patricecouillard-code/TrailerDiagnosticSystem/PCBReport.txt

Info: Processing symbol 'C201:SR305C334KAR:CAPRR508W50L762T381H762'.
Info: Processing symbol 'C202:FG26X7R1E106KRT06:CAPRB500W50L550T350H600'.
Info: Processing symbol 'C203:SR205C104KAR:CAPRR254W50L508T317H508'.
Info: Processing symbol 'C204:SR205C104KAR:CAPRR254W50L508T317H508'.
Info: Processing symbol 'C205:FG24X7R1H225KRT06:CAPRB500W50L450T300H550'.
Info: Processing symbol 'C206:CAPRR508W50L762T381H762:CAPRR508W50L762T381H762'.
Info: Processing symbol 'C207:FG26X7R1E106KRT06:CAPRB500W50L550T350H600'.
Info: Processing symbol 'C208:SR205C104KAR:CAPRR254W50L508T317H508'.
Info: Processing symbol 'C209:FG24X7R1H225KRT06:CAPRB500W50L450T300H550'.
Info: Processing symbol 'C210:SR205C104KAR:CAPRR254W50L508T317H508'.
Info: Processing symbol 'C301:Capacitor_THT:C_Rect_L19.0mm_W7.0mm_P15.00mm_MKS4'.
Info: Processing symbol 'C302:SR205C104KAR:CAPRR254W50L508T317H508'.
Info: Processing symbol 'C303:SR205C104KAR:CAPRR254W50L508T317H508'.
Info: Processing symbol 'C401:FG24X7R1H225KRT06:CAPRB500W50L450T300H550'.
Info: Processing symbol 'C2701:Capacitor_THT:C_Rect_L19.0mm_W7.0mm_P15.00mm_MKS4'.
Info: Processing symbol 'C3001:SR205C104KAR:CAPRR254W50L508T317H508'.
Info: Processing symbol 'D202:Diode_THT:D_DO-201AE_P15.24mm_Horizontal'.
Info: Processing symbol 'D204:PCM_Diode_THT_AKL:D_DO-35_SOD27_P7.62mm_Horizontal'.
Info: Processing symbol 'D501:PCM_Diode_THT_AKL:D_DO-35_SOD27_P7.62mm_Horizontal'.
Info: Processing symbol 'D502:PCM_Diode_THT_AKL:D_DO-35_SOD27_P7.62mm_Horizontal'.
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
Add Q3104 'Do not place' fabrication attribute.
Change Q2906 footprint from 'Package_TO_SOT_THT:TO-92_Inline' to 'PCM_Package_TO_SOT_THT_AKL:TO-92_Inline_Wide_SGD'.
Change Q3105 footprint from 'Package_TO_SOT_THT:TO-92_Inline' to 'PCM_Package_TO_SOT_THT_AKL:TO-92_Inline_Wide_SGD'.

Info: Total warnings: 0, errors: 0.
