patricecouillard-code/TrailerDiagnosticSystem/report - Copie.txt

Error: Update symbol D25 from 'OSX10201-GYR1.kicad_sym:OSX10201-GYR1' to 'OSX10201-GYR1.kicad_sym:OSX10201-GYR1': *** symbol not found ***
Update symbol U13 from 'Comparator:LM339' to 'Comparator:LM339': OK
Update symbol TH1 from 'Switch:SW_SPST_Temperature_NC' to 'Switch:SW_SPST_Temperature_NC': OK
Update symbol OC12 from 'PCM_Optocoupler_AKL:PC817' to 'PCM_Optocoupler_AKL:PC817': OK
Update symbol R206 from 'PCM_SL_Resistors:100k' to 'PCM_SL_Resistors:100k': OK
Update symbol D147 from 'PCM_LED_AKL:LED_1.8mm_Amber' to 'PCM_LED_AKL:LED_1.8mm_Amber': OK
Update symbol OC11 from 'PCM_Optocoupler_AKL:PC817' to 'PCM_Optocoupler_AKL:PC817': OK
Update symbol R195 from 'PCM_SL_Resistors:100k' to 'PCM_SL_Resistors:100k': OK
Update symbol R194 from 'PCM_SL_Resistors:4.7k' to 'PCM_SL_Resistors:4.7k': OK
Update symbol R207 from 'PCM_SL_Resistors:100k' to 'PCM_SL_Resistors:100k': OK
Update symbol Q54 from 'Transistor_FET:2N7000' to 'Transistor_FET:2N7000': OK
Update symbol R188 from 'PCM_SL_Devices:Resistor_5W' to 'PCM_SL_Devices:Resistor_5W': OK
Update symbol R205 from 'PCM_SL_Resistors:4.7k' to 'PCM_SL_Resistors:4.7k': OK
Update symbol U14 from 'Comparator:LM339' to 'Comparator:LM339': OK
Update symbol U14 from 'Comparator:LM339' to 'Comparator:LM339': OK
Update symbol R45 from 'PCM_SL_Resistors:4.7k' to 'PCM_SL_Resistors:4.7k': OK
Update symbol J3 from 'Connector_Generic:Conn_01x10' to 'Connector_Generic:Conn_01x10': OK
Update symbol J4 from 'Connector_Generic:Conn_01x10' to 'Connector_Generic:Conn_01x10': OK
Update symbol R203 from 'Simulation_SPICE:Potentiometer' to 'Simulation_SPICE:Potentiometer': OK
Update symbol D47 from 'PCM_Diode_AKL:1N4148' to 'PCM_Diode_AKL:1N4148': OK
Update symbol D41 from 'PCM_Diode_AKL:1N4148' to 'PCM_Diode_AKL:1N4148': OK
Update symbol D30 from 'PCM_Diode_AKL:1N4148' to 'PCM_Diode_AKL:1N4148': OK
Update symbol R41 from 'PCM_SL_Resistors:4.7k' to 'PCM_SL_Resistors:4.7k': OK
Update symbol U14 from 'Comparator:LM339' to 'Comparator:LM339': OK
Update symbol SW8 from 'Switch:SW_SPST' to 'Switch:SW_SPST': OK
Update symbol Q52 from 'PCM_Transistor_MOSFET_AKL:IRLZ44N' to 'PCM_Transistor_MOSFET_AKL:IRLZ44N': OK
Update symbol R66 from 'PCM_SL_Resistors:4.7k' to 'PCM_SL_Resistors:4.7k': OK
Update symbol D44 from 'PCM_Diode_AKL:1N4148' to 'PCM_Diode_AKL:1N4148': OK
Update symbol D28 from 'PCM_Diode_AKL:1N4148' to 'PCM_Diode_AKL:1N4148': OK
Update symbol #PWR03 from 'power:GND' to 'power:GND': OK
Update symbol R200 from 'PCM_SL_Resistors:10k' to 'PCM_SL_Resistors:10k': OK
Update symbol U14 from 'Comparator:LM339' to 'Comparator:LM339': OK
Update symbol D146 from 'PCM_Diode_TVS_AKL:SMBJ33A' to 'PCM_Diode_TVS_AKL:SMBJ33A': OK
Update symbol U14 from 'Comparator:LM339' to 'Comparator:LM339': OK
Update symbol F7 from 'Device:Polyfuse' to 'Device:Polyfuse': OK
Update symbol #PWR05 from 'power:GND' to 'power:GND': OK
Update symbol R204 from 'PCM_SL_Resistors:4.7k' to 'PCM_SL_Resistors:4.7k': OK
Update symbol R202 from 'Simulation_SPICE:Potentiometer' to 'Simulation_SPICE:Potentiometer': OK
Update symbol R201 from 'PCM_SL_Resistors:4.7k' to 'PCM_SL_Resistors:4.7k': OK
Update symbol R40 from 'PCM_SL_Resistors:4.7k' to 'PCM_SL_Resistors:4.7k': OK
Update symbol R51 from 'PCM_SL_Resistors:330ohm' to 'PCM_SL_Resistors:330ohm': OK
Update symbol D34 from 'PCM_Diode_AKL:1N4148' to 'PCM_Diode_AKL:1N4148': OK
Update symbol D38 from 'PCM_Diode_AKL:1N4148' to 'PCM_Diode_AKL:1N4148': OK
Update symbol Q13 from 'Transistor_FET:2N7000' to 'Transistor_FET:2N7000': OK
Update symbol D40 from 'PCM_Diode_AKL:1N4148' to 'PCM_Diode_AKL:1N4148': OK
Update symbol D42 from 'PCM_Diode_AKL:1N4148' to 'PCM_Diode_AKL:1N4148': OK
Update symbol R46 from 'PCM_SL_Resistors:4.7k' to 'PCM_SL_Resistors:4.7k': OK
Update symbol R50 from 'PCM_SL_Resistors:4.7k' to 'PCM_SL_Resistors:4.7k': OK
Update symbol R190 from 'PCM_SL_Resistors:4.7k' to 'PCM_SL_Resistors:4.7k': OK
Update symbol D49 from 'Device:LED_ARGB' to 'Device:LED_ARGB': OK
Update symbol R193 from 'PCM_SL_Resistors:4.7k' to 'PCM_SL_Resistors:4.7k': OK
Update symbol D27 from 'PCM_Diode_AKL:1N4148' to 'PCM_Diode_AKL:1N4148': OK
Update symbol D32 from 'PCM_Diode_AKL:1N4148' to 'PCM_Diode_AKL:1N4148': OK
Update symbol D46 from 'PCM_Diode_AKL:1N4148' to 'PCM_Diode_AKL:1N4148': OK
Update symbol R39 from 'PCM_SL_Resistors:4.7k' to 'PCM_SL_Resistors:4.7k': OK
Update symbol Q16 from 'Transistor_FET:2N7000' to 'Transistor_FET:2N7000': OK
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
Update symbol D110 from 'PCM_Diode_AKL:1N4148' to 'PCM_Diode_AKL:1N4148': OK
Update symbol D112 from 'PCM_Diode_AKL:1N4148' to 'PCM_Diode_AKL:1N4148': OK
Update symbol U9 from 'Comparator:LM339' to 'Comparator:LM339': OK
Update symbol U9 from 'Comparator:LM339' to 'Comparator:LM339': OK
Update symbol U9 from 'Comparator:LM339' to 'Comparator:LM339': OK
Update symbol D118 from 'PCM_Diode_AKL:1N4148' to 'PCM_Diode_AKL:1N4148': OK
Update symbol R132 from 'Simulation_SPICE:Potentiometer' to 'Simulation_SPICE:Potentiometer': OK
Update symbol U9 from 'Comparator:LM339' to 'Comparator:LM339': OK
Update symbol R123 from 'PCM_SL_Devices:Resistor_5W' to 'PCM_SL_Devices:Resistor_5W': OK
Update symbol R130 from 'PCM_SL_Resistors:10k' to 'PCM_SL_Resistors:10k': OK
Update symbol D104 from 'PCM_Diode_AKL:1N4148' to 'PCM_Diode_AKL:1N4148': OK
Update symbol R145 from 'PCM_SL_Resistors:4.7k' to 'PCM_SL_Resistors:4.7k': OK
Update symbol R140 from 'PCM_SL_Resistors:4.7k' to 'PCM_SL_Resistors:4.7k': OK
Update symbol R148 from 'PCM_SL_Resistors:4.7k' to 'PCM_SL_Resistors:4.7k': OK
Update symbol R128 from 'PCM_SL_Resistors:4.7k' to 'PCM_SL_Resistors:4.7k': OK
Update symbol Q35 from 'PCM_Transistor_MOSFET_AKL:IRLZ44N' to 'PCM_Transistor_MOSFET_AKL:IRLZ44N': OK
Update symbol R131 from 'Simulation_SPICE:Potentiometer' to 'Simulation_SPICE:Potentiometer': OK
Update symbol R122 from 'PCM_SL_Devices:Resistor_5W' to 'PCM_SL_Devices:Resistor_5W': OK
Update symbol D116 from 'PCM_Diode_AKL:1N4148' to 'PCM_Diode_AKL:1N4148': OK
Update symbol R152 from 'PCM_SL_Resistors:330ohm' to 'PCM_SL_Resistors:330ohm': OK
Update symbol Q39 from 'Transistor_FET:2N7000' to 'Transistor_FET:2N7000': OK
Update symbol Q41 from 'Transistor_FET:2N7000' to 'Transistor_FET:2N7000': OK
Update symbol R153 from 'PCM_SL_Resistors:330ohm' to 'PCM_SL_Resistors:330ohm': OK
Update symbol Q38 from 'Transistor_FET:2N7000' to 'Transistor_FET:2N7000': OK
Update symbol D105 from 'PCM_Diode_AKL:1N4148' to 'PCM_Diode_AKL:1N4148': OK
Update symbol D121 from 'Device:LED_ARGB' to 'Device:LED_ARGB': OK
Update symbol R146 from 'PCM_SL_Resistors:4.7k' to 'PCM_SL_Resistors:4.7k': OK
Update symbol D113 from 'PCM_Diode_AKL:1N4148' to 'PCM_Diode_AKL:1N4148': OK
Update symbol R147 from 'PCM_SL_Resistors:4.7k' to 'PCM_SL_Resistors:4.7k': OK
Update symbol D108 from 'PCM_Diode_AKL:1N4148' to 'PCM_Diode_AKL:1N4148': OK
Update symbol D101 from 'PCM_Diode_AKL:1N4148' to 'PCM_Diode_AKL:1N4148': OK
Update symbol R150 from 'PCM_SL_Resistors:4.7k' to 'PCM_SL_Resistors:4.7k': OK
Update symbol R144 from 'PCM_SL_Resistors:4.7k' to 'PCM_SL_Resistors:4.7k': OK
Update symbol R151 from 'PCM_SL_Resistors:4.7k' to 'PCM_SL_Resistors:4.7k': OK
Update symbol R221 from 'PCM_SL_Devices:Resistor_10W' to 'PCM_SL_Devices:Resistor_10W': OK
Update symbol R222 from 'PCM_SL_Resistors:4.7k' to 'PCM_SL_Resistors:4.7k': OK
Update symbol #PWR011 from 'power:GND' to 'power:GND': OK
Update symbol Q1 from 'PCM_Transistor_MOSFET_AKL:IRLZ44N' to 'PCM_Transistor_MOSFET_AKL:IRLZ44N': OK
Update symbol U17 from 'Driver_LED:LM3914N' to 'Driver_LED:LM3914N': OK
Update symbol U16 from 'Comparator:LM339' to 'Comparator:LM339': OK
Update symbol #PWR04 from 'power:GND' to 'power:GND': OK
Update symbol U6 from 'PCM_Voltage_Regulator_AKL:LM7805CT' to 'PCM_Voltage_Regulator_AKL:LM7805CT': OK
Update symbol #FLG01 from 'power:PWR_FLAG' to 'power:PWR_FLAG': OK
Update symbol R217 from 'PCM_SL_Resistors:4.7k' to 'PCM_SL_Resistors:4.7k': OK
Update symbol R216 from '3296W-1-103LF:3296W1103LF' to '3296W-1-103LF:3296W1103LF': OK
Update symbol R231 from 'PCM_SL_Resistors:4.7k' to 'PCM_SL_Resistors:4.7k': OK
Update symbol C4 from 'TrailerDiagSymbols:SR205E104MARAP1' to 'TrailerDiagSymbols:SR205E104MARAP1': OK
Update symbol R213 from 'PCM_SL_Resistors:100ohm' to 'PCM_SL_Resistors:100ohm': OK
Update symbol #PWR016 from 'power:GND' to 'power:GND': OK
Update symbol U16 from 'Comparator:LM339' to 'Comparator:LM339': OK
Update symbol Q65 from 'PCM_Transistor_MOSFET_AKL:2N7000' to 'PCM_Transistor_MOSFET_AKL:2N7000': OK
Update symbol #PWR018 from 'power:GND' to 'power:GND': OK
Update symbol Q56 from 'PCM_Transistor_MOSFET_AKL:2N7000' to 'PCM_Transistor_MOSFET_AKL:2N7000': OK
Update symbol #PWR019 from 'power:GND' to 'power:GND': OK
Update symbol #PWR014 from 'power:GND' to 'power:GND': OK
Update symbol R215 from 'PCM_SL_Resistors:10k' to 'PCM_SL_Resistors:10k': OK
Update symbol #PWR022 from 'power:GND' to 'power:GND': OK
Update symbol BMS3s1 from 'TrailerDiagSymbols:BMS_3S' to 'TrailerDiagSymbols:BMS_3S': OK
Update symbol R230 from 'PCM_SL_Resistors:4.7k' to 'PCM_SL_Resistors:4.7k': OK
Update symbol #FLG03 from 'power:PWR_FLAG' to 'power:PWR_FLAG': OK
Update symbol #PWR010 from 'power:GND' to 'power:GND': OK
Update symbol BT2 from 'Device:Battery_Cell' to 'Device:Battery_Cell': OK
Update symbol #PWR01 from 'power:GND' to 'power:GND': OK
Update symbol R214 from 'PCM_SL_Resistors:100k' to 'PCM_SL_Resistors:100k': OK
Update symbol #PWR023 from 'power:GND' to 'power:GND': OK
Update symbol Q57 from 'PCM_Transistor_MOSFET_AKL:2N7000' to 'PCM_Transistor_MOSFET_AKL:2N7000': OK
Update symbol #PWR017 from 'power:GND' to 'power:GND': OK
Update symbol Q64 from 'PCM_Transistor_MOSFET_AKL:IRLZ44N' to 'PCM_Transistor_MOSFET_AKL:IRLZ44N': OK
Update symbol P1 from 'Connector:Conn_Plug_2P' to 'Connector:Conn_Plug_2P': OK
Update symbol R154 from 'PCM_SL_Resistors:330ohm' to 'PCM_SL_Resistors:330ohm': OK
Update symbol R98 from 'Simulation_SPICE:Potentiometer' to 'Simulation_SPICE:Potentiometer': OK
Update symbol U7 from 'Comparator:LM339' to 'Comparator:LM339': OK
Update symbol OC5 from 'PCM_Optocoupler_AKL:PC817' to 'PCM_Optocoupler_AKL:PC817': OK
Update symbol Q27 from 'PCM_Transistor_MOSFET_AKL:IRLZ44N' to 'PCM_Transistor_MOSFET_AKL:IRLZ44N': OK
Update symbol U7 from 'Comparator:LM339' to 'Comparator:LM339': OK
Update symbol R169 from 'Simulation_SPICE:Potentiometer' to 'Simulation_SPICE:Potentiometer': OK
Update symbol R106 from 'PCM_SL_Resistors:4.7k' to 'PCM_SL_Resistors:4.7k': OK
Update symbol R114 from 'PCM_SL_Resistors:4.7k' to 'PCM_SL_Resistors:4.7k': OK
Update symbol D81 from 'PCM_Diode_AKL:1N4148' to 'PCM_Diode_AKL:1N4148': OK
Update symbol D97 from 'Device:LED_ARGB' to 'Device:LED_ARGB': OK
Update symbol U8 from 'Comparator:LM339' to 'Comparator:LM339': OK
Update symbol U12 from 'Comparator:LM339' to 'Comparator:LM339': OK
Update symbol U12 from 'Comparator:LM339' to 'Comparator:LM339': OK
Update symbol R103 from 'Simulation_SPICE:Potentiometer' to 'Simulation_SPICE:Potentiometer': OK
Update symbol Q28 from 'PCM_Transistor_MOSFET_AKL:IRLZ44N' to 'PCM_Transistor_MOSFET_AKL:IRLZ44N': OK
Update symbol R96 from 'PCM_SL_Resistors:100k' to 'PCM_SL_Resistors:100k': OK
Update symbol R90 from 'PCM_SL_Devices:Resistor_5W' to 'PCM_SL_Devices:Resistor_5W': OK
Update symbol R94 from 'PCM_SL_Resistors:4.7k' to 'PCM_SL_Resistors:4.7k': OK
Update symbol R93 from 'PCM_SL_Resistors:4.7k' to 'PCM_SL_Resistors:4.7k': OK
Update symbol U7 from 'Comparator:LM339' to 'Comparator:LM339': OK
Update symbol R170 from 'Simulation_SPICE:Potentiometer' to 'Simulation_SPICE:Potentiometer': OK
Update symbol SW5 from 'Switch:SW_SPST' to 'Switch:SW_SPST': OK
Update symbol R91 from 'PCM_SL_Resistors:4.7k' to 'PCM_SL_Resistors:4.7k': OK
Update symbol D94 from 'PCM_Diode_AKL:1N4148' to 'PCM_Diode_AKL:1N4148': OK
Update symbol D90 from 'PCM_Diode_AKL:1N4148' to 'PCM_Diode_AKL:1N4148': OK
Update symbol Q31 from 'Transistor_FET:2N7000' to 'Transistor_FET:2N7000': OK
Update symbol R121 from 'PCM_SL_Resistors:330ohm' to 'PCM_SL_Resistors:330ohm': OK
Update symbol D87 from 'PCM_Diode_AKL:1N4148' to 'PCM_Diode_AKL:1N4148': OK
Update symbol F6 from 'Device:Polyfuse' to 'Device:Polyfuse': OK
Update symbol U8 from 'Comparator:LM339' to 'Comparator:LM339': OK
Update symbol R100 from 'Simulation_SPICE:Potentiometer' to 'Simulation_SPICE:Potentiometer': OK
Update symbol R167 from 'PCM_SL_Resistors:10k' to 'PCM_SL_Resistors:10k': OK
Update symbol F4 from 'Device:Polyfuse' to 'Device:Polyfuse': OK
Update symbol U8 from 'Comparator:LM339' to 'Comparator:LM339': OK
Update symbol R102 from 'PCM_SL_Resistors:4.7k' to 'PCM_SL_Resistors:4.7k': OK
Update symbol SW7 from 'Switch:SW_SPST' to 'Switch:SW_SPST': OK
Update symbol U8 from 'Comparator:LM339' to 'Comparator:LM339': OK
Update symbol R99 from 'Simulation_SPICE:Potentiometer' to 'Simulation_SPICE:Potentiometer': OK
Update symbol U8 from 'Comparator:LM339' to 'Comparator:LM339': OK
Update symbol D74 from 'PCM_Diode_TVS_AKL:SMBJ33A' to 'PCM_Diode_TVS_AKL:SMBJ33A': OK
Update symbol U7 from 'Comparator:LM339' to 'Comparator:LM339': OK
Update symbol U7 from 'Comparator:LM339' to 'Comparator:LM339': OK
Update symbol U12 from 'Comparator:LM339' to 'Comparator:LM339': OK
Update symbol R104 from 'Simulation_SPICE:Potentiometer' to 'Simulation_SPICE:Potentiometer': OK
Update symbol R89 from 'PCM_SL_Devices:Resistor_5W' to 'PCM_SL_Devices:Resistor_5W': OK
Update symbol R105 from 'PCM_SL_Resistors:4.7k' to 'PCM_SL_Resistors:4.7k': OK
Update symbol R101 from 'PCM_SL_Resistors:10k' to 'PCM_SL_Resistors:10k': OK
Update symbol R97 from 'PCM_SL_Resistors:10k' to 'PCM_SL_Resistors:10k': OK
Update symbol R95 from 'PCM_SL_Resistors:4.7k' to 'PCM_SL_Resistors:4.7k': OK
Update symbol R92 from 'PCM_SL_Resistors:4.7k' to 'PCM_SL_Resistors:4.7k': OK
Update symbol OC6 from 'PCM_Optocoupler_AKL:PC817' to 'PCM_Optocoupler_AKL:PC817': OK
Update symbol R112 from 'PCM_SL_Resistors:4.7k' to 'PCM_SL_Resistors:4.7k': OK
Update symbol D77 from 'PCM_Diode_AKL:1N4148' to 'PCM_Diode_AKL:1N4148': OK
Update symbol R118 from 'PCM_SL_Resistors:4.7k' to 'PCM_SL_Resistors:4.7k': OK
Update symbol R115 from 'PCM_SL_Resistors:4.7k' to 'PCM_SL_Resistors:4.7k': OK
Update symbol D91 from 'PCM_Diode_AKL:1N4148' to 'PCM_Diode_AKL:1N4148': OK
Update symbol R119 from 'PCM_SL_Resistors:330ohm' to 'PCM_SL_Resistors:330ohm': OK
Update symbol R113 from 'PCM_SL_Resistors:4.7k' to 'PCM_SL_Resistors:4.7k': OK
Update symbol Q30 from 'Transistor_FET:2N7000' to 'Transistor_FET:2N7000': OK
Update symbol D75 from 'PCM_Diode_AKL:1N4148' to 'PCM_Diode_AKL:1N4148': OK
Update symbol R120 from 'PCM_SL_Resistors:330ohm' to 'PCM_SL_Resistors:330ohm': OK
Update symbol Q32 from 'Transistor_FET:2N7000' to 'Transistor_FET:2N7000': OK
Update symbol D93 from 'PCM_Diode_AKL:1N4148' to 'PCM_Diode_AKL:1N4148': OK
Update symbol D80 from 'PCM_Diode_AKL:1N4148' to 'PCM_Diode_AKL:1N4148': OK
Update symbol D92 from 'PCM_Diode_AKL:1N4148' to 'PCM_Diode_AKL:1N4148': OK
Update symbol SW6 from 'Switch:SW_SPST' to 'Switch:SW_SPST': OK
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
Update symbol R76 from 'PCM_SL_Resistors:4.7k' to 'PCM_SL_Resistors:4.7k': OK
Update symbol U4 from 'Comparator:LM339' to 'Comparator:LM339': OK
Update symbol R64 from 'PCM_SL_Devices:Resistor_5W' to 'PCM_SL_Devices:Resistor_5W': OK
Update symbol R55 from 'PCM_SL_Resistors:4.7k' to 'PCM_SL_Resistors:4.7k': OK
Update symbol R60 from 'PCM_SL_Resistors:10k' to 'PCM_SL_Resistors:10k': OK
Update symbol R56 from 'PCM_SL_Resistors:4.7k' to 'PCM_SL_Resistors:4.7k': OK
Update symbol R79 from 'PCM_SL_Resistors:4.7k' to 'PCM_SL_Resistors:4.7k': OK
Update symbol R175 from 'PCM_SL_Resistors:4.7k' to 'PCM_SL_Resistors:4.7k': OK
Update symbol U15 from 'Comparator:LM339' to 'Comparator:LM339': OK
Update symbol R182 from 'PCM_SL_Resistors:4.7k' to 'PCM_SL_Resistors:4.7k': OK
Update symbol R181 from 'PCM_SL_Resistors:4.7k' to 'PCM_SL_Resistors:4.7k': OK
Update symbol D128 from 'PCM_Diode_AKL:1N4148' to 'PCM_Diode_AKL:1N4148': OK
Update symbol D136 from 'PCM_Diode_AKL:1N4148' to 'PCM_Diode_AKL:1N4148': OK
Update symbol R196 from 'PCM_SL_Resistors:10k' to 'PCM_SL_Resistors:10k': OK
Update symbol R211 from 'PCM_SL_Resistors:330ohm' to 'PCM_SL_Resistors:330ohm': OK
Update symbol Q51 from 'PCM_Transistor_MOSFET_AKL:IRLZ44N' to 'PCM_Transistor_MOSFET_AKL:IRLZ44N': OK
Update symbol R186 from 'PCM_SL_Resistors:330ohm' to 'PCM_SL_Resistors:330ohm': OK
Update symbol Q45 from 'Transistor_FET:2N7000' to 'Transistor_FET:2N7000': OK
Update symbol D145 from 'Device:LED_ARGB' to 'Device:LED_ARGB': OK
Update symbol Q53 from 'Transistor_FET:2N7000' to 'Transistor_FET:2N7000': OK
Update symbol D135 from 'PCM_Diode_AKL:1N4148' to 'PCM_Diode_AKL:1N4148': OK
Update symbol R178 from 'PCM_SL_Resistors:4.7k' to 'PCM_SL_Resistors:4.7k': OK
Update symbol U13 from 'Comparator:LM339' to 'Comparator:LM339': OK
Update symbol U15 from 'Comparator:LM339' to 'Comparator:LM339': OK
Update symbol R210 from '3296W-1-103LF:3296W1103LF' to '3296W-1-103LF:3296W1103LF': OK
Update symbol U15 from 'Comparator:LM339' to 'Comparator:LM339': OK
Update symbol D149 from 'PCM_Diode_AKL:1N4148' to 'PCM_Diode_AKL:1N4148': OK
Update symbol D139 from 'PCM_Diode_AKL:1N4148' to 'PCM_Diode_AKL:1N4148': OK
Update symbol D131 from 'PCM_Diode_AKL:1N4148' to 'PCM_Diode_AKL:1N4148': OK
Update symbol D151 from 'PCM_LED_AKL:LED_2x5mm_Horizontal_Red' to 'PCM_LED_AKL:LED_2x5mm_Horizontal_Red': OK
Update symbol R185 from 'PCM_SL_Resistors:330ohm' to 'PCM_SL_Resistors:330ohm': OK
Update symbol U13 from 'Comparator:LM339' to 'Comparator:LM339': OK
Update symbol U15 from 'Comparator:LM339' to 'Comparator:LM339': OK
Update symbol Q49 from 'Transistor_FET:2N7000' to 'Transistor_FET:2N7000': OK
Update symbol R197 from 'Simulation_SPICE:Potentiometer' to 'Simulation_SPICE:Potentiometer': OK
Update symbol R180 from 'PCM_SL_Resistors:4.7k' to 'PCM_SL_Resistors:4.7k': OK
Update symbol R189 from 'PCM_SL_Devices:Resistor_5W' to 'PCM_SL_Devices:Resistor_5W': OK
Update symbol U15 from 'Comparator:LM339' to 'Comparator:LM339': OK
Update symbol Q47 from 'Transistor_FET:2N7000' to 'Transistor_FET:2N7000': OK
Update symbol R191 from 'PCM_SL_Resistors:4.7k' to 'PCM_SL_Resistors:4.7k': OK
Update symbol R199 from 'Simulation_SPICE:Potentiometer' to 'Simulation_SPICE:Potentiometer': OK
Update symbol D150 from 'PCM_Diode_AKL:1N4148' to 'PCM_Diode_AKL:1N4148': OK
Update symbol R208 from 'PCM_SL_Resistors:330ohm' to 'PCM_SL_Resistors:330ohm': OK
Update symbol D124 from 'PCM_Diode_AKL:1N4148' to 'PCM_Diode_AKL:1N4148': OK
Update symbol R183 from 'PCM_SL_Resistors:4.7k' to 'PCM_SL_Resistors:4.7k': OK
Update symbol R187 from 'PCM_SL_Resistors:330ohm' to 'PCM_SL_Resistors:330ohm': OK
Update symbol R173 from 'PCM_SL_Resistors:4.7k' to 'PCM_SL_Resistors:4.7k': OK
Update symbol D134 from 'PCM_Diode_AKL:1N4148' to 'PCM_Diode_AKL:1N4148': OK
Update symbol R174 from 'PCM_SL_Resistors:4.7k' to 'PCM_SL_Resistors:4.7k': OK
Update symbol D143 from 'PCM_Diode_AKL:1N4148' to 'PCM_Diode_AKL:1N4148': OK
Update symbol Q48 from 'Transistor_FET:2N7000' to 'Transistor_FET:2N7000': OK
Update symbol U13 from 'Comparator:LM339' to 'Comparator:LM339': OK
Update symbol R192 from 'PCM_SL_Resistors:4.7k' to 'PCM_SL_Resistors:4.7k': OK
Update symbol R209 from 'PCM_SL_Resistors:330ohm' to 'PCM_SL_Resistors:330ohm': OK
Update symbol D127 from 'PCM_Diode_AKL:1N4148' to 'PCM_Diode_AKL:1N4148': OK
Update symbol D137 from 'PCM_Diode_AKL:1N4148' to 'PCM_Diode_AKL:1N4148': OK
Update symbol Q50 from 'Transistor_FET:2N7000' to 'Transistor_FET:2N7000': OK
Update symbol Q46 from 'Transistor_FET:2N7000' to 'Transistor_FET:2N7000': OK
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
Update symbol R6 from 'PCM_SL_Resistors:4.7k' to 'PCM_SL_Resistors:4.7k': OK
Update symbol R24 from 'Simulation_SPICE:Potentiometer' to 'Simulation_SPICE:Potentiometer': OK
Update symbol R27 from 'PCM_SL_Resistors:4.7k' to 'PCM_SL_Resistors:4.7k': OK
Update symbol OC1 from 'PCM_Optocoupler_AKL:PC817' to 'PCM_Optocoupler_AKL:PC817': OK
Update symbol Q11 from 'PCM_Transistor_MOSFET_AKL:IRLZ44N' to 'PCM_Transistor_MOSFET_AKL:IRLZ44N': OK
Update symbol R38 from 'PCM_SL_Resistors:10k' to 'PCM_SL_Resistors:10k': OK
Update symbol U2 from 'Comparator:LM339' to 'Comparator:LM339': OK
Update symbol R20 from 'PCM_SL_Resistors:4.7k' to 'PCM_SL_Resistors:4.7k': OK
Update symbol D22 from 'PCM_Diode_AKL:1N4148' to 'PCM_Diode_AKL:1N4148': OK
Update symbol R18 from 'PCM_SL_Resistors:330ohm' to 'PCM_SL_Resistors:330ohm': OK
Update symbol R37 from 'PCM_SL_Resistors:100k' to 'PCM_SL_Resistors:100k': OK
Update symbol R21 from 'PCM_SL_Devices:Resistor_5W' to 'PCM_SL_Devices:Resistor_5W': OK
Update symbol U2 from 'Comparator:LM339' to 'Comparator:LM339': OK
Update symbol R22 from 'PCM_SL_Devices:Resistor_5W' to 'PCM_SL_Devices:Resistor_5W': OK
Update symbol #PWR012 from 'power:GND' to 'power:GND': OK
Update symbol C2 from 'TrailerDiagSymbols:SR305C334KAR' to 'TrailerDiagSymbols:SR305C334KAR': OK
Update symbol R218 from 'PCM_SL_Resistors:4.7k' to 'PCM_SL_Resistors:4.7k': OK
Update symbol #PWR02 from 'power:GND' to 'power:GND': OK
Update symbol BT3 from 'Device:Battery_Cell' to 'Device:Battery_Cell': OK
Update symbol R212 from 'PCM_SL_Resistors:1k' to 'PCM_SL_Resistors:1k': OK
Update symbol Q55 from 'PCM_Transistor_BJT_AKL:2N3906' to 'PCM_Transistor_BJT_AKL:2N3906': OK
Update symbol SW1 from 'Switch:SW_DPDT_x2' to 'Switch:SW_DPDT_x2': OK
Update symbol D153 from 'PCM_Diode_AKL:1N4148' to 'PCM_Diode_AKL:1N4148': OK
Update symbol U1 from 'LM74610QDGKRQ1:LM74610QDGKRQ1' to 'LM74610QDGKRQ1:LM74610QDGKRQ1': OK
Update symbol C1 from 'PCM_SL_Capacitors:2.2uF_50V' to 'PCM_SL_Capacitors:2.2uF_50V': OK
Update symbol #PWR013 from 'power:GND' to 'power:GND': OK
Update symbol #PWR021 from 'power:GND' to 'power:GND': OK
Update symbol R219 from 'PCM_SL_Resistors:10k' to 'PCM_SL_Resistors:10k': OK
Update symbol F1 from 'Device:Fuse' to 'Device:Fuse': OK
Update symbol #PWR07 from 'power:GND' to 'power:GND': OK
Update symbol U16 from 'Comparator:LM339' to 'Comparator:LM339': OK
Update symbol D1 from 'PCM_Diode_AKL:1N4148' to 'PCM_Diode_AKL:1N4148': OK
Update symbol U16 from 'Comparator:LM339' to 'Comparator:LM339': OK
Update symbol U16 from 'Comparator:LM339' to 'Comparator:LM339': OK
Update symbol SW1 from 'Switch:SW_DPDT_x2' to 'Switch:SW_DPDT_x2': OK
Update symbol R220 from 'PCM_SL_Resistors:4.7k' to 'PCM_SL_Resistors:4.7k': OK
Update symbol Q2 from 'PCM_Transistor_BJT_AKL:2N3904' to 'PCM_Transistor_BJT_AKL:2N3904': OK
Update symbol #PWR09 from 'power:GND' to 'power:GND': OK
Update symbol #PWR015 from 'power:GND' to 'power:GND': OK
Update symbol R2 from 'PCM_SL_Resistors:10k' to 'PCM_SL_Resistors:10k': OK
Update symbol Q3 from 'PCM_Transistor_BJT_AKL:2N3904' to 'PCM_Transistor_BJT_AKL:2N3904': OK
Update symbol J2 from 'PCM_SL_Screw_Terminal:Screw_Terminal_2_P3.50mm' to 'PCM_SL_Screw_Terminal:Screw_Terminal_2_P3.50mm': OK
Update symbol #PWR020 from 'power:GND' to 'power:GND': OK
Update symbol C3 from 'TrailerDiagSymbols:FG26X7R1E106KRT06' to 'TrailerDiagSymbols:FG26X7R1E106KRT06': OK
Update symbol SW2 from 'Switch:SW_DPDT_x2' to 'Switch:SW_DPDT_x2': OK
Update symbol R3 from 'PCM_SL_Resistors:10k' to 'PCM_SL_Resistors:10k': OK
Update symbol C5 from 'TrailerDiagSymbols:SR205E104MARAP1' to 'TrailerDiagSymbols:SR205E104MARAP1': OK
Update symbol SW2 from 'Switch:SW_DPDT_x2' to 'Switch:SW_DPDT_x2': OK
Update symbol D152 from 'PCM_LED_AKL:LED_2x5mm_Horizontal_Red' to 'PCM_LED_AKL:LED_2x5mm_Horizontal_Red': OK
Update symbol BT1 from 'Device:Battery_Cell' to 'Device:Battery_Cell': OK
Update symbol #FLG02 from 'power:PWR_FLAG' to 'power:PWR_FLAG': OK
Update symbol Q62 from 'Transistor_FET:2N7000' to 'Transistor_FET:2N7000': OK
Update symbol Q63 from 'Transistor_FET:2N7000' to 'Transistor_FET:2N7000': OK
Update symbol D154 from 'PCM_LED_AKL:LED_2x5mm_Horizontal_Red' to 'PCM_LED_AKL:LED_2x5mm_Horizontal_Red': OK
Update symbol Q58 from 'Transistor_FET:2N7000' to 'Transistor_FET:2N7000': OK
Update symbol R226 from 'PCM_SL_Resistors:1k' to 'PCM_SL_Resistors:1k': OK
Update symbol D166 from 'PCM_Diode_AKL:1N4148' to 'PCM_Diode_AKL:1N4148': OK
Update symbol Q59 from 'Transistor_FET:2N7000' to 'Transistor_FET:2N7000': OK
Update symbol D168 from 'PCM_Diode_AKL:1N4148' to 'PCM_Diode_AKL:1N4148': OK
Update symbol BZ1 from 'Device:Buzzer' to 'Device:Buzzer': OK
Update symbol Q60 from 'Transistor_FET:2N7000' to 'Transistor_FET:2N7000': OK
Update symbol R227 from 'PCM_SL_Resistors:1k' to 'PCM_SL_Resistors:1k': OK
Update symbol R224 from 'PCM_SL_Resistors:1k' to 'PCM_SL_Resistors:1k': OK
Update symbol R229 from 'PCM_SL_Resistors:1k' to 'PCM_SL_Resistors:1k': OK
Update symbol D163 from 'PCM_Diode_AKL:1N4148' to 'PCM_Diode_AKL:1N4148': OK
Update symbol D164 from 'PCM_Diode_AKL:1N4148' to 'PCM_Diode_AKL:1N4148': OK
Update symbol D155 from 'PCM_LED_AKL:LED_2x5mm_Horizontal_Red' to 'PCM_LED_AKL:LED_2x5mm_Horizontal_Red': OK
Update symbol D167 from 'PCM_Diode_AKL:1N4148' to 'PCM_Diode_AKL:1N4148': OK
Update symbol R223 from 'PCM_SL_Resistors:1k' to 'PCM_SL_Resistors:1k': OK
Update symbol D160 from 'PCM_Diode_AKL:1N4148' to 'PCM_Diode_AKL:1N4148': OK
Update symbol R225 from 'PCM_SL_Resistors:1k' to 'PCM_SL_Resistors:1k': OK
Update symbol D158 from 'PCM_LED_AKL:LED_2x5mm_Horizontal_Red' to 'PCM_LED_AKL:LED_2x5mm_Horizontal_Red': OK
Update symbol D156 from 'PCM_LED_AKL:LED_2x5mm_Horizontal_Red' to 'PCM_LED_AKL:LED_2x5mm_Horizontal_Red': OK
Update symbol D161 from 'PCM_Diode_AKL:1N4148' to 'PCM_Diode_AKL:1N4148': OK
Update symbol D162 from 'PCM_Diode_AKL:1N4148' to 'PCM_Diode_AKL:1N4148': OK
Update symbol D157 from 'PCM_LED_AKL:LED_2x5mm_Horizontal_Red' to 'PCM_LED_AKL:LED_2x5mm_Horizontal_Red': OK
Update symbol R228 from 'PCM_SL_Resistors:1k' to 'PCM_SL_Resistors:1k': OK
Update symbol Q61 from 'Transistor_FET:2N7000' to 'Transistor_FET:2N7000': OK
Update symbol D159 from 'PCM_Diode_AKL:1N4148' to 'PCM_Diode_AKL:1N4148': OK
Update symbol D165 from 'PCM_Diode_AKL:1N4148' to 'PCM_Diode_AKL:1N4148': OK
Update symbol R233 from 'PCM_SL_Resistors:10k' to 'PCM_SL_Resistors:10k': OK
Update symbol R234 from 'PCM_SL_Devices:Resistor_5W' to 'PCM_SL_Devices:Resistor_5W': OK
Update symbol #PWR024 from 'power:GND' to 'power:GND': OK
Update symbol #PWR025 from 'power:GND' to 'power:GND': OK
Update symbol #PWR026 from 'power:GND' to 'power:GND': OK
Update symbol C6 from 'TrailerDiagSymbols:SR205E104MARAP1' to 'TrailerDiagSymbols:SR205E104MARAP1': OK
Update symbol #PWR027 from 'power:GND' to 'power:GND': OK
Update symbol R36 from 'PCM_SL_Resistors:1.5k' to 'PCM_SL_Resistors:1.5k': OK
Update symbol R53 from 'PCM_SL_Resistors:3.9k' to 'PCM_SL_Resistors:3.9k': OK
Update symbol R232 from 'PCM_SL_Resistors:18k' to 'PCM_SL_Resistors:18k': OK
Update symbol VR1 from '3296-1-102lf:3296W-1-102LF' to '3296-1-102lf:3296W-1-102LF': OK
