patricecouillard-code/TrailerDiagnosticSystem/FG24X7R1H225KRT06.step

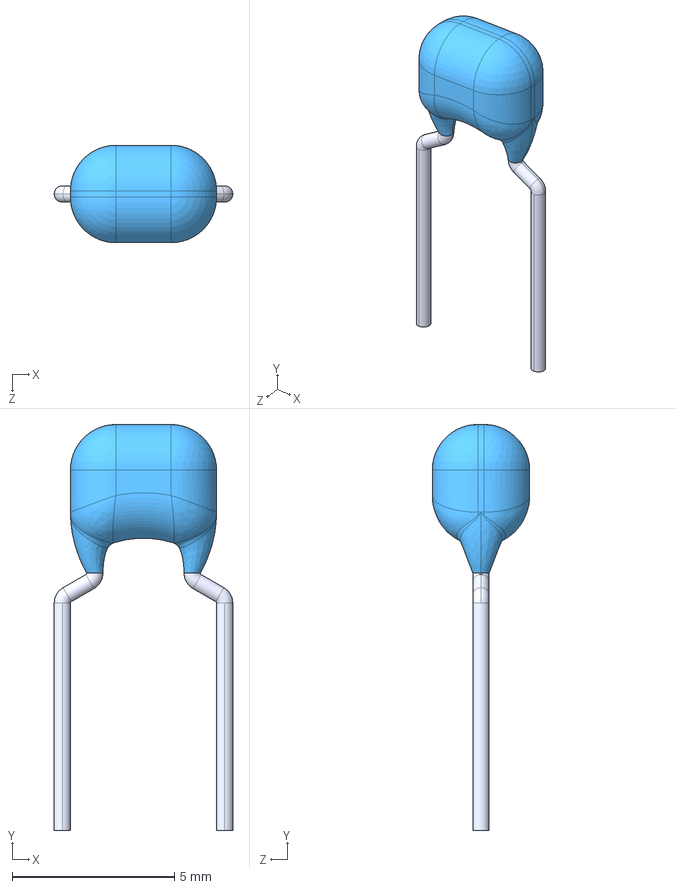
[picture p1: CAD file, 2026-10-16]
FG24X7R1H225KRT06.step
5.50 x 12.5 x 3.00 mm
