patricecouillard-code/TrailerDiagnosticSystem/TMR_2-1211WIN.step

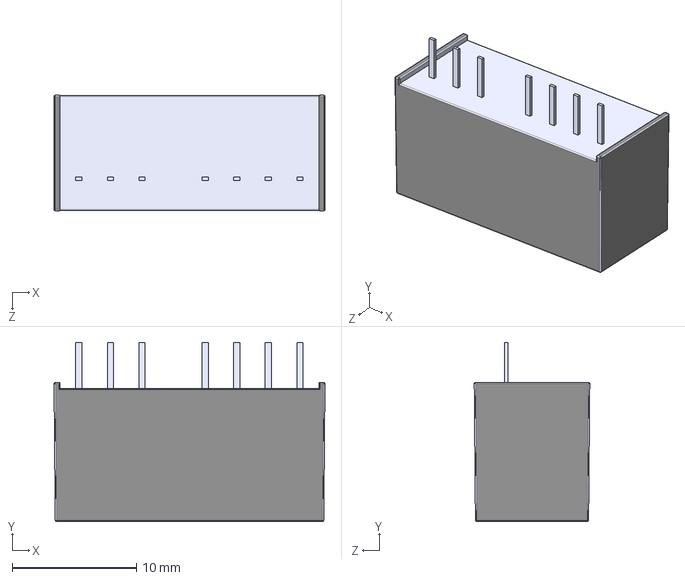
[picture p2: CAD file, 2026-09-30]
TMR_2-1211WIN.step
21.8 x 14.4 x 9.30 mm
