patricecouillard-code/TrailerDiagnosticSystem/3296W-1-102LF.step

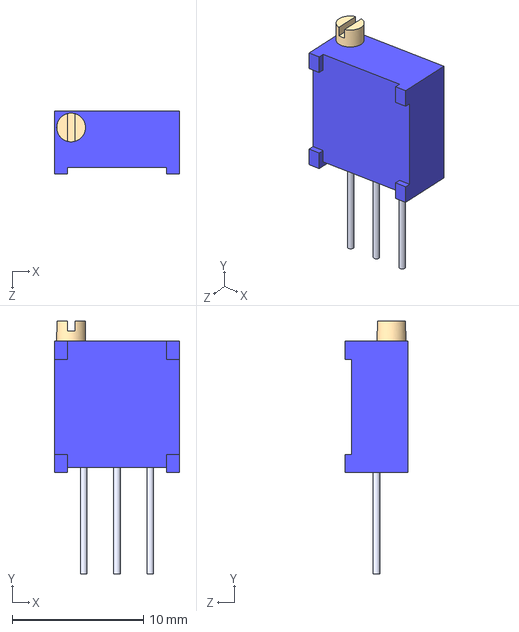
[picture p3: CAD file, 2026-08-30]
3296W-1-102LF.step
9.53 x 19.3 x 4.83 mm
