patricecouillard-code/TrailerDiagnosticSystem/FG26X7R1E106KRT06.step

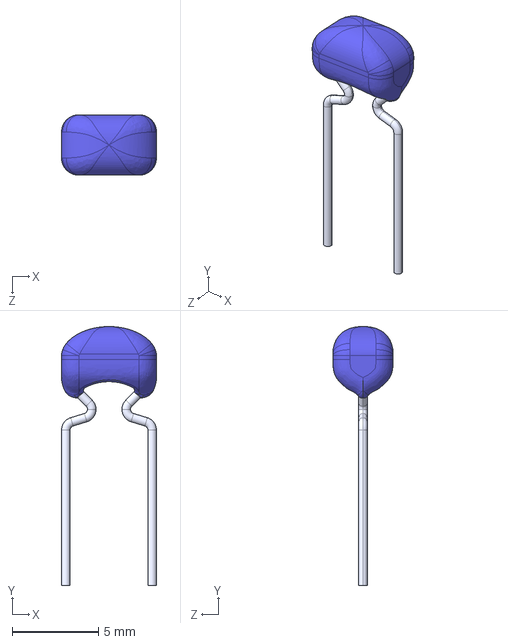
[picture p4: CAD file, 2026-08-22]
FG26X7R1E106KRT06.step
5.50 x 15.0 x 3.50 mm
