patricecouillard-code/TrailerDiagnosticSystem/SR655C106KAR.step

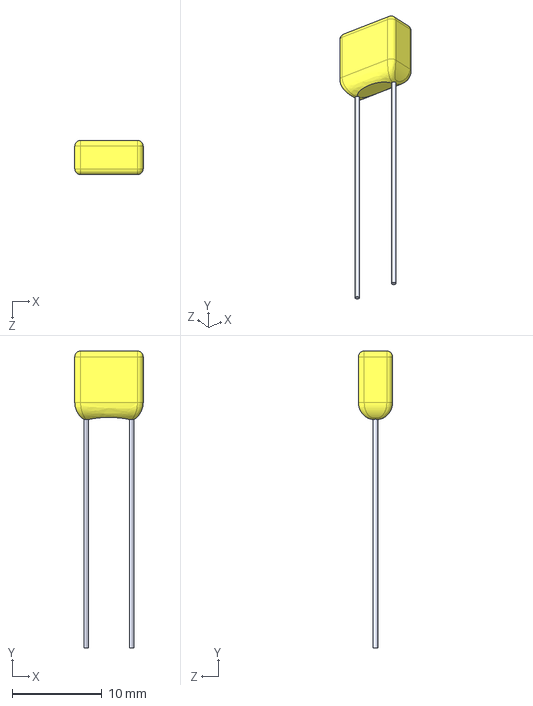
[picture p5: CAD file, 2026-08-22]
SR655C106KAR.step
7.62 x 33.0 x 3.81 mm
