patricecouillard-code/TrailerDiagnosticSystem/SR205E104MARAP1.step

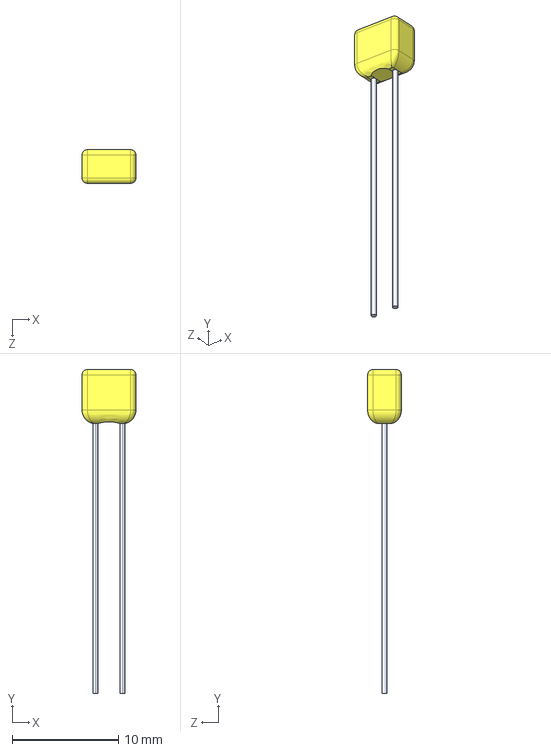
[picture p6: CAD file, 2026-08-22]
SR205E104MARAP1.step
5.08 x 30.5 x 3.17 mm
