patricecouillard-code/TrailerDiagnosticSystem/OSX10201-GYR1.step

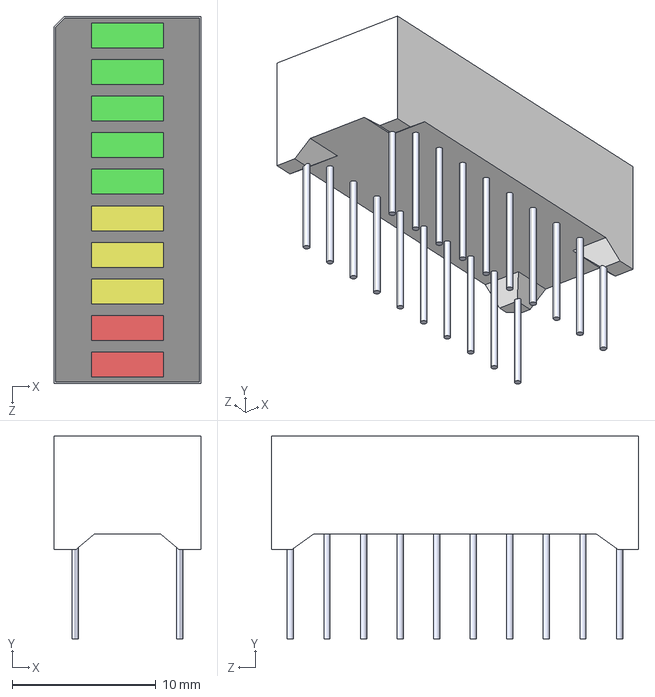
[picture p7: CAD file, 2026-09-13]
OSX10201-GYR1.step
10.2 x 14.1 x 25.5 mm
