patricecouillard-code/TrailerDiagnosticSystem/LM74610QDGKRQ1.step

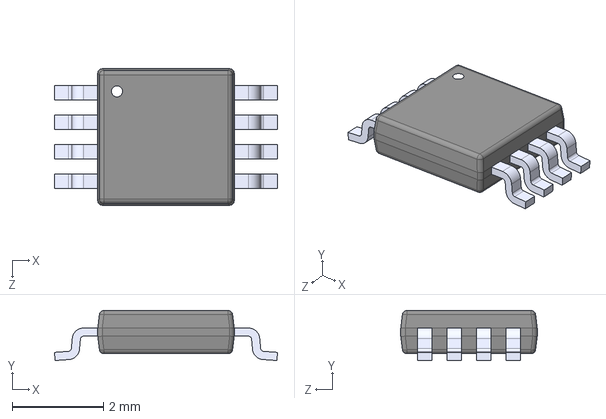
[picture p8: CAD file, 2026-08-30]
LM74610QDGKRQ1.step
4.90 x 1.10 x 3.00 mm
