patricecouillard-code/TrailerDiagnosticSystem/TrailerDiagnosticSystem.pdf

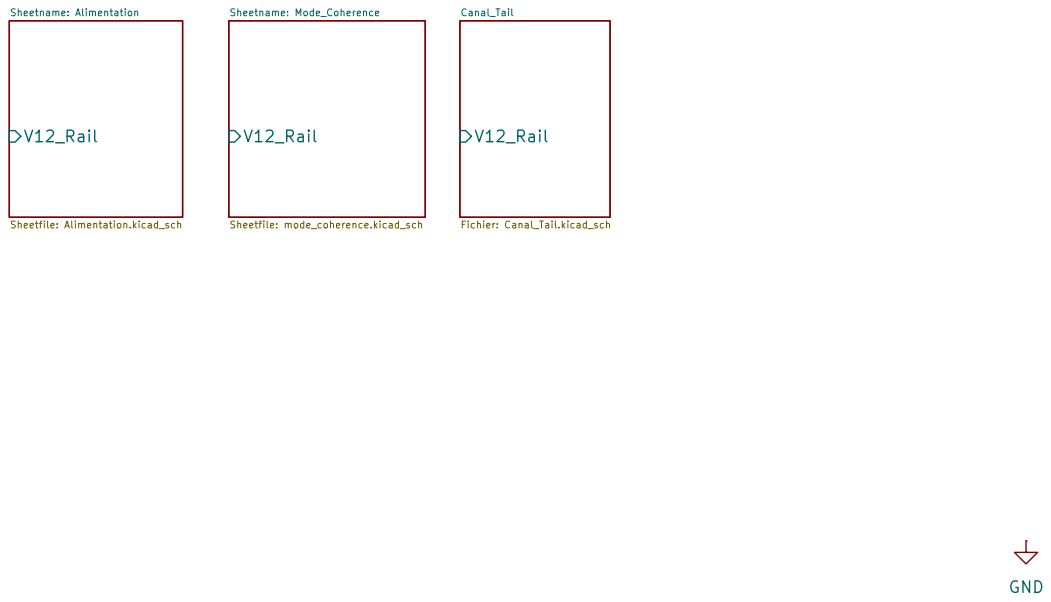
[picture p9: page 1]

Size: A4 | Rev:
KiCad E.D.A. 10.0.4 | Id: 1/7

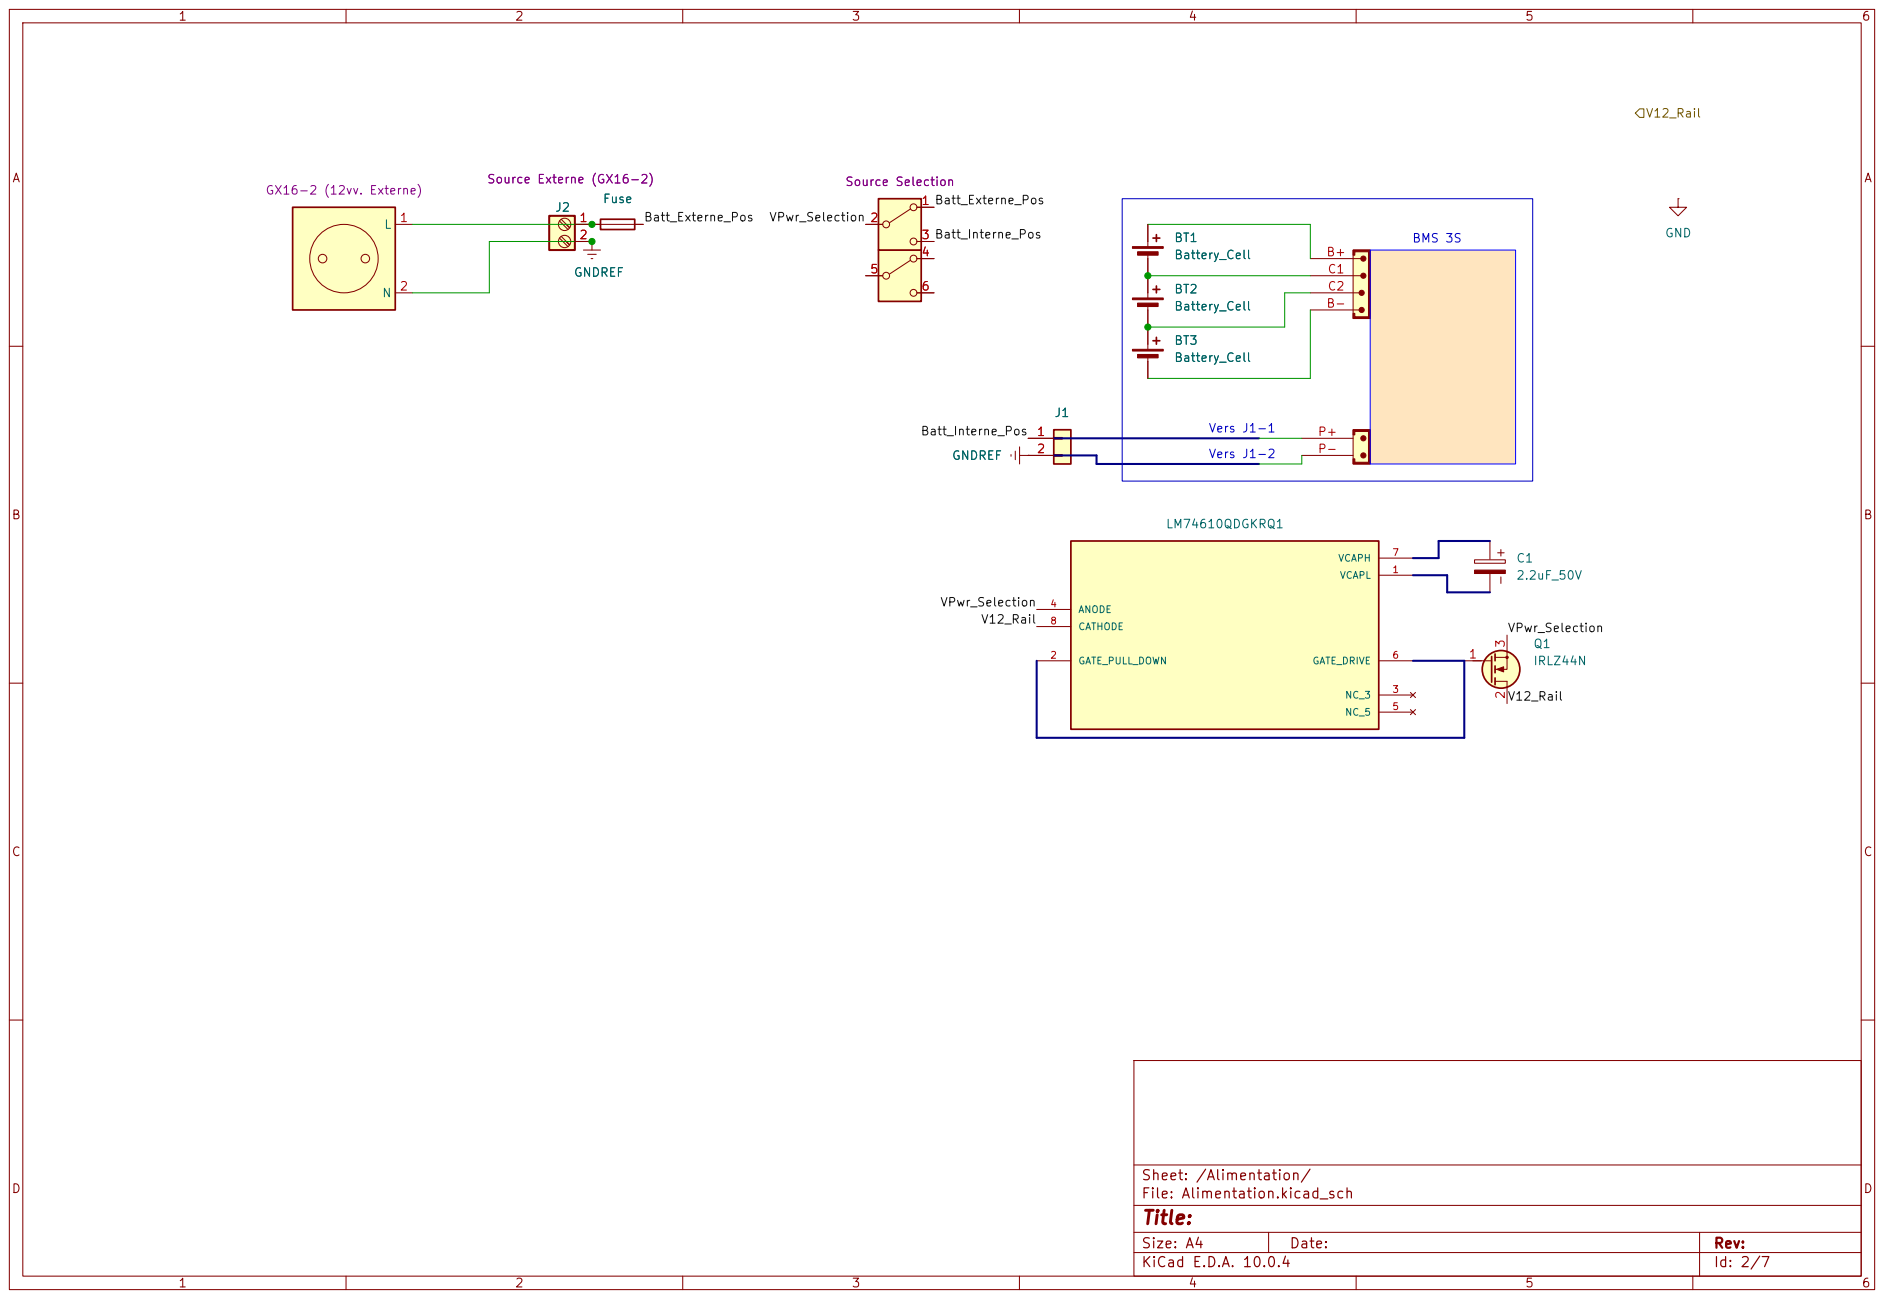
[picture p10: page 2]

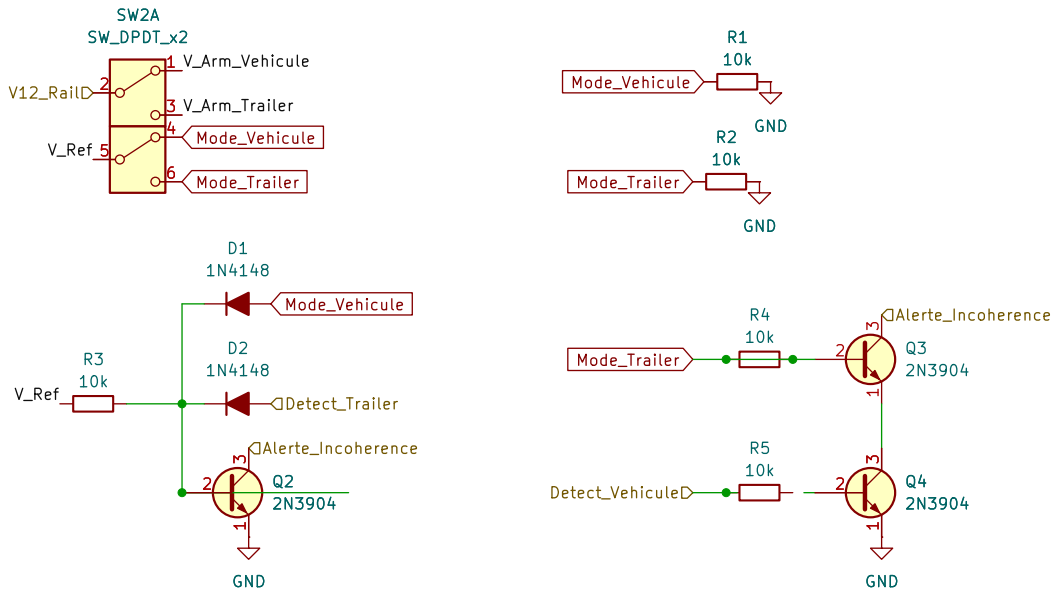
[picture p11: page 3]

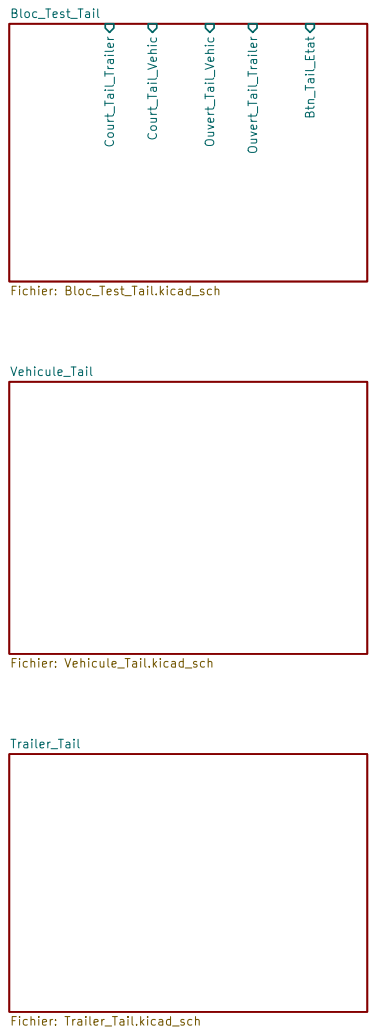
[picture p12: page 4]

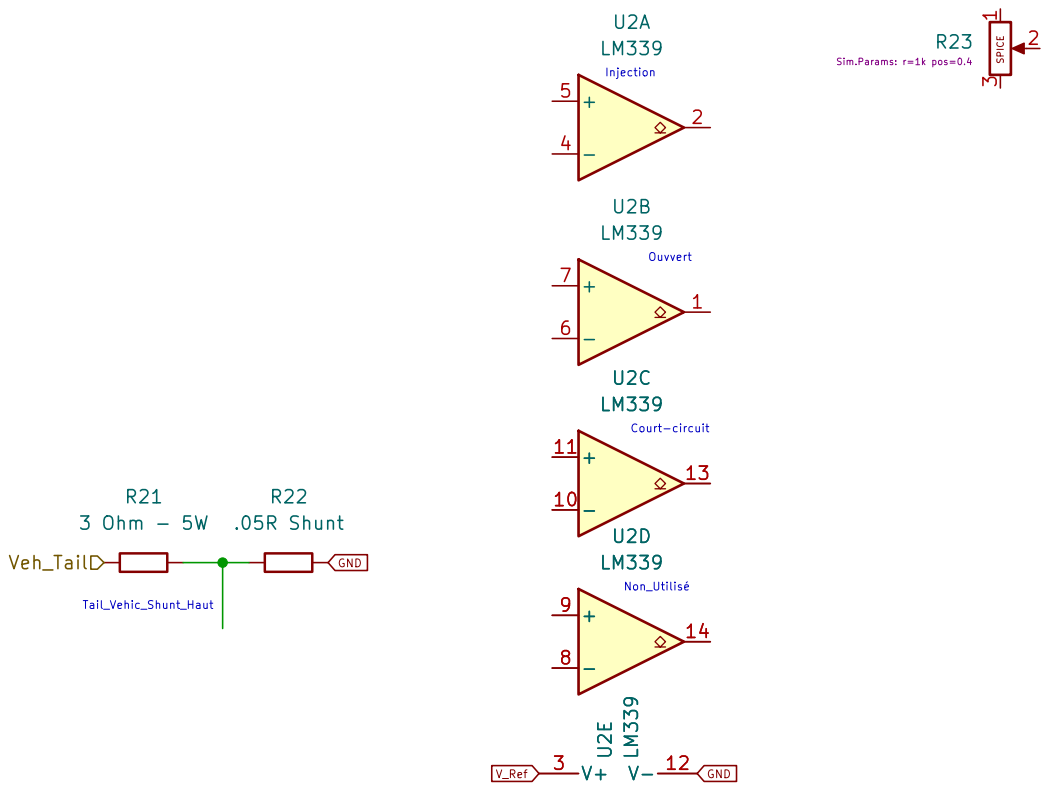
[picture p13: page 5]

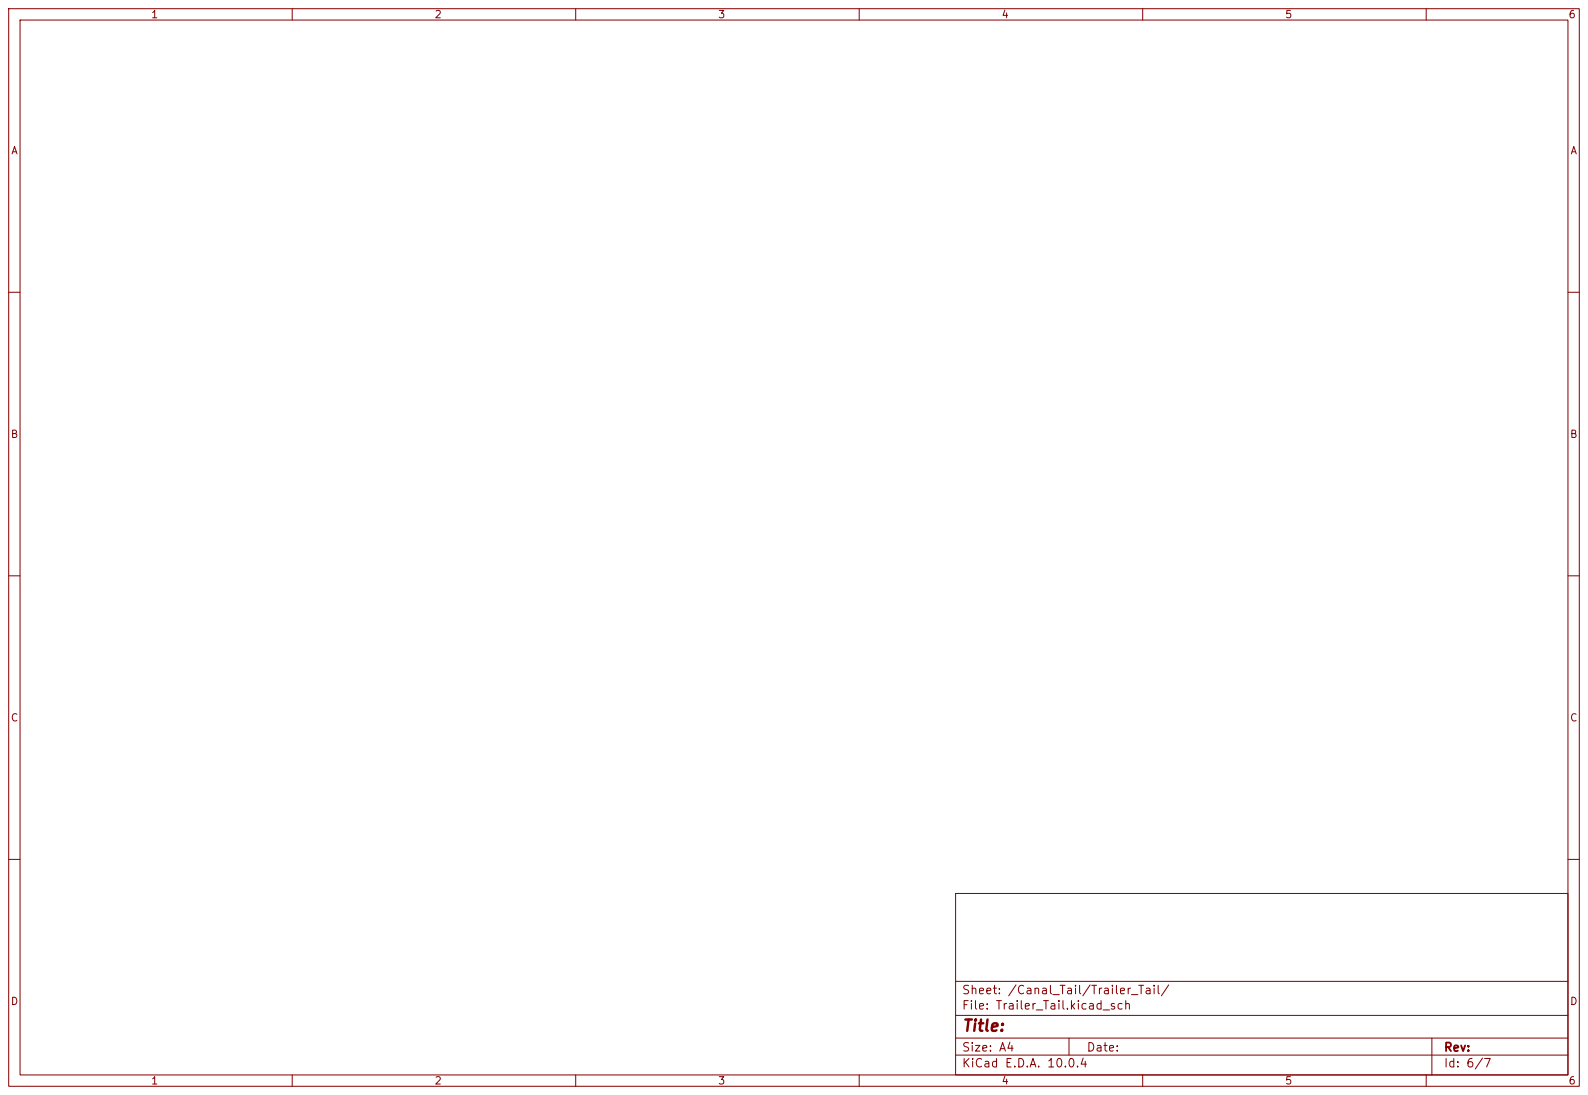
[picture p14: page 6]

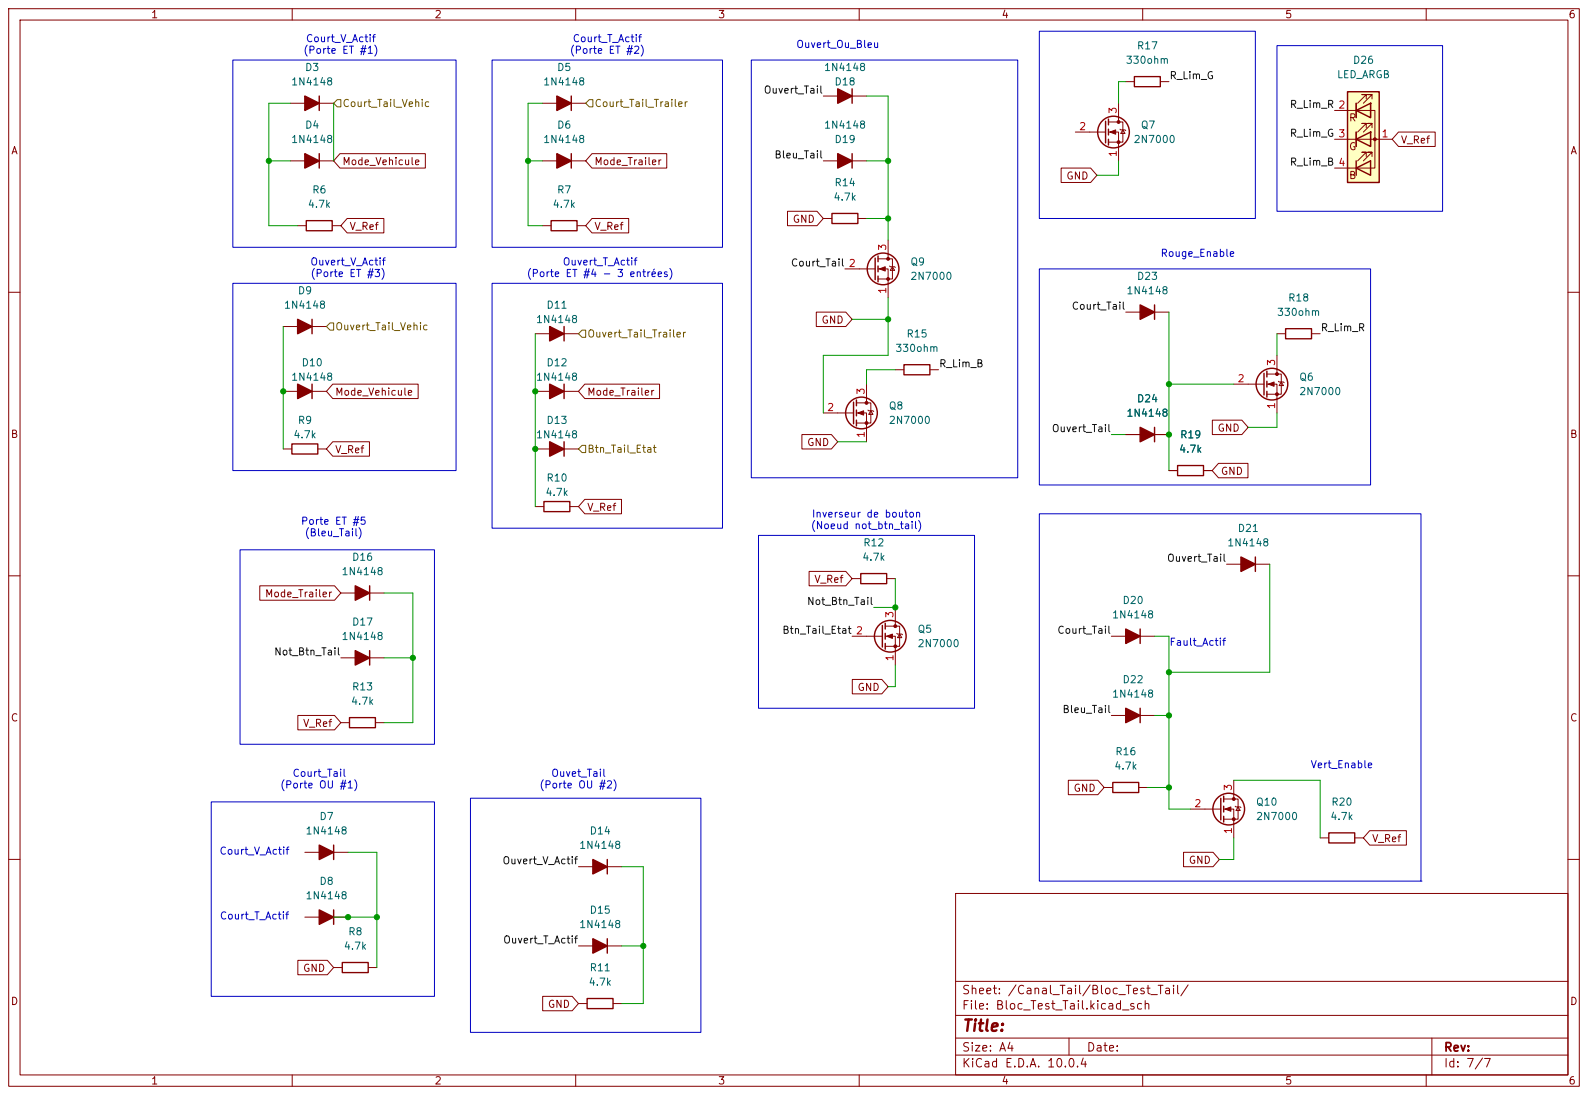
[picture p15: page 7]

Rouge_Enable Court_T_Actif (Porte ET #2) Porte ET #5
