patricecouillard-code/TrailerDiagnosticSystem/TrailerDiagnosticSystem.kicad_pcb

## KiCad design TrailerDiagnosticSystem.kicad_pcb (2026-11-14)

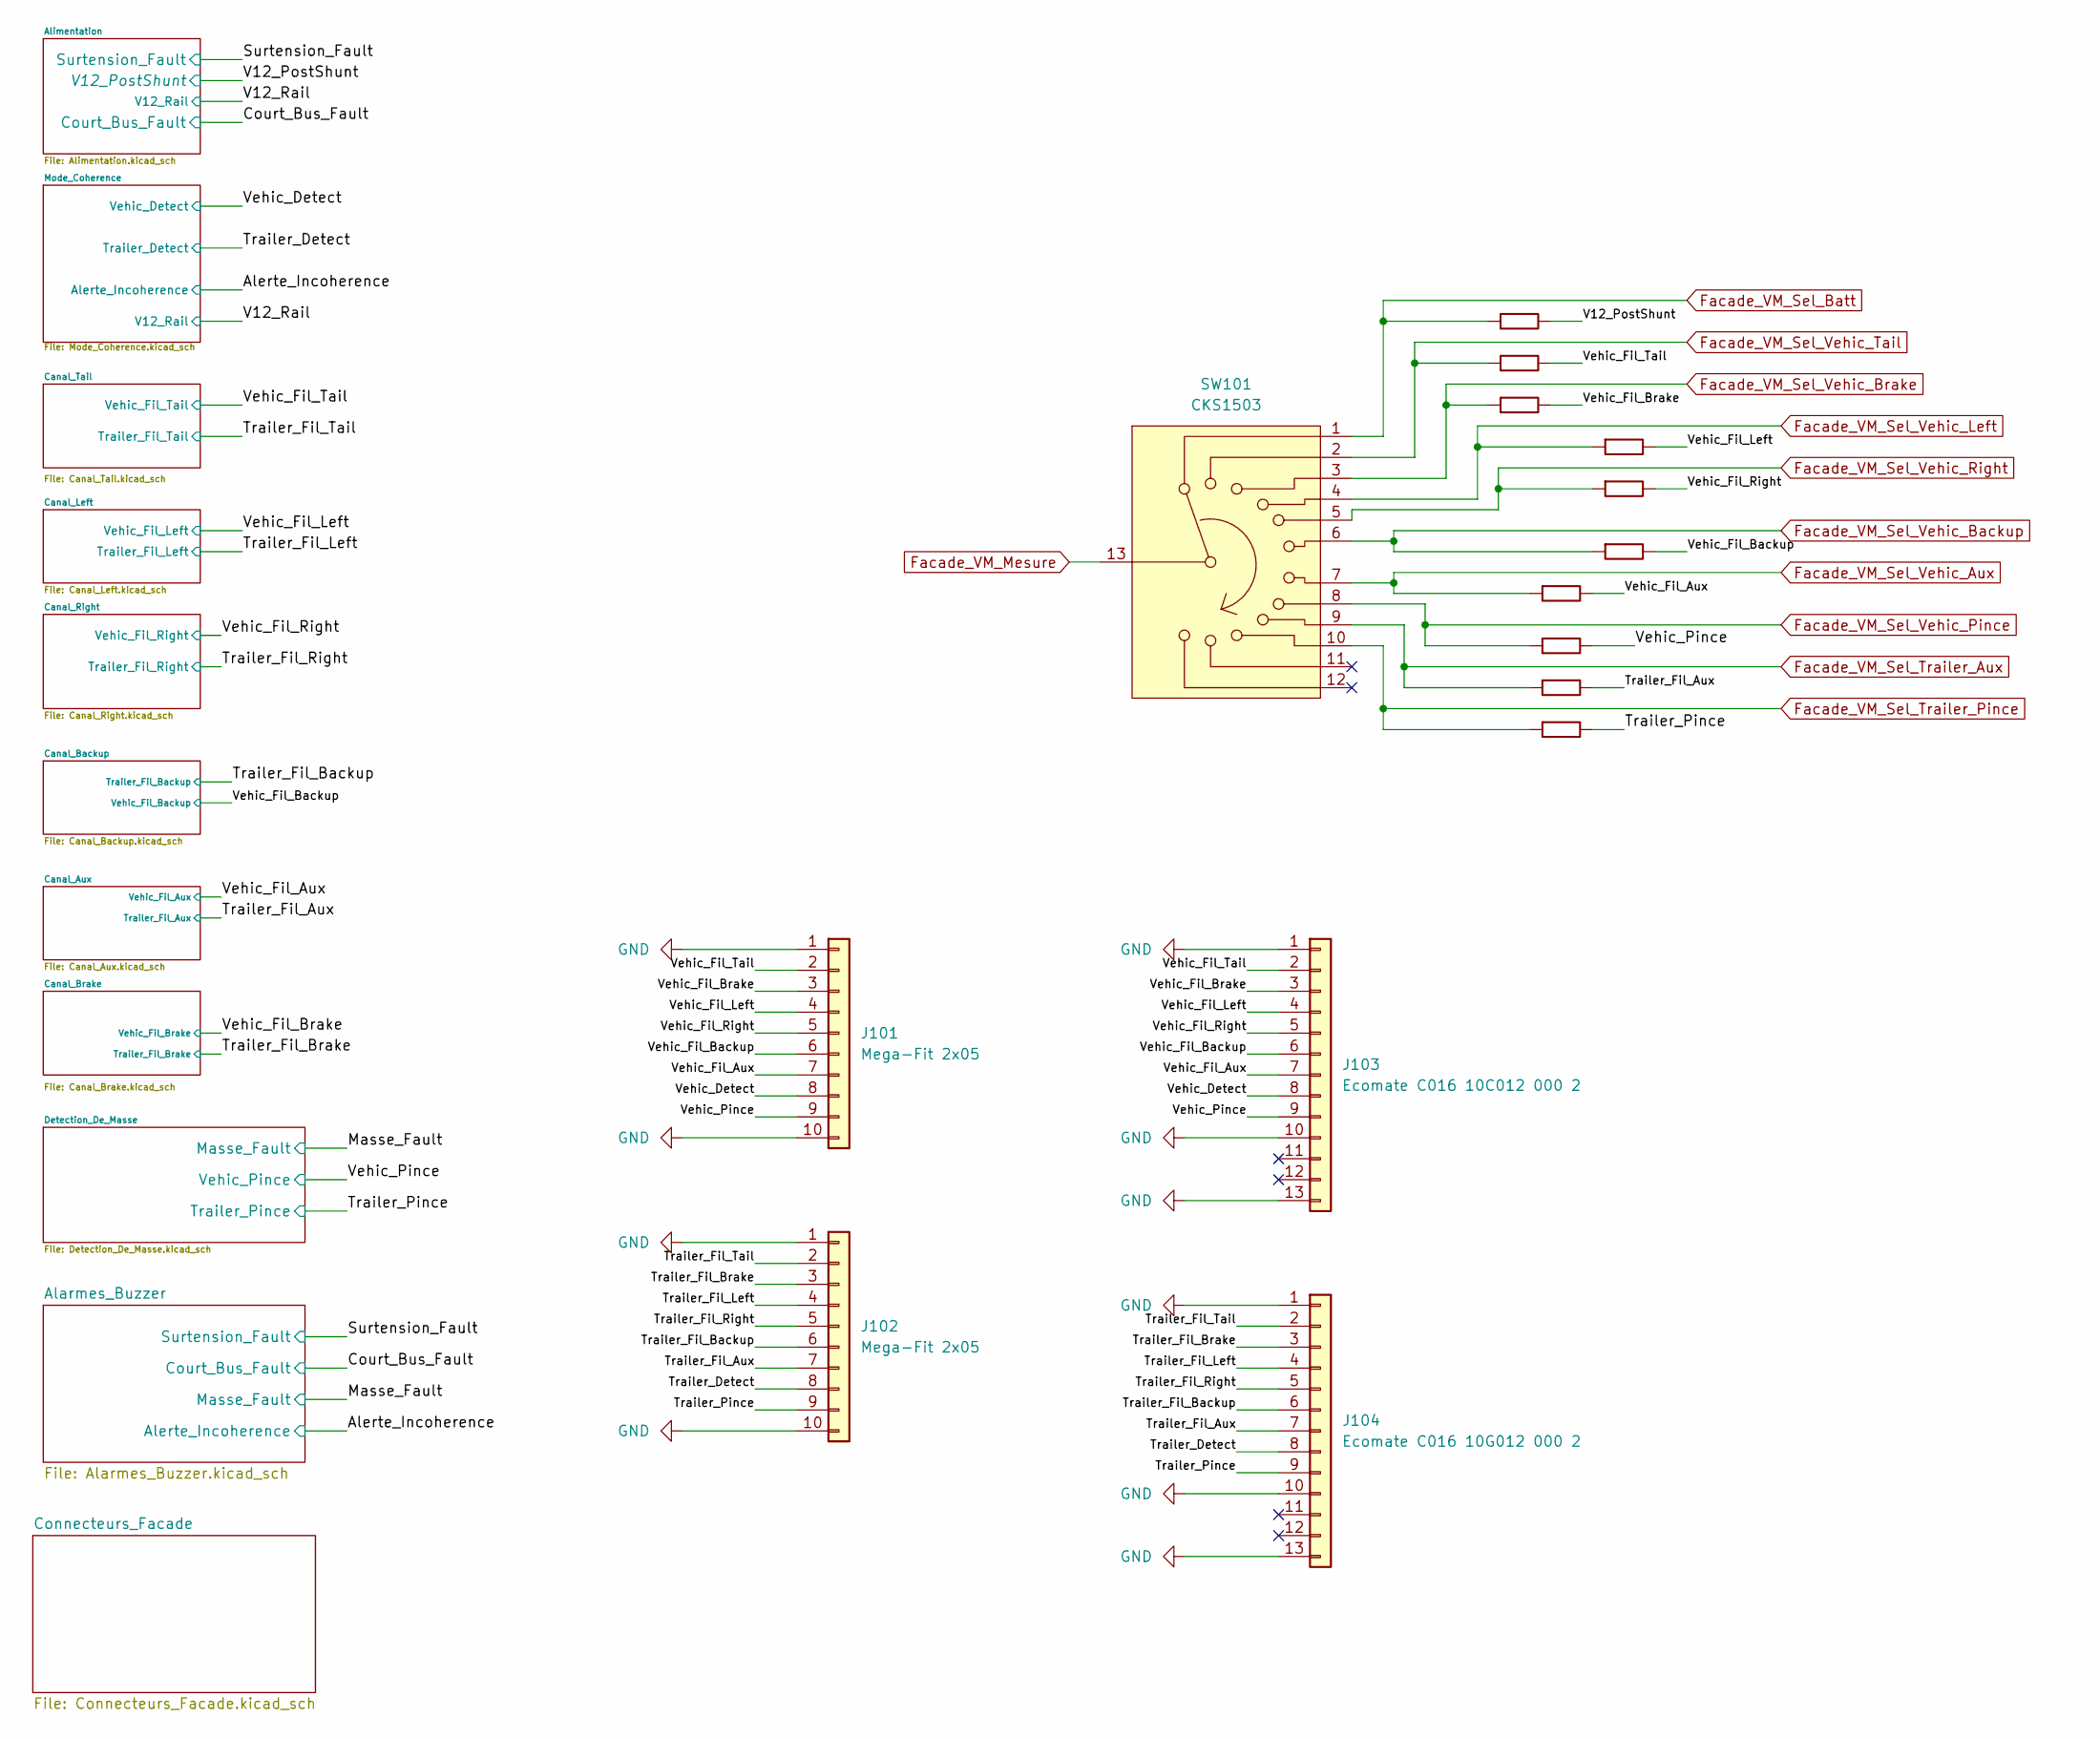
[picture p16: schematic TrailerDiagnosticSystem.kicad_sch]

Parts:
J101, J102: Mega-Fit 2x05; Molex_Mega-Fit_76829-0010_2x05_P5.70mm_Vertical
J103: Ecomate C016 10C012 000 2
J104: Ecomate C016 10G012 000 2
R101, R102, R103, R104, R105, R106, R107, R108, R109, R110: 1kΩ; R_Axial_DIN0309_L9.0mm_D3.2mm_P12.70mm_Horizontal
SW101: CKS1503

Connections:
/Trailer_Detect: J102.8, J104.8; also elsewhere on the board
/Trailer_Fil_Aux: J102.7, J104.7, R106.2; also elsewhere on the board
/Trailer_Fil_Backup: J102.6, J104.6; also elsewhere on the board
/Trailer_Fil_Brake: J102.3, J104.3; also elsewhere on the board
/Trailer_Fil_Left: J102.4, J104.4; also elsewhere on the board
/Trailer_Fil_Right: J102.5, J104.5; also elsewhere on the board
/Trailer_Fil_Tail: J102.2, J104.2; also elsewhere on the board
/Trailer_Pince: J102.9, J104.9, R107.2; also elsewhere on the board
/V12_PostShunt: R101.2; also elsewhere on the board
/Vehic_Detect: J101.8, J103.8; also elsewhere on the board
/Vehic_Fil_Aux: J101.7, J103.7, R104.2; also elsewhere on the board
/Vehic_Fil_Backup: J101.6, J103.6, R110.2; also elsewhere on the board
/Vehic_Fil_Brake: J101.3, J103.3, R103.2; also elsewhere on the board
/Vehic_Fil_Left: J101.4, J103.4, R108.2; also elsewhere on the board
/Vehic_Fil_Right: J101.5, J103.5, R109.2; also elsewhere on the board
/Vehic_Fil_Tail: J101.2, J103.2, R102.2; also elsewhere on the board
/Vehic_Pince: J101.9, J103.9, R105.2; also elsewhere on the board
Facade_VM_Sel_Batt: R101.1, SW101.1; also elsewhere on the board
Facade_VM_Sel_Trailer_Aux: R106.1, SW101.9; also elsewhere on the board
Facade_VM_Sel_Trailer_Pince: R107.1, SW101.10; also elsewhere on the board
Facade_VM_Sel_Vehic_Aux: R104.1, SW101.7; also elsewhere on the board
Facade_VM_Sel_Vehic_Backup: R110.1, SW101.6; also elsewhere on the board
Facade_VM_Sel_Vehic_Brake: R103.1, SW101.3; also elsewhere on the board
Facade_VM_Sel_Vehic_Left: R108.1, SW101.4; also elsewhere on the board
Facade_VM_Sel_Vehic_Pince: R105.1, SW101.8; also elsewhere on the board
Facade_VM_Sel_Vehic_Right: R109.1, SW101.5; also elsewhere on the board
Facade_VM_Sel_Vehic_Tail: R102.1, SW101.2; also elsewhere on the board
GND: J101.1, J101.10, J102.1, J102.10, J103.1, J103.10, J103.13, J104.1, J104.10, J104.13; also elsewhere on the board

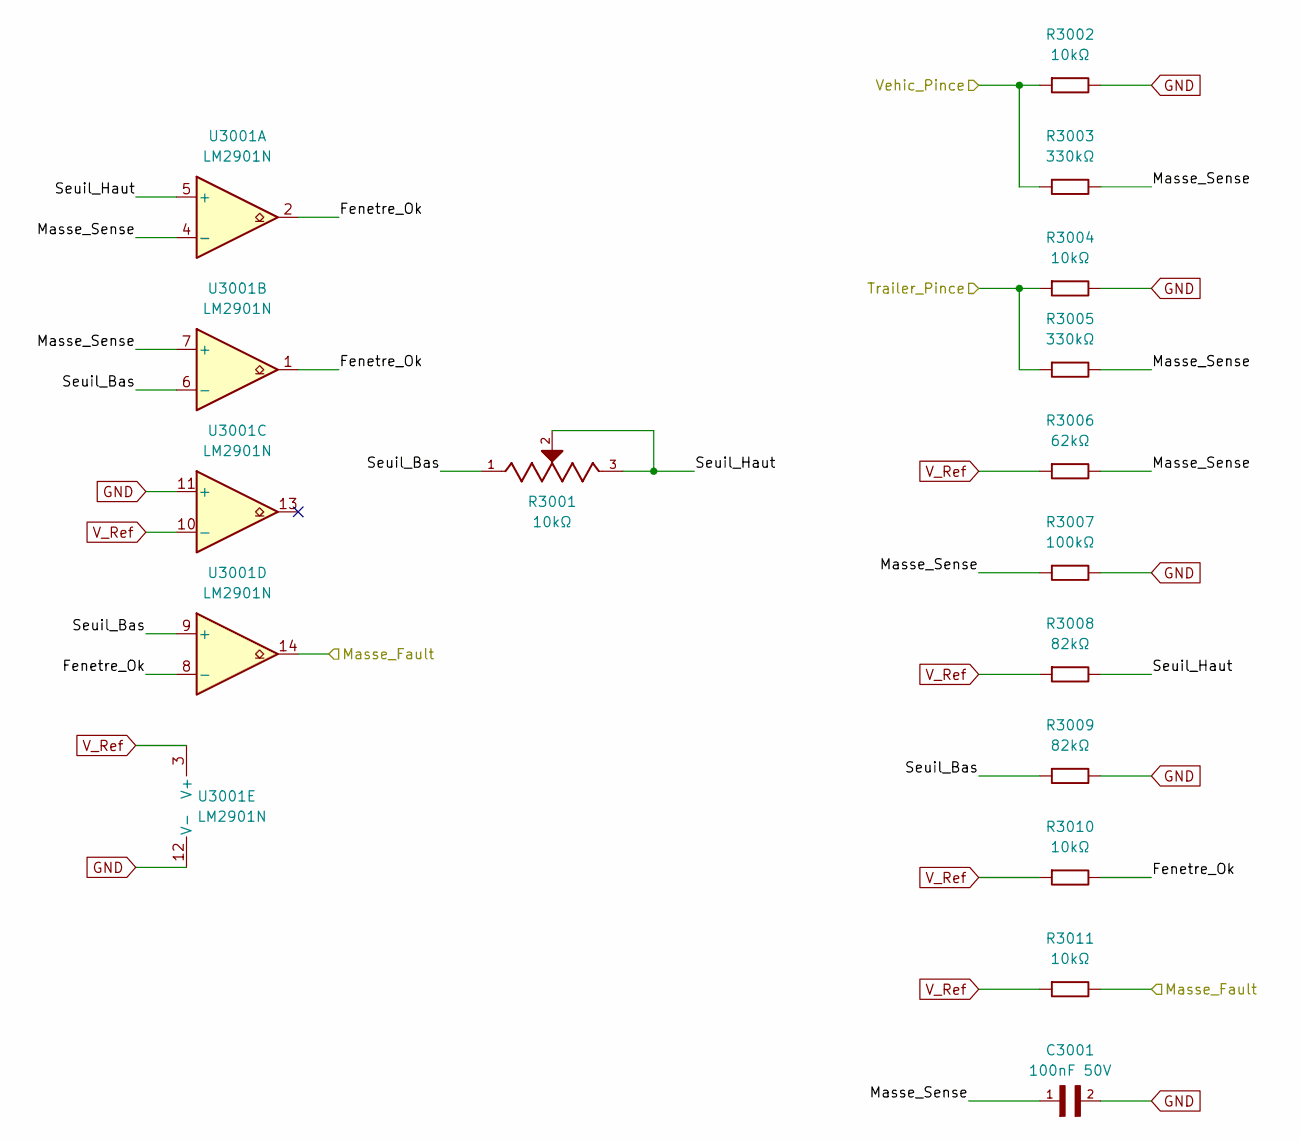
[picture p17: schematic Detection_De_Masse.kicad_sch]

Parts:
C3001: 100nF 50V; CAPRR254W50L508T317H508; MPN SR205C104KAR
R3001: 10kΩ; TRIM_3296W1103LF; MPN 3296W-1-103LF
R3002, R3004, R3010, R3011: 10kΩ; R_Axial_DIN0207_L6.3mm_D2.5mm_P10.16mm_Horizontal
R3003, R3005: 330kΩ; R_Axial_DIN0207_L6.3mm_D2.5mm_P10.16mm_Horizontal
R3006: 62kΩ; R_Axial_DIN0207_L6.3mm_D2.5mm_P10.16mm_Horizontal
R3007: 100kΩ; R_Axial_DIN0207_L6.3mm_D2.5mm_P10.16mm_Horizontal
R3008, R3009: 82kΩ; R_Axial_DIN0207_L6.3mm_D2.5mm_P10.16mm_Horizontal
U3001: LM2901N; DIP-14_W7.62mm_Socket

Connections:
/Detection_De_Masse/Fenetre_Ok: R3010.2, U3001.1, U3001.2, U3001.8 (-)
/Detection_De_Masse/Masse_Sense: C3001.1, R3003.2, R3005.2, R3006.2, R3007.1, U3001.4 (-), U3001.7 (+)
/Detection_De_Masse/Seuil_Bas: R3001.1, R3009.1, U3001.6 (-), U3001.9 (+)
/Detection_De_Masse/Seuil_Haut: R3001.2, R3001.3, R3008.2, U3001.5 (+)
/Masse_Fault: R3011.2, U3001.14; also elsewhere on the board
/Trailer_Pince: R3004.1, R3005.1; also elsewhere on the board
/Vehic_Pince: R3002.1, R3003.1; also elsewhere on the board
GND: C3001.2, R3002.2, R3004.2, R3007.2, R3009.2, U3001.11 (+), U3001.12 (V-); also elsewhere on the board
V_Ref: R3006.1, R3008.1, R3010.1, R3011.1, U3001.3 (V+), U3001.10 (-); also elsewhere on the board

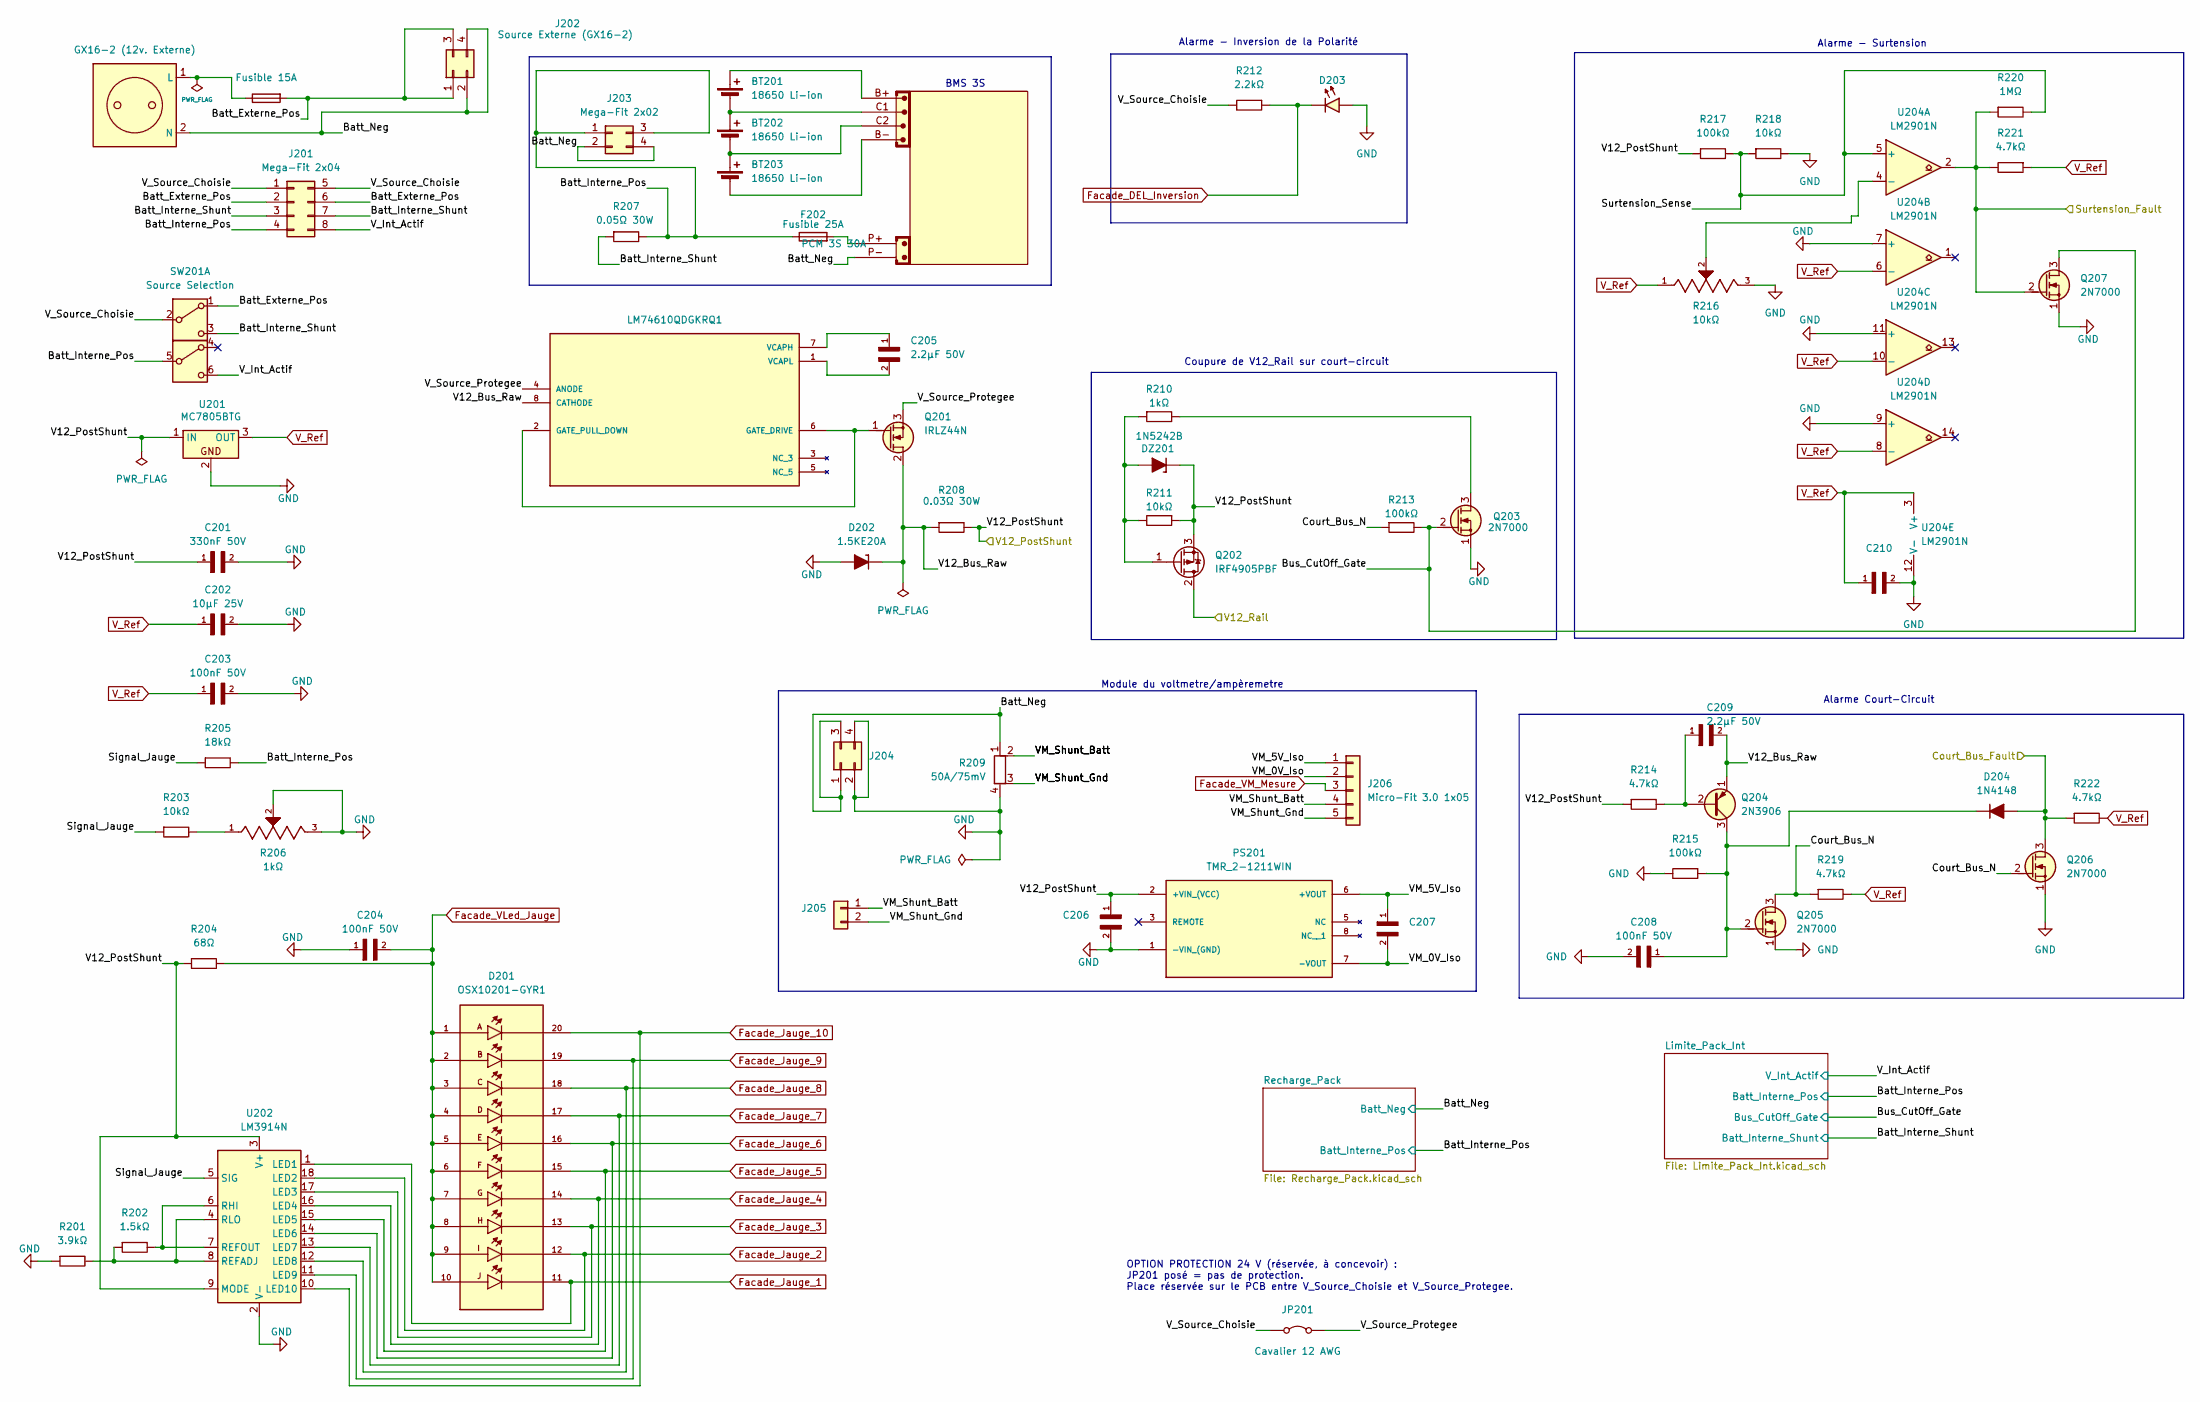
[picture p18: schematic Alimentation.kicad_sch]

Parts:
BMS201: PCM 3S 30A; MPN PCM-L04S30-566 (CU-J881, produit #7758)
BT201, BT202, BT203: 18650 Li-ion; MPN INR-18650-P28A
C201: 330nF 50V; CAPRR508W50L762T381H762; MPN SR305C334KAR
C202, C207: 10µF 25V; CAPRB500W50L550T350H600; MPN FG26X7R1E106KRT06
C203, C204, C208, C210: 100nF 50V; CAPRR254W50L508T317H508; MPN SR205C104KAR
C205, C209: 2.2µF 50V; CAPRB500W50L450T300H550; MPN FG24X7R1H225KRT06
C206: 10µF 50V; CAPRR508W50L762T381H762; MPN SR655C106KAR
D201: OSX10201-GYR1; DIP760W45P254L2550H815Q20B; PARTREV VER D.1.0
D202: 1.5KE20A; D_DO-201AE_P15.24mm_Horizontal
D203: RGB 5mm CA (rouge); LED_D5.0mm-4_RGB_Staggered_Pins; MPN WP154A4SEJ3VBDZGW/CA
D204: 1N4148; D_DO-35_SOD27_P7.62mm_Horizontal
DZ201: 1N5242B; D_DO-35_SOD27_P7.62mm_Horizontal_Zener
F201: Fusible 15A; MPN 0287015.PXCN
F202: Fusible 25A; MPN 0287025.PXCN
J201: Mega-Fit 2x04; Molex_Mega-Fit_76829-0008_2x04_P5.70mm_Vertical; MPN 0768290008
J202, J203, J204: Mega-Fit 2x02; Molex_Mega-Fit_76829-0004_2x02_P5.70mm_Vertical; MPN 0768290004
J205: Micro-Fit 3.0 1x02; Molex_Micro-Fit_3.0_43650-0215_1x02_P3.00mm_Vertical
J206: Micro-Fit 3.0 1x05; Molex_Micro-Fit_3.0_43650-0515_1x05_P3.00mm_Vertical
JP201: Cavalier 12 AWG; SolderWire-2.5sqmm_1x02_P8.8mm_D2.4mm_OD4.4mm
P201: Batt. ext. 2P
PS201: TMR_2-1211WIN; CONV_TMR_2-1211WIN; PARTREV January 27, 2021
Q201: IRLZ44N; TO-220-3_Vertical_GDS
Q202: IRF4905PBF; TO-220-3_Vertical; MPN IRF4905PBF
Q203, Q205, Q206, Q207: 2N7000; TO-92_Inline_Wide_SGD
Q204: 2N3906; TO-92_Inline_Wide_EBC
R201: 3.9kΩ; R_Axial_DIN0207_L6.3mm_D2.5mm_P10.16mm_Horizontal
R202: 1.5kΩ; R_Axial_DIN0207_L6.3mm_D2.5mm_P10.16mm_Horizontal
R203, R211, R218: 10kΩ; R_Axial_DIN0207_L6.3mm_D2.5mm_P10.16mm_Horizontal
R204: 68Ω; R_Axial_Power_L25.0mm_W9.0mm_P27.94mm
R205: 18kΩ; R_Axial_DIN0207_L6.3mm_D2.5mm_P10.16mm_Horizontal
R206: 1kΩ; TRIM_3296W-1-102LF; MPN 3296W-1-102LF
R207: 0.05Ω 30W; TO-220-2_Vertical; MPN MP930-0.050-1%
R208: 0.03Ω 30W; TO-220-2_Vertical; MPN MP930-0.030-5%
R209: 50A/75mV
R210: 1kΩ; R_Axial_DIN0207_L6.3mm_D2.5mm_P10.16mm_Horizontal
R212: 2.2kΩ; R_Axial_DIN0207_L6.3mm_D2.5mm_P10.16mm_Horizontal
R213, R215, R217: 100kΩ; R_Axial_DIN0207_L6.3mm_D2.5mm_P10.16mm_Horizontal
R214, R219, R221, R222: 4.7kΩ; R_Axial_DIN0207_L6.3mm_D2.5mm_P10.16mm_Horizontal
R216: 10kΩ; TRIM_3296W1103LF; MPN 3296W-1-103LF
R220: 1MΩ; R_Axial_DIN0207_L6.3mm_D2.5mm_P10.16mm_Horizontal
SW201: Cole Hersee 5592
U201: MC7805BTG; TO-220-3_Vertical
U202: LM3914N; DIP-18_W7.62mm_Socket
U203: LM74610QDGKRQ1; SOP65P490X110-8N; PARTREV B
U204: LM2901N; DIP-14_W7.62mm_Socket

Connections:
/Alimentation/Batt_Externe_Pos: F201.2, J201.2, J201.6, J202.1, J202.3, SW201.1 (A)
/Alimentation/Batt_Interne_Pos: F202.1, J201.4, J203.1, J203.3, R205.2, R207.2, SW201.5 (B); also elsewhere on the board
/Alimentation/Batt_Interne_Shunt: J201.3, J201.7, R207.1, SW201.3 (C); also elsewhere on the board
/Alimentation/Batt_Neg: BMS201.P-, J202.2, J202.4, J203.2, J203.4, J204.1, J204.3, P201.2 (N), R209.1; also elsewhere on the board
/Alimentation/Bus_CutOff_Gate: Q203.2 (G), Q207.3 (D), R213.2; also elsewhere on the board
/Alimentation/Court_Bus_N: Q205.3 (D), Q206.2 (G), R213.1, R219.1
/Alimentation/Signal_Jauge: R203.1, R205.1, U202.5 (SIG)
/Alimentation/Surtension_Sense: R217.2, R218.1, R220.2, U204.5 (+)
/Alimentation/V12_Bus_Raw: C209.2, D202.1 (K), Q201.2 (D), Q204.1 (E), R208.1, U203.8 (CATHODE)
/Alimentation/VM_0V_Iso: C207.2, J206.2, PS201.7 (-VOUT)
/Alimentation/VM_5V_Iso: C207.1, J206.1, PS201.6 (+VOUT)
/Alimentation/VM_Shunt_Batt: J205.1, J206.4, R209.2
/Alimentation/VM_Shunt_Gnd: J205.2, J206.5, R209.3
/Alimentation/V_Int_Actif: J201.8, SW201.6 (C); also elsewhere on the board
/Alimentation/V_Source_Choisie: J201.1, J201.5, JP201.1 (A), R212.2, SW201.2 (B)
/Alimentation/V_Source_Protegee: JP201.2 (B), Q201.3 (S), U203.4 (ANODE)
/Court_Bus_Fault: D204.2 (A), Q206.3 (D), R222.1; also elsewhere on the board
/Surtension_Fault: Q207.2 (G), R220.1, R221.2, U204.2; also elsewhere on the board
/V12_PostShunt: C201.1, C206.1, DZ201.1 (K), PS201.2 (+VIN_(VCC)), Q202.3 (S), R204.1, R208.2, R211.1, R214.1, R217.1, U201.1 (IN), U202.3 (V+), U202.9 (MODE); also elsewhere on the board
/V12_Rail: Q202.2 (D); also elsewhere on the board
Facade_DEL_Inversion: D203.1 (K), R212.1; also elsewhere on the board
Facade_Jauge_1: D201.11, U202.1 (LED1); also elsewhere on the board
Facade_Jauge_2: D201.12, U202.18 (LED2); also elsewhere on the board
Facade_Jauge_3: D201.13, U202.17 (LED3); also elsewhere on the board
Facade_Jauge_4: D201.14, U202.16 (LED4); also elsewhere on the board
Facade_Jauge_5: D201.15, U202.15 (LED5); also elsewhere on the board
Facade_Jauge_6: D201.16, U202.14 (LED6); also elsewhere on the board
Facade_Jauge_7: D201.17, U202.13 (LED7); also elsewhere on the board
Facade_Jauge_8: D201.18, U202.12 (LED8); also elsewhere on the board
Facade_Jauge_9: D201.19, U202.11 (LED9); also elsewhere on the board
Facade_Jauge_10: D201.20, U202.10 (LED10); also elsewhere on the board
Facade_VLed_Jauge: C204.2, D201.1, D201.2, D201.3, D201.4, D201.5, D201.6, D201.7, D201.8, D201.9, D201.10, R204.2; also elsewhere on the board
Facade_VM_Mesure: J206.3; also elsewhere on the board
GND: C201.2, C202.2, C203.2, C204.1, C206.2, C208.2, C210.2, D202.2 (A), D203.2 (A), J204.2, J204.4, PS201.1 (-VIN_(GND)), Q203.1 (S), Q205.1 (S), Q206.1 (S), Q207.1 (S), R201.1, R206.2, R206.3, R209.4, R215.2, R216.3, R218.2, U201.2, U202.2 (V-), U204.7 (+), U204.9 (+), U204.11 (+), U204.12 (V-); also elsewhere on the board
unnamed: BMS201.B+, BT201.1 (+)
unnamed: BMS201.B-, BT203.2 (-)
unnamed: BMS201.C1, BT201.2 (-), BT202.1 (+)
unnamed: BMS201.C2, BT202.2 (-), BT203.1 (+)
unnamed: BMS201.P+, F202.2
unnamed: C208.1, D204.1 (K), Q204.3 (C), Q205.2 (G), R215.1
unnamed: DZ201.2 (A), Q202.1 (G), R210.1, R211.2
unnamed: F201.1, P201.1 (L)
unnamed: Q201.1 (G), U203.2 (GATE_PULL_DOWN), U203.6 (GATE_DRIVE)
unnamed: Q203.3 (D), R210.2
unnamed: C209.1, Q204.2 (B), R214.2
unnamed: R203.2, R206.1
unnamed: R201.2, R202.1, U202.4 (RLO), U202.8 (REFADJ)
unnamed: R202.2, U202.6 (RHI), U202.7 (REFOUT)
unnamed: C205.1, U203.7 (VCAPH)
unnamed: C205.2, U203.1 (VCAPL)
unnamed: R216.2, U204.4 (-)
V_Ref: C202.1, C203.1, C210.1, R216.1, R219.2, R221.1, R222.2, U201.3 (OUT), U204.3 (V+), U204.6 (-), U204.8 (-), U204.10 (-); also elsewhere on the board

Notes on the sheet:
Module du voltmetre/ampèremetre
Alarme - Inversion de la Polarité
OPTION PROTECTION 24 V (réservée, à concevoir) : JP201 posé = pas de protection. Place réservée sur le PCB entre V_Source_Choisie et V_Source_Protegee.
Alarme - Surtension
Alarme Court-Circuit
BMS 3S
Coupure de V12_Rail sur court-circuit

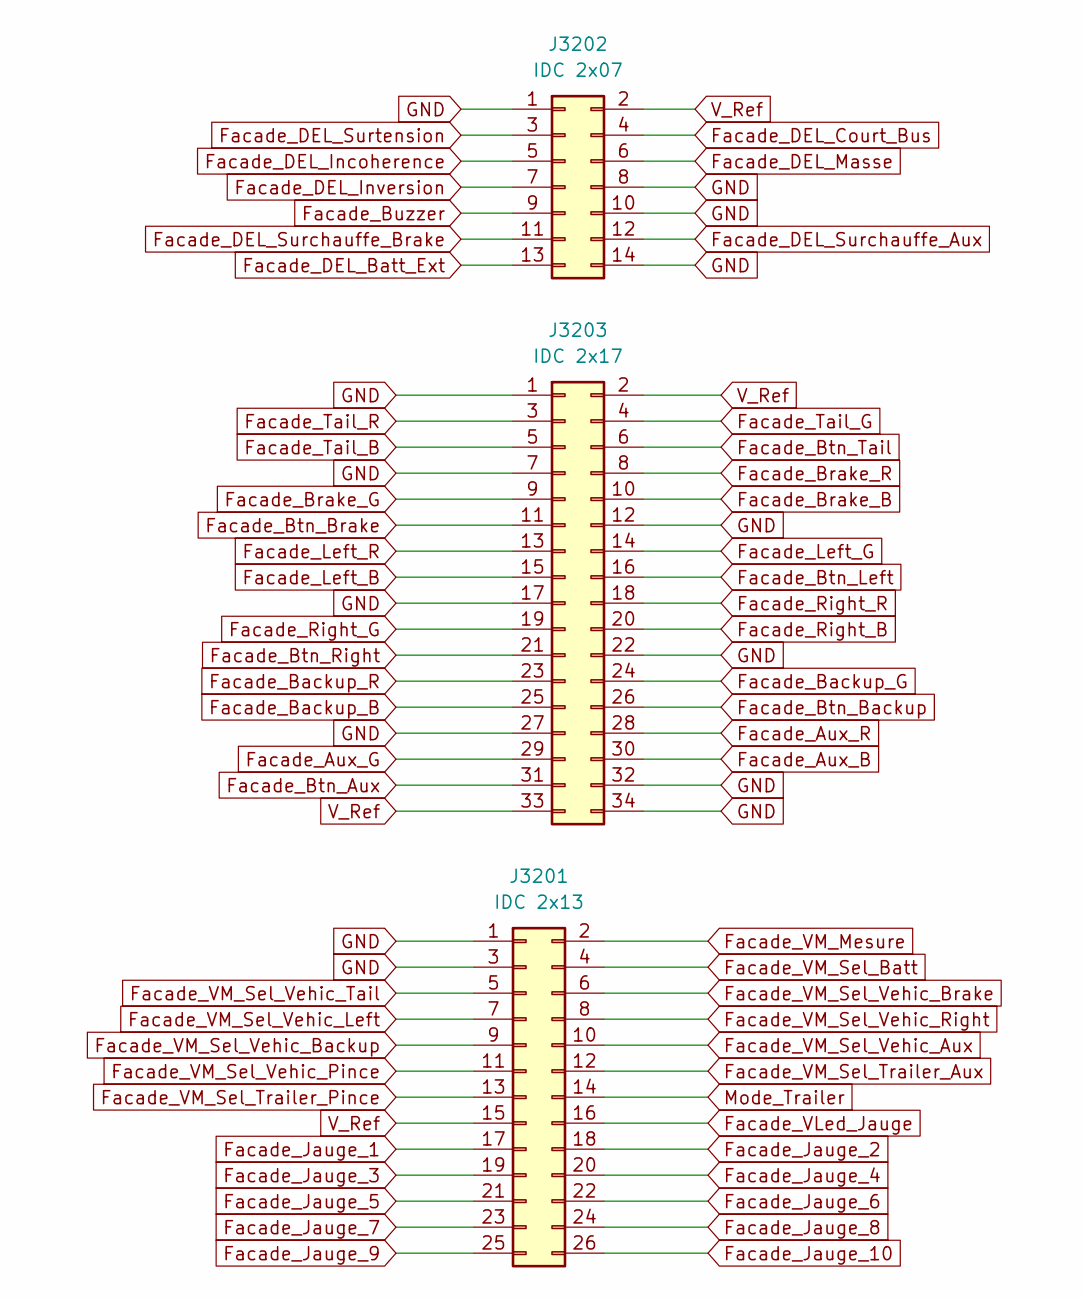
[picture p19: schematic Connecteurs_Facade.kicad_sch]

Parts:
J3201: IDC 2x13; IDC-Header_2x13_P2.54mm_Latch_Vertical; MPN N3429-6302RB
J3202: IDC 2x07; IDC-Header_2x07_P2.54mm_Latch_Vertical; MPN N3314-6302RB
J3203: IDC 2x17; IDC-Header_2x17_P2.54mm_Latch_Vertical; MPN N3431-6302RB

Connections:
Facade_Aux_B: J3203.30; also elsewhere on the board
Facade_Aux_G: J3203.29; also elsewhere on the board
Facade_Aux_R: J3203.28; also elsewhere on the board
Facade_Backup_B: J3203.25; also elsewhere on the board
Facade_Backup_G: J3203.24; also elsewhere on the board
Facade_Backup_R: J3203.23; also elsewhere on the board
Facade_Brake_B: J3203.10; also elsewhere on the board
Facade_Brake_G: J3203.9; also elsewhere on the board
Facade_Brake_R: J3203.8; also elsewhere on the board
Facade_Btn_Aux: J3203.31; also elsewhere on the board
Facade_Btn_Backup: J3203.26; also elsewhere on the board
Facade_Btn_Brake: J3203.11; also elsewhere on the board
Facade_Btn_Left: J3203.16; also elsewhere on the board
Facade_Btn_Right: J3203.21; also elsewhere on the board
Facade_Btn_Tail: J3203.6; also elsewhere on the board
Facade_Buzzer: J3202.9; also elsewhere on the board
Facade_DEL_Batt_Ext: J3202.13; also elsewhere on the board
Facade_DEL_Court_Bus: J3202.4; also elsewhere on the board
Facade_DEL_Incoherence: J3202.5; also elsewhere on the board
Facade_DEL_Inversion: J3202.7; also elsewhere on the board
Facade_DEL_Masse: J3202.6; also elsewhere on the board
Facade_DEL_Surchauffe_Aux: J3202.12; also elsewhere on the board
Facade_DEL_Surchauffe_Brake: J3202.11; also elsewhere on the board
Facade_DEL_Surtension: J3202.3; also elsewhere on the board
Facade_Jauge_1: J3201.17; also elsewhere on the board
Facade_Jauge_2: J3201.18; also elsewhere on the board
Facade_Jauge_3: J3201.19; also elsewhere on the board
Facade_Jauge_4: J3201.20; also elsewhere on the board
Facade_Jauge_5: J3201.21; also elsewhere on the board
Facade_Jauge_6: J3201.22; also elsewhere on the board
Facade_Jauge_7: J3201.23; also elsewhere on the board
Facade_Jauge_8: J3201.24; also elsewhere on the board
Facade_Jauge_9: J3201.25; also elsewhere on the board
Facade_Jauge_10: J3201.26; also elsewhere on the board
Facade_Left_B: J3203.15; also elsewhere on the board
Facade_Left_G: J3203.14; also elsewhere on the board
Facade_Left_R: J3203.13; also elsewhere on the board
Facade_Right_B: J3203.20; also elsewhere on the board
Facade_Right_G: J3203.19; also elsewhere on the board
Facade_Right_R: J3203.18; also elsewhere on the board
Facade_Tail_B: J3203.5; also elsewhere on the board
Facade_Tail_G: J3203.4; also elsewhere on the board
Facade_Tail_R: J3203.3; also elsewhere on the board
Facade_VLed_Jauge: J3201.16; also elsewhere on the board
Facade_VM_Mesure: J3201.2; also elsewhere on the board
Facade_VM_Sel_Batt: J3201.4; also elsewhere on the board
Facade_VM_Sel_Trailer_Aux: J3201.12; also elsewhere on the board
Facade_VM_Sel_Trailer_Pince: J3201.13; also elsewhere on the board
Facade_VM_Sel_Vehic_Aux: J3201.10; also elsewhere on the board
Facade_VM_Sel_Vehic_Backup: J3201.9; also elsewhere on the board
Facade_VM_Sel_Vehic_Brake: J3201.6; also elsewhere on the board
Facade_VM_Sel_Vehic_Left: J3201.7; also elsewhere on the board
Facade_VM_Sel_Vehic_Pince: J3201.11; also elsewhere on the board
Facade_VM_Sel_Vehic_Right: J3201.8; also elsewhere on the board
Facade_VM_Sel_Vehic_Tail: J3201.5; also elsewhere on the board
GND: J3201.1, J3201.3, J3202.1, J3202.8, J3202.10, J3202.14, J3203.1, J3203.7, J3203.12, J3203.17, J3203.22, J3203.27, J3203.32, J3203.34; also elsewhere on the board
Mode_Trailer: J3201.14; also elsewhere on the board
V_Ref: J3201.15, J3202.2, J3203.2, J3203.33; also elsewhere on the board

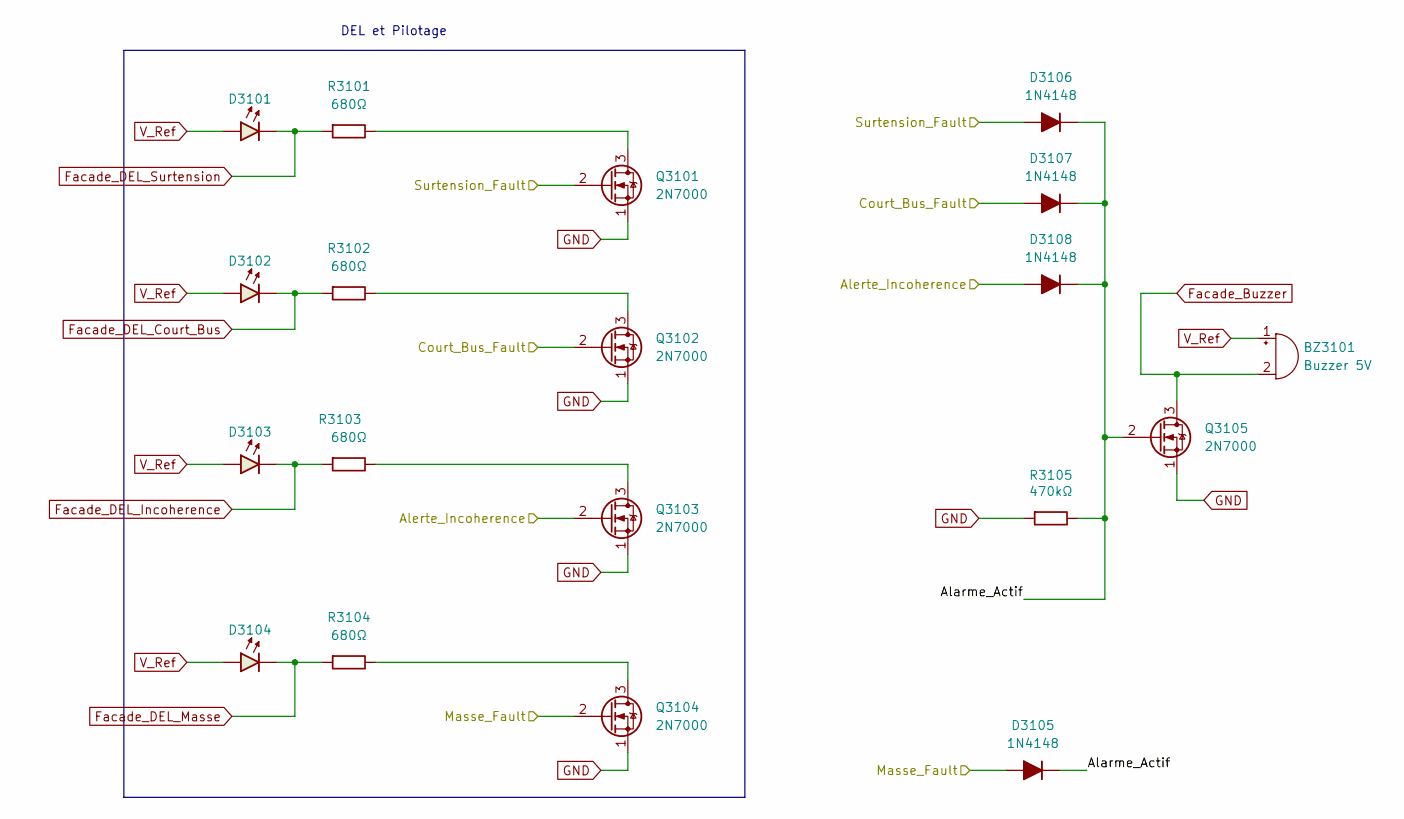
[picture p20: schematic Alarmes_Buzzer.kicad_sch]

Parts:
BZ3101: Buzzer 5V; MPN CMI-1295IC-0585T
D3101, D3102, D3103, D3104: RGB 5mm CA (rouge); LED_D5.0mm-4_RGB_Staggered_Pins; MPN WP154A4SEJ3VBDZGW/CA
D3105, D3106, D3107, D3108: 1N4148; D_DO-35_SOD27_P7.62mm_Horizontal
Q3101, Q3102, Q3103, Q3104, Q3105: 2N7000; TO-92_Inline_Wide_SGD
R3101, R3102, R3103, R3104: 680Ω; R_Axial_DIN0207_L6.3mm_D2.5mm_P10.16mm_Horizontal
R3105: 470kΩ; R_Axial_DIN0207_L6.3mm_D2.5mm_P10.16mm_Horizontal

Connections:
/Alarmes_Buzzer/Alarme_Actif: D3105.1 (K), D3106.1 (K), D3107.1 (K), D3108.1 (K), Q3105.2 (G), R3105.2
/Alerte_Incoherence: D3108.2 (A), Q3103.2 (G); also elsewhere on the board
/Court_Bus_Fault: D3107.2 (A), Q3102.2 (G); also elsewhere on the board
/Masse_Fault: D3105.2 (A), Q3104.2 (G); also elsewhere on the board
/Surtension_Fault: D3106.2 (A), Q3101.2 (G); also elsewhere on the board
Facade_Buzzer: BZ3101.2 (-), Q3105.3 (D); also elsewhere on the board
Facade_DEL_Court_Bus: D3102.1 (K), R3102.1; also elsewhere on the board
Facade_DEL_Incoherence: D3103.1 (K), R3103.1; also elsewhere on the board
Facade_DEL_Masse: D3104.1 (K), R3104.1; also elsewhere on the board
Facade_DEL_Surtension: D3101.1 (K), R3101.1; also elsewhere on the board
GND: Q3101.1 (S), Q3102.1 (S), Q3103.1 (S), Q3104.1 (S), Q3105.1 (S), R3105.1; also elsewhere on the board
unnamed: BZ3101.1 (+), D3101.2 (A), D3102.2 (A), D3103.2 (A), D3104.2 (A)
unnamed: Q3101.3 (D), R3101.2
unnamed: Q3102.3 (D), R3102.2
unnamed: Q3103.3 (D), R3103.2
unnamed: Q3104.3 (D), R3104.2

Notes on the sheet:
DEL et Pilotage

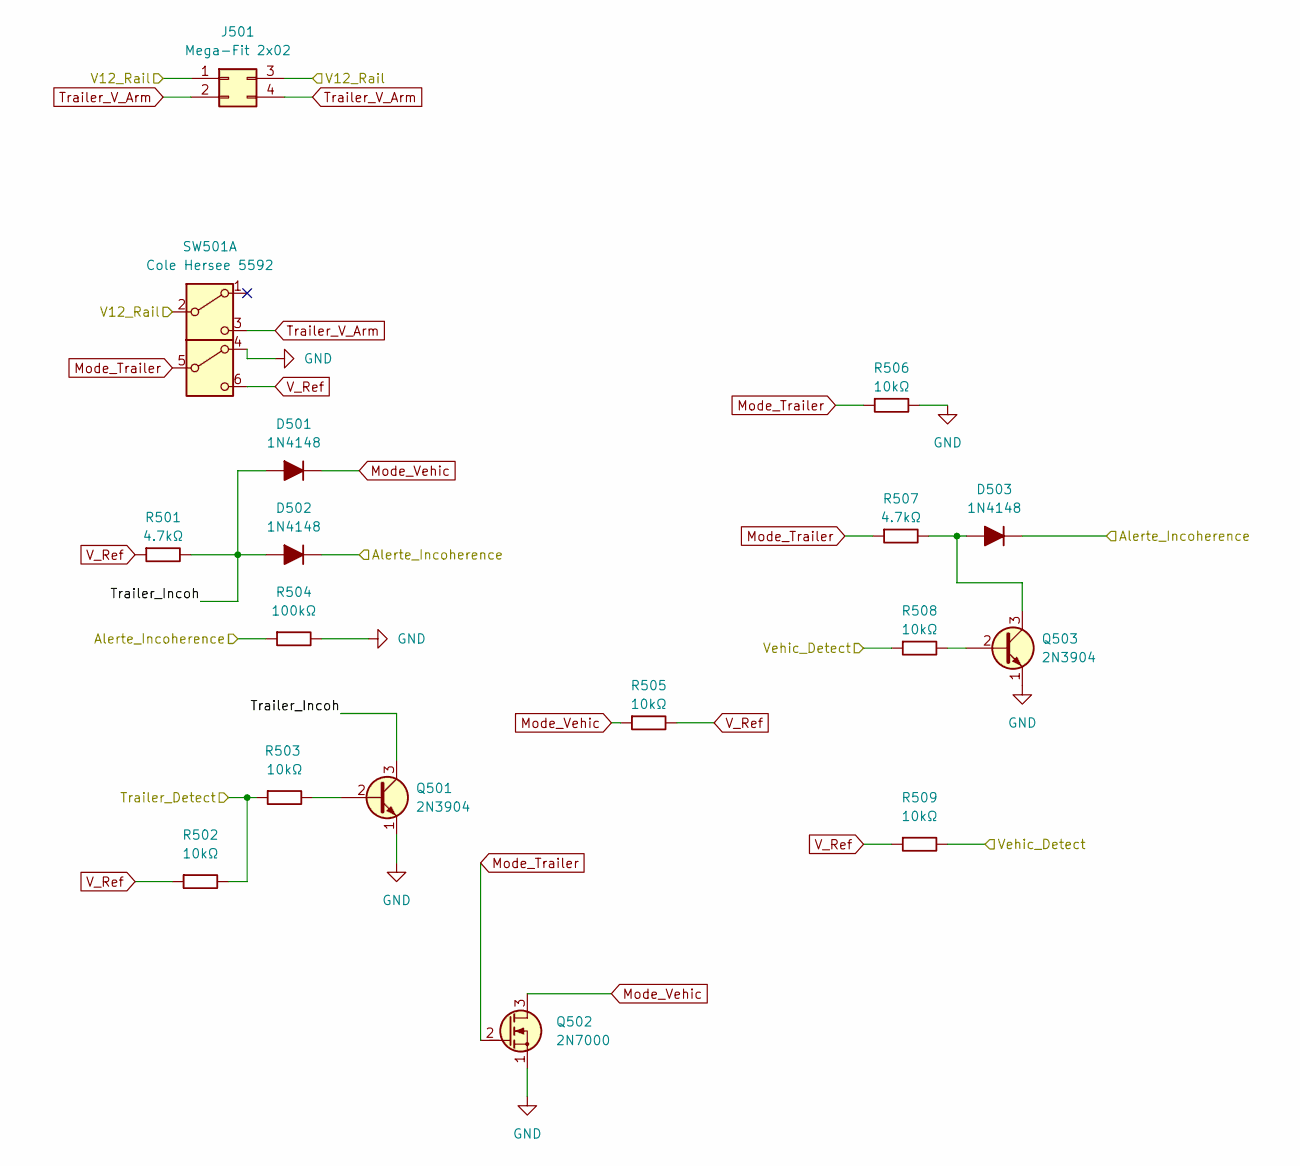
[picture p21: schematic Mode_Coherence.kicad_sch]

Parts:
D501, D502, D503: 1N4148; D_DO-35_SOD27_P7.62mm_Horizontal
J501: Mega-Fit 2x02; Molex_Mega-Fit_76829-0004_2x02_P5.70mm_Vertical; MPN 0768290004
Q501, Q503: 2N3904; TO-92_Inline_Wide_EBC
Q502: 2N7000; TO-92_Inline_Wide_SGD
R501, R507: 4.7kΩ; R_Axial_DIN0207_L6.3mm_D2.5mm_P10.16mm_Horizontal
R502, R503, R505, R506, R508, R509: 10kΩ; R_Axial_DIN0207_L6.3mm_D2.5mm_P10.16mm_Horizontal
R504: 100kΩ; R_Axial_DIN0207_L6.3mm_D2.5mm_P10.16mm_Horizontal
SW501: Cole Hersee 5592

Connections:
/Alerte_Incoherence: D502.1 (K), D503.1 (K), R504.1; also elsewhere on the board
/Mode_Coherence/Trailer_Incoh: D501.2 (A), D502.2 (A), Q501.3 (C), R501.2
/Trailer_Detect: R502.2, R503.1; also elsewhere on the board
/V12_Rail: J501.1, J501.3, SW501.2 (B); also elsewhere on the board
/Vehic_Detect: R508.1, R509.2; also elsewhere on the board
GND: Q501.1 (E), Q502.1 (S), Q503.1 (E), R504.2, R506.2, SW501.4 (A); also elsewhere on the board
Mode_Trailer: Q502.2 (G), R506.1, R507.1, SW501.5 (B); also elsewhere on the board
Mode_Vehic: D501.1 (K), Q502.3 (D), R505.1; also elsewhere on the board
unnamed: D503.2 (A), Q503.3 (C), R507.2
unnamed: Q501.2 (B), R503.2
unnamed: Q503.2 (B), R508.2
Trailer_V_Arm: J501.2, J501.4, SW501.3 (C); also elsewhere on the board
V_Ref: R501.1, R502.1, R505.2, R509.1, SW501.6 (C); also elsewhere on the board
