patricecouillard-code/TrailerDiagnosticSystem/TrailerDiagnosticSystem.kicad_pcb

## KiCad design TrailerDiagnosticSystem.kicad_pcb (continued)

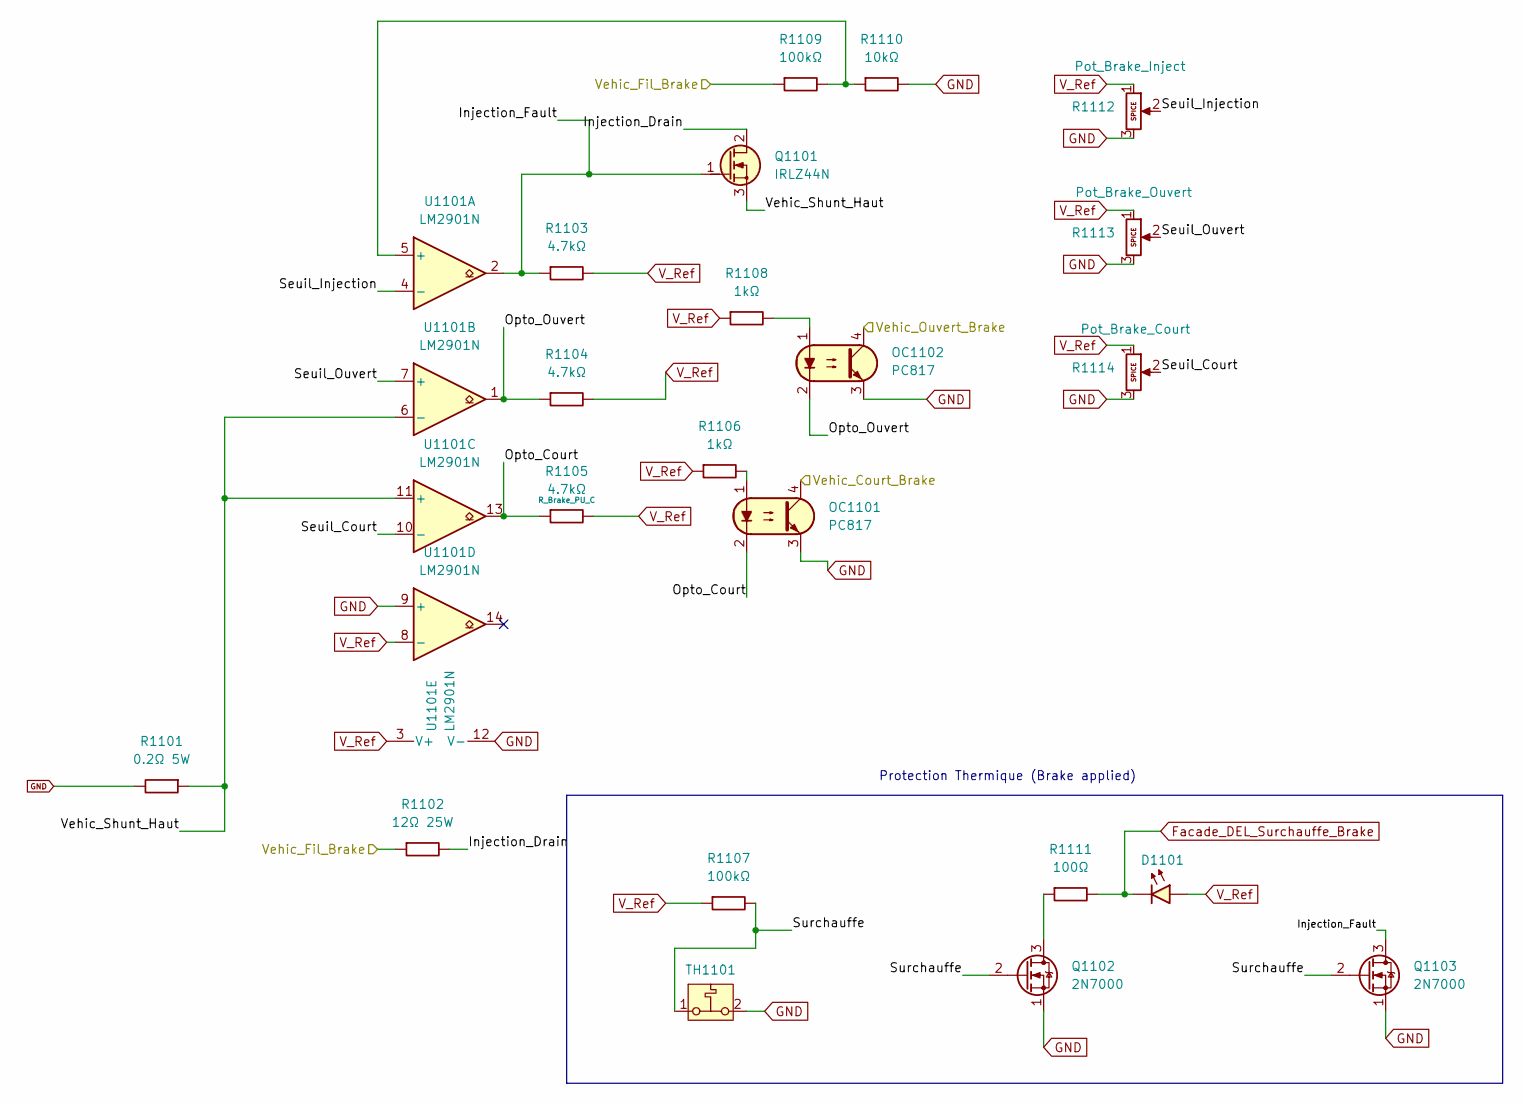
[picture p22: schematic Vehicule_Brake.kicad_sch]

Parts:
D1101: RGB 5mm CA (ambre); LED_D5.0mm-4_RGB_Staggered_Pins; MPN WP154A4SEJ3VBDZGW/CA
OC1101, OC1102: PC817; DIP-4_W7.62mm_LongPads
Q1101: IRLZ44N; TO-220-3_Vertical_GDS
Q1102, Q1103: 2N7000; TO-92_Inline_Wide_SGD
R1101: 0.2Ω 5W; R_Axial_Power_L25.0mm_W9.0mm_P27.94mm; MPN SQP500JB-0R2
R1102: 12Ω 25W; TerminalBlock_Phoenix_PT-1,5-2-3.5-H_1x02_P3.50mm_Horizontal; MPN HSA2512RJ
R1103, R1104, R1105: 4.7kΩ; R_Axial_DIN0207_L6.3mm_D2.5mm_P10.16mm_Horizontal
R1106, R1108: 1kΩ; R_Axial_DIN0207_L6.3mm_D2.5mm_P10.16mm_Horizontal
R1107, R1109: 100kΩ; R_Axial_DIN0207_L6.3mm_D2.5mm_P10.16mm_Horizontal
R1110: 10kΩ; R_Axial_DIN0207_L6.3mm_D2.5mm_P10.16mm_Horizontal
R1111: 100Ω; R_Axial_DIN0207_L6.3mm_D2.5mm_P10.16mm_Horizontal
R1112, R1113, R1114: 10kΩ; TRIM_3296W1103LF; MPN 3296W-1-103LF
TH1101: Thermostat 95°C NC; TerminalBlock_Phoenix_PT-1,5-2-3.5-H_1x02_P3.50mm_Horizontal; MPN CS709525Y
U1101: LM2901N; DIP-14_W7.62mm_Socket

Connections:
/Canal_Brake/Bloc_Test_Brake/Vehic_Court_Brake: OC1101.4; also elsewhere on the board
/Canal_Brake/Bloc_Test_Brake/Vehic_Ouvert_Brake: OC1102.4; also elsewhere on the board
/Canal_Brake/Vehicule_Brake/Injection_Drain: Q1101.2 (D), R1102.2
/Canal_Brake/Vehicule_Brake/Injection_Fault: Q1101.1 (G), Q1103.3 (D), R1103.1, U1101.2
/Canal_Brake/Vehicule_Brake/Opto_Court: OC1101.2, R1105.1, U1101.13
/Canal_Brake/Vehicule_Brake/Opto_Ouvert: OC1102.2, R1104.1, U1101.1
/Canal_Brake/Vehicule_Brake/Seuil_Court: R1114.2, U1101.10 (-)
/Canal_Brake/Vehicule_Brake/Seuil_Injection: R1112.2, U1101.4 (-)
/Canal_Brake/Vehicule_Brake/Seuil_Ouvert: R1113.2, U1101.7 (+)
/Canal_Brake/Vehicule_Brake/Surchauffe: Q1102.2 (G), Q1103.2 (G), R1107.2, TH1101.1
/Canal_Brake/Vehicule_Brake/Vehic_Shunt_Haut: Q1101.3 (S), R1101.1, U1101.6 (-), U1101.11 (+)
/Vehic_Fil_Brake: R1102.1, R1109.1; also elsewhere on the board
Facade_DEL_Surchauffe_Brake: D1101.1 (K), R1111.2; also elsewhere on the board
GND: OC1101.3, OC1102.3, Q1102.1 (S), Q1103.1 (S), R1101.2, R1110.2, R1112.3, R1113.3, R1114.3, TH1101.2, U1101.9 (+), U1101.12 (V-); also elsewhere on the board
unnamed: OC1101.1, R1106.2
unnamed: OC1102.1, R1108.2
unnamed: Q1102.3 (D), R1111.1
unnamed: R1109.2, R1110.1, U1101.5 (+)
V_Ref: D1101.2 (A), R1103.2, R1104.2, R1105.2, R1106.1, R1107.1, R1108.1, R1112.1, R1113.1, R1114.1, U1101.3 (V+), U1101.8 (-); also elsewhere on the board

Notes on the sheet:
Protection Thermique (Brake applied)

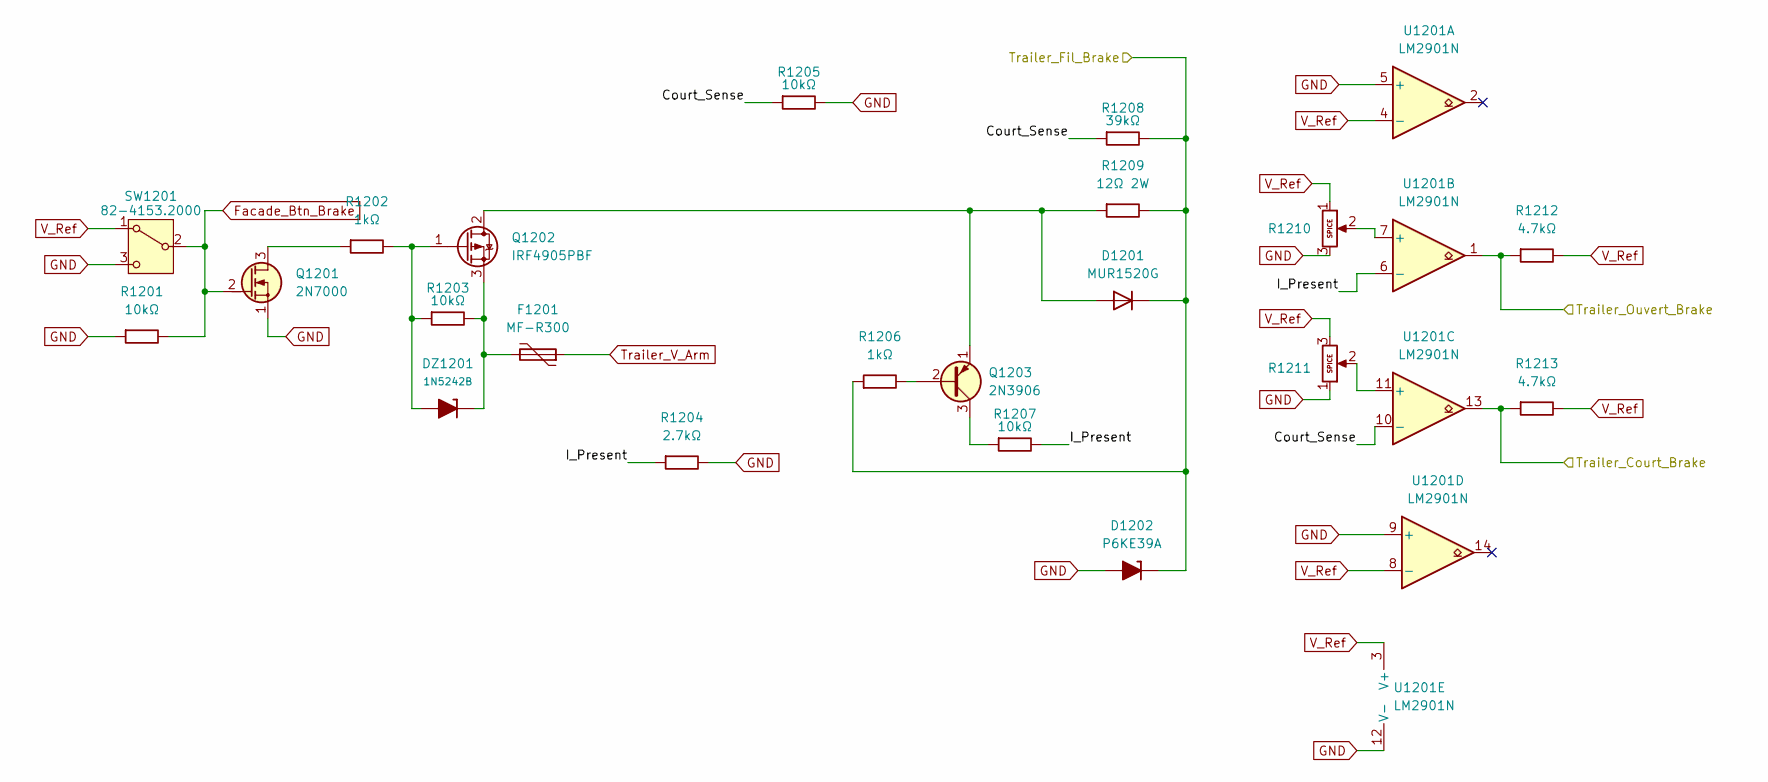
[picture p23: schematic Trailer_Brake.kicad_sch]

Parts:
D1201: MUR1520G; TO-220-2_Vertical
D1202: P6KE39A; D_DO-15_P10.16mm_Horizontal_Zener
DZ1201: 1N5242B; D_DO-35_SOD27_P7.62mm_Horizontal_Zener
F1201: MF-R300; PTC_Bourns_MF-R_P5.10mm_W12.0mm
Q1201: 2N7000; TO-92_Inline_Wide_SGD
Q1202: IRF4905PBF; TO-220-3_Vertical
Q1203: 2N3906; TO-92_Inline_Wide_EBC
R1201, R1203, R1205, R1207: 10kΩ; R_Axial_DIN0207_L6.3mm_D2.5mm_P10.16mm_Horizontal
R1202, R1206: 1kΩ; R_Axial_DIN0207_L6.3mm_D2.5mm_P10.16mm_Horizontal
R1204: 2.7kΩ; R_Axial_DIN0207_L6.3mm_D2.5mm_P10.16mm_Horizontal
R1208: 39kΩ; R_Axial_DIN0207_L6.3mm_D2.5mm_P10.16mm_Horizontal
R1209: 12Ω 2W; R_Axial_DIN0414_L11.9mm_D4.5mm_P15.24mm_Horizontal; MPN PR02000201209JR500
R1210, R1211: 10kΩ; TRIM_3296W1103LF; MPN 3296W-1-103LF
R1212, R1213: 4.7kΩ; R_Axial_DIN0207_L6.3mm_D2.5mm_P10.16mm_Horizontal
SW1201: 82-4153.2000
U1201: LM2901N; DIP-14_W7.62mm_Socket

Connections:
/Canal_Brake/Bloc_Test_Brake/Trailer_Court_Brake: R1213.1, U1201.13; also elsewhere on the board
/Canal_Brake/Bloc_Test_Brake/Trailer_Ouvert_Brake: R1212.1, U1201.1; also elsewhere on the board
/Canal_Brake/Trailer_Brake/Court_Sense: R1205.1, R1208.1, U1201.10 (-)
/Canal_Brake/Trailer_Brake/I_Present: R1204.1, R1207.2, U1201.6 (-)
/Trailer_Fil_Brake: D1201.1 (K), D1202.1 (K), R1206.1, R1208.2, R1209.2; also elsewhere on the board
Facade_Btn_Brake: Q1201.2 (G), R1201.2, SW1201.2 (B); also elsewhere on the board
GND: D1202.2 (A), Q1201.1 (S), R1201.1, R1204.2, R1205.2, R1210.3, R1211.1, SW1201.3 (C), U1201.5 (+), U1201.9 (+), U1201.12 (V-); also elsewhere on the board
unnamed: D1201.2 (A), Q1202.2 (D), Q1203.1 (E), R1209.1
unnamed: DZ1201.2 (A), Q1202.1 (G), R1202.2, R1203.1
unnamed: DZ1201.1 (K), F1201.2, Q1202.3 (S), R1203.2
unnamed: Q1201.3 (D), R1202.1
unnamed: Q1203.2 (B), R1206.2
unnamed: Q1203.3 (C), R1207.1
unnamed: R1210.2, U1201.7 (+)
unnamed: R1211.2, U1201.11 (+)
Trailer_V_Arm: F1201.1; also elsewhere on the board
V_Ref: R1210.1, R1211.3, R1212.2, R1213.2, SW1201.1 (A), U1201.3 (V+), U1201.4 (-), U1201.8 (-); also elsewhere on the board

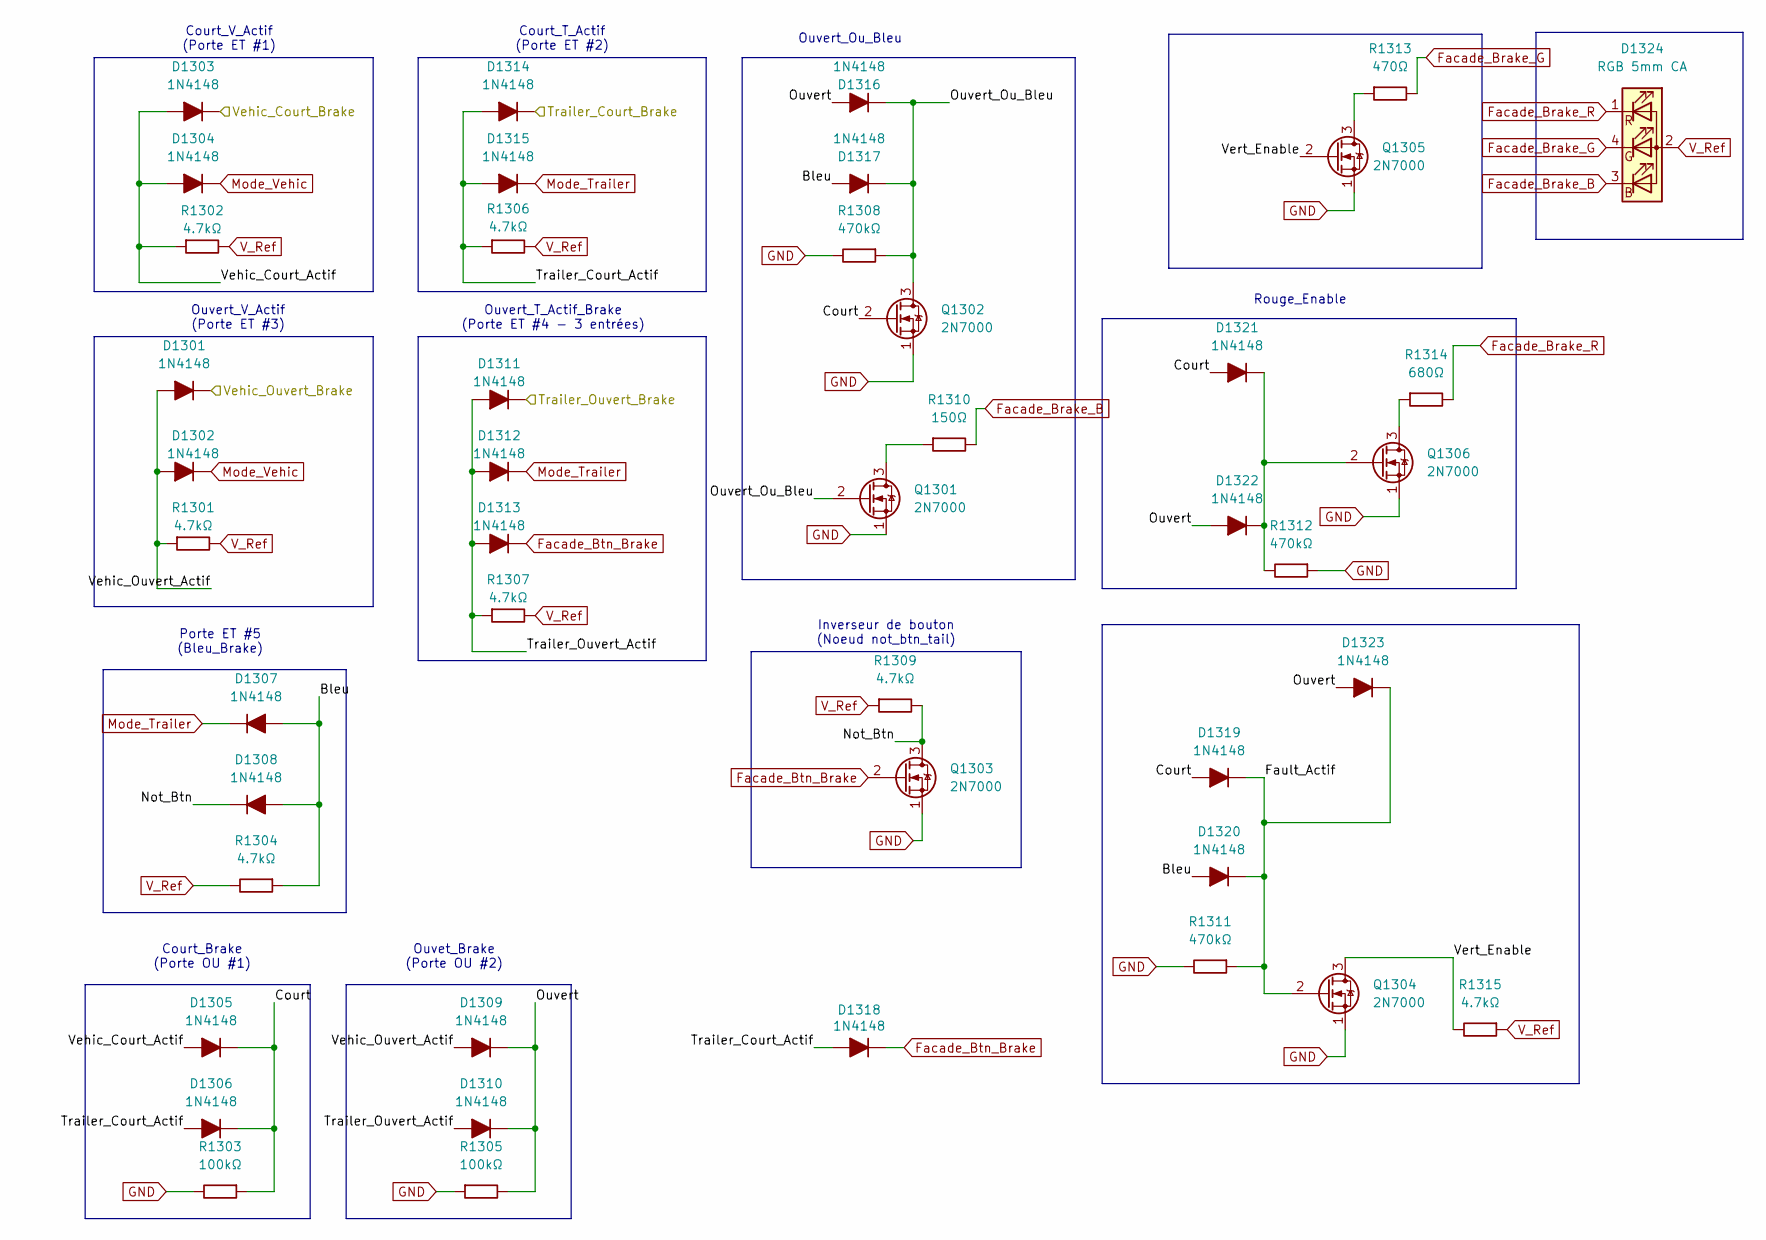
[picture p24: schematic Bloc_Test_Brake.kicad_sch]

Parts:
D1301, D1302, D1303, D1304, D1305, D1306, D1307, D1308, D1309, D1310, D1311, D1312, D1313, D1314, D1315, D1316, D1317, D1318, D1319, D1320, D1321, D1322, D1323: 1N4148; D_DO-35_SOD27_P7.62mm_Horizontal
D1324: RGB 5mm CA; LED_D5.0mm-4_RGB_Staggered_Pins; MPN WP154A4SEJ3VBDZGW/CA
Q1301, Q1302, Q1303, Q1304, Q1305, Q1306: 2N7000; TO-92_Inline_Wide_SGD
R1301, R1302, R1304, R1306, R1307, R1309, R1315: 4.7kΩ; R_Axial_DIN0207_L6.3mm_D2.5mm_P10.16mm_Horizontal
R1303, R1305: 100kΩ; R_Axial_DIN0207_L6.3mm_D2.5mm_P10.16mm_Horizontal
R1308, R1311, R1312: 470kΩ; R_Axial_DIN0207_L6.3mm_D2.5mm_P10.16mm_Horizontal
R1310: 150Ω; R_Axial_DIN0207_L6.3mm_D2.5mm_P10.16mm_Horizontal
R1313: 470Ω; R_Axial_DIN0207_L6.3mm_D2.5mm_P10.16mm_Horizontal
R1314: 680Ω; R_Axial_DIN0207_L6.3mm_D2.5mm_P10.16mm_Horizontal

Connections:
/Canal_Brake/Bloc_Test_Brake/Bleu: D1307.2 (A), D1308.2 (A), D1317.2 (A), D1320.2 (A), R1304.1
/Canal_Brake/Bloc_Test_Brake/Court: D1305.1 (K), D1306.1 (K), D1319.2 (A), D1321.2 (A), Q1302.2 (G), R1303.1
/Canal_Brake/Bloc_Test_Brake/Fault_Actif: D1319.1 (K), D1320.1 (K), D1323.1 (K), Q1304.2 (G), R1311.1
/Canal_Brake/Bloc_Test_Brake/Not_Btn: D1308.1 (K), Q1303.3 (D), R1309.2
/Canal_Brake/Bloc_Test_Brake/Ouvert: D1309.1 (K), D1310.1 (K), D1316.2 (A), D1322.2 (A), D1323.2 (A), R1305.2
/Canal_Brake/Bloc_Test_Brake/Ouvert_Ou_Bleu: D1316.1 (K), D1317.1 (K), Q1301.2 (G), Q1302.3 (D), R1308.1
/Canal_Brake/Bloc_Test_Brake/Trailer_Court_Actif: D1306.2 (A), D1314.2 (A), D1315.2 (A), D1318.2 (A), R1306.1
/Canal_Brake/Bloc_Test_Brake/Trailer_Court_Brake: D1314.1 (K); also elsewhere on the board
/Canal_Brake/Bloc_Test_Brake/Trailer_Ouvert_Actif: D1310.2 (A), D1311.2 (A), D1312.2 (A), D1313.2 (A), R1307.1
/Canal_Brake/Bloc_Test_Brake/Trailer_Ouvert_Brake: D1311.1 (K); also elsewhere on the board
/Canal_Brake/Bloc_Test_Brake/Vehic_Court_Actif: D1303.2 (A), D1304.2 (A), D1305.2 (A), R1302.1
/Canal_Brake/Bloc_Test_Brake/Vehic_Court_Brake: D1303.1 (K); also elsewhere on the board
/Canal_Brake/Bloc_Test_Brake/Vehic_Ouvert_Actif: D1301.2 (A), D1302.2 (A), D1309.2 (A), R1301.1
/Canal_Brake/Bloc_Test_Brake/Vehic_Ouvert_Brake: D1301.1 (K); also elsewhere on the board
/Canal_Brake/Bloc_Test_Brake/Vert_Enable: Q1304.3 (D), Q1305.2 (G), R1315.2
Facade_Brake_B: D1324.3 (BK), R1310.2; also elsewhere on the board
Facade_Brake_G: D1324.4 (GK), R1313.2; also elsewhere on the board
Facade_Brake_R: D1324.1 (RK), R1314.2; also elsewhere on the board
Facade_Btn_Brake: D1313.1 (K), D1318.1 (K), Q1303.2 (G); also elsewhere on the board
GND: Q1301.1 (S), Q1302.1 (S), Q1303.1 (S), Q1304.1 (S), Q1305.1 (S), Q1306.1 (S), R1303.2, R1305.1, R1308.2, R1311.2, R1312.1; also elsewhere on the board
Mode_Trailer: D1307.1 (K), D1312.1 (K), D1315.1 (K); also elsewhere on the board
Mode_Vehic: D1302.1 (K), D1304.1 (K); also elsewhere on the board
unnamed: D1321.1 (K), D1322.1 (K), Q1306.2 (G), R1312.2
unnamed: Q1301.3 (D), R1310.1
unnamed: Q1305.3 (D), R1313.1
unnamed: Q1306.3 (D), R1314.1
V_Ref: D1324.2 (A), R1301.2, R1302.2, R1304.2, R1306.2, R1307.2, R1309.1, R1315.1; also elsewhere on the board

Notes on the sheet:
Ouvert_V_Actif (Porte ET #3)
Court_V_Actif (Porte ET #1)
Court_T_Actif (Porte ET #2)
Rouge_Enable
Inverseur de bouton (Noeud not_btn_tail)
Court_Brake (Porte OU #1)
Ouvert_T_Actif_Brake (Porte ET #4 - 3 entrées)
Ouvert_Ou_Bleu
Ouvet_Brake (Porte OU #2)
Porte ET #5 (Bleu_Brake)

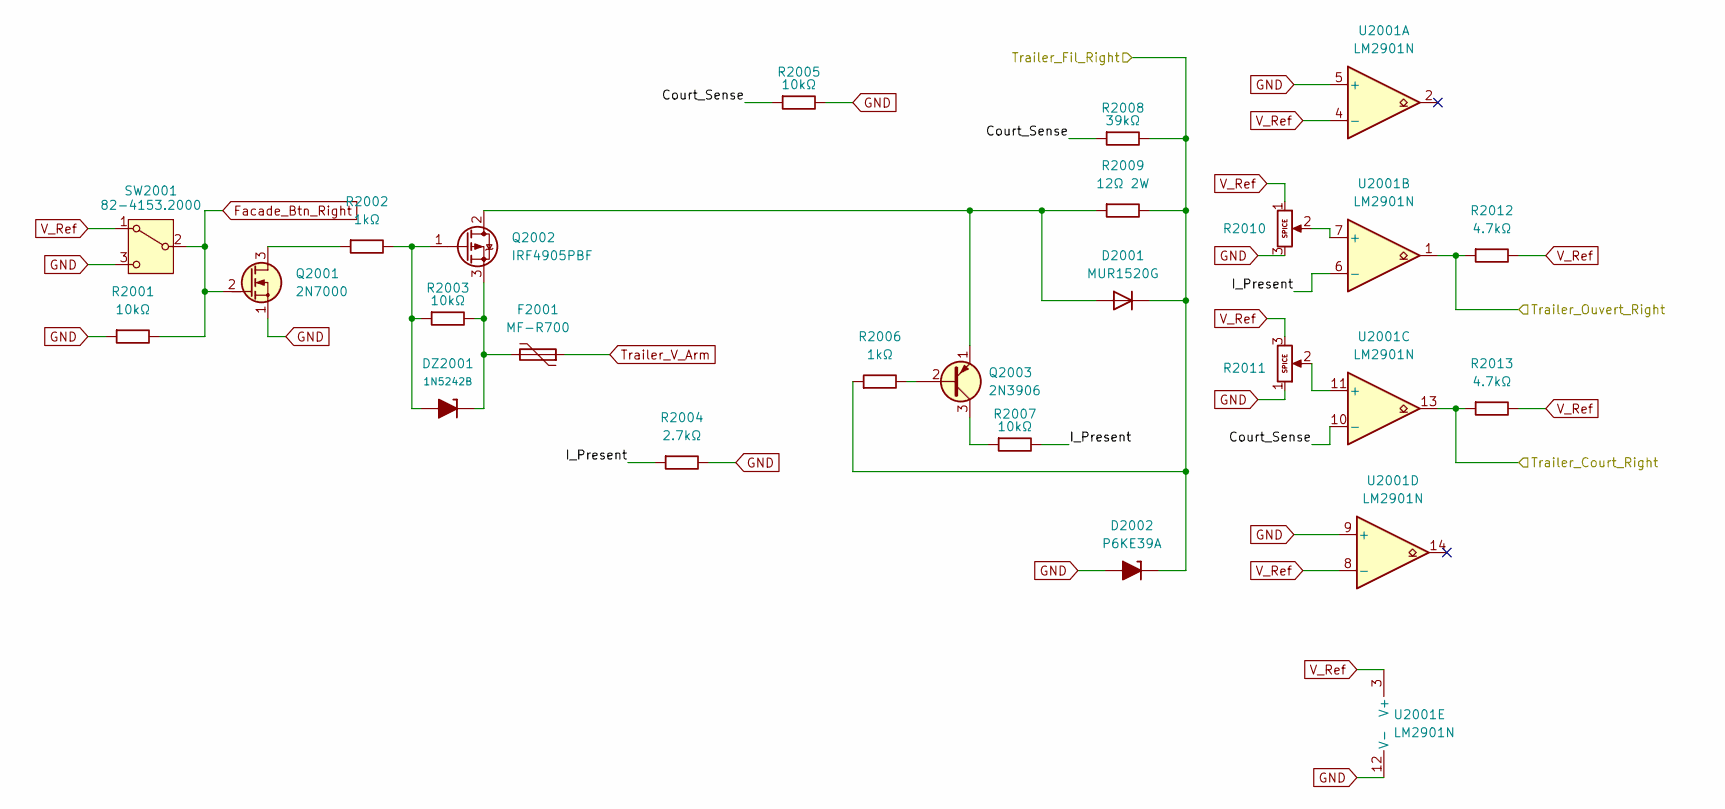
[picture p25: schematic Trailer_Right.kicad_sch]

Parts:
D2001: MUR1520G; TO-220-2_Vertical
D2002: P6KE39A; D_DO-15_P10.16mm_Horizontal_Zener
DZ2001: 1N5242B; D_DO-35_SOD27_P7.62mm_Horizontal_Zener
F2001: MF-R700; PTC_Bourns_MF-R_P10.20mm_W24.2mm
Q2001: 2N7000; TO-92_Inline_Wide_SGD
Q2002: IRF4905PBF; TO-220-3_Vertical
Q2003: 2N3906; TO-92_Inline_Wide_EBC
R2001, R2003, R2005, R2007: 10kΩ; R_Axial_DIN0207_L6.3mm_D2.5mm_P10.16mm_Horizontal
R2002, R2006: 1kΩ; R_Axial_DIN0207_L6.3mm_D2.5mm_P10.16mm_Horizontal
R2004: 2.7kΩ; R_Axial_DIN0207_L6.3mm_D2.5mm_P10.16mm_Horizontal
R2008: 39kΩ; R_Axial_DIN0207_L6.3mm_D2.5mm_P10.16mm_Horizontal
R2009: 12Ω 2W; R_Axial_DIN0414_L11.9mm_D4.5mm_P15.24mm_Horizontal; MPN PR02000201209JR500
R2010, R2011: 10kΩ; TRIM_3296W1103LF; MPN 3296W-1-103LF
R2012, R2013: 4.7kΩ; R_Axial_DIN0207_L6.3mm_D2.5mm_P10.16mm_Horizontal
SW2001: 82-4153.2000
U2001: LM2901N; DIP-14_W7.62mm_Socket

Connections:
/Canal_Right/Bloc_Test_Right/Trailer_Court_Right: R2013.1, U2001.13; also elsewhere on the board
/Canal_Right/Bloc_Test_Right/Trailer_Ouvert_Right: R2012.1, U2001.1; also elsewhere on the board
/Canal_Right/Trailer_Right/Court_Sense: R2005.1, R2008.1, U2001.10 (-)
/Canal_Right/Trailer_Right/I_Present: R2004.1, R2007.2, U2001.6 (-)
/Trailer_Fil_Right: D2001.1 (K), D2002.1 (K), R2006.1, R2008.2, R2009.2; also elsewhere on the board
Facade_Btn_Right: Q2001.2 (G), R2001.2, SW2001.2 (B); also elsewhere on the board
GND: D2002.2 (A), Q2001.1 (S), R2001.1, R2004.2, R2005.2, R2010.3, R2011.1, SW2001.3 (C), U2001.5 (+), U2001.9 (+), U2001.12 (V-); also elsewhere on the board
unnamed: D2001.2 (A), Q2002.2 (D), Q2003.1 (E), R2009.1
unnamed: DZ2001.2 (A), Q2002.1 (G), R2002.2, R2003.1
unnamed: DZ2001.1 (K), F2001.2, Q2002.3 (S), R2003.2
unnamed: Q2001.3 (D), R2002.1
unnamed: Q2003.2 (B), R2006.2
unnamed: Q2003.3 (C), R2007.1
unnamed: R2010.2, U2001.7 (+)
unnamed: R2011.2, U2001.11 (+)
Trailer_V_Arm: F2001.1; also elsewhere on the board
V_Ref: R2010.1, R2011.3, R2012.2, R2013.2, SW2001.1 (A), U2001.3 (V+), U2001.4 (-), U2001.8 (-); also elsewhere on the board

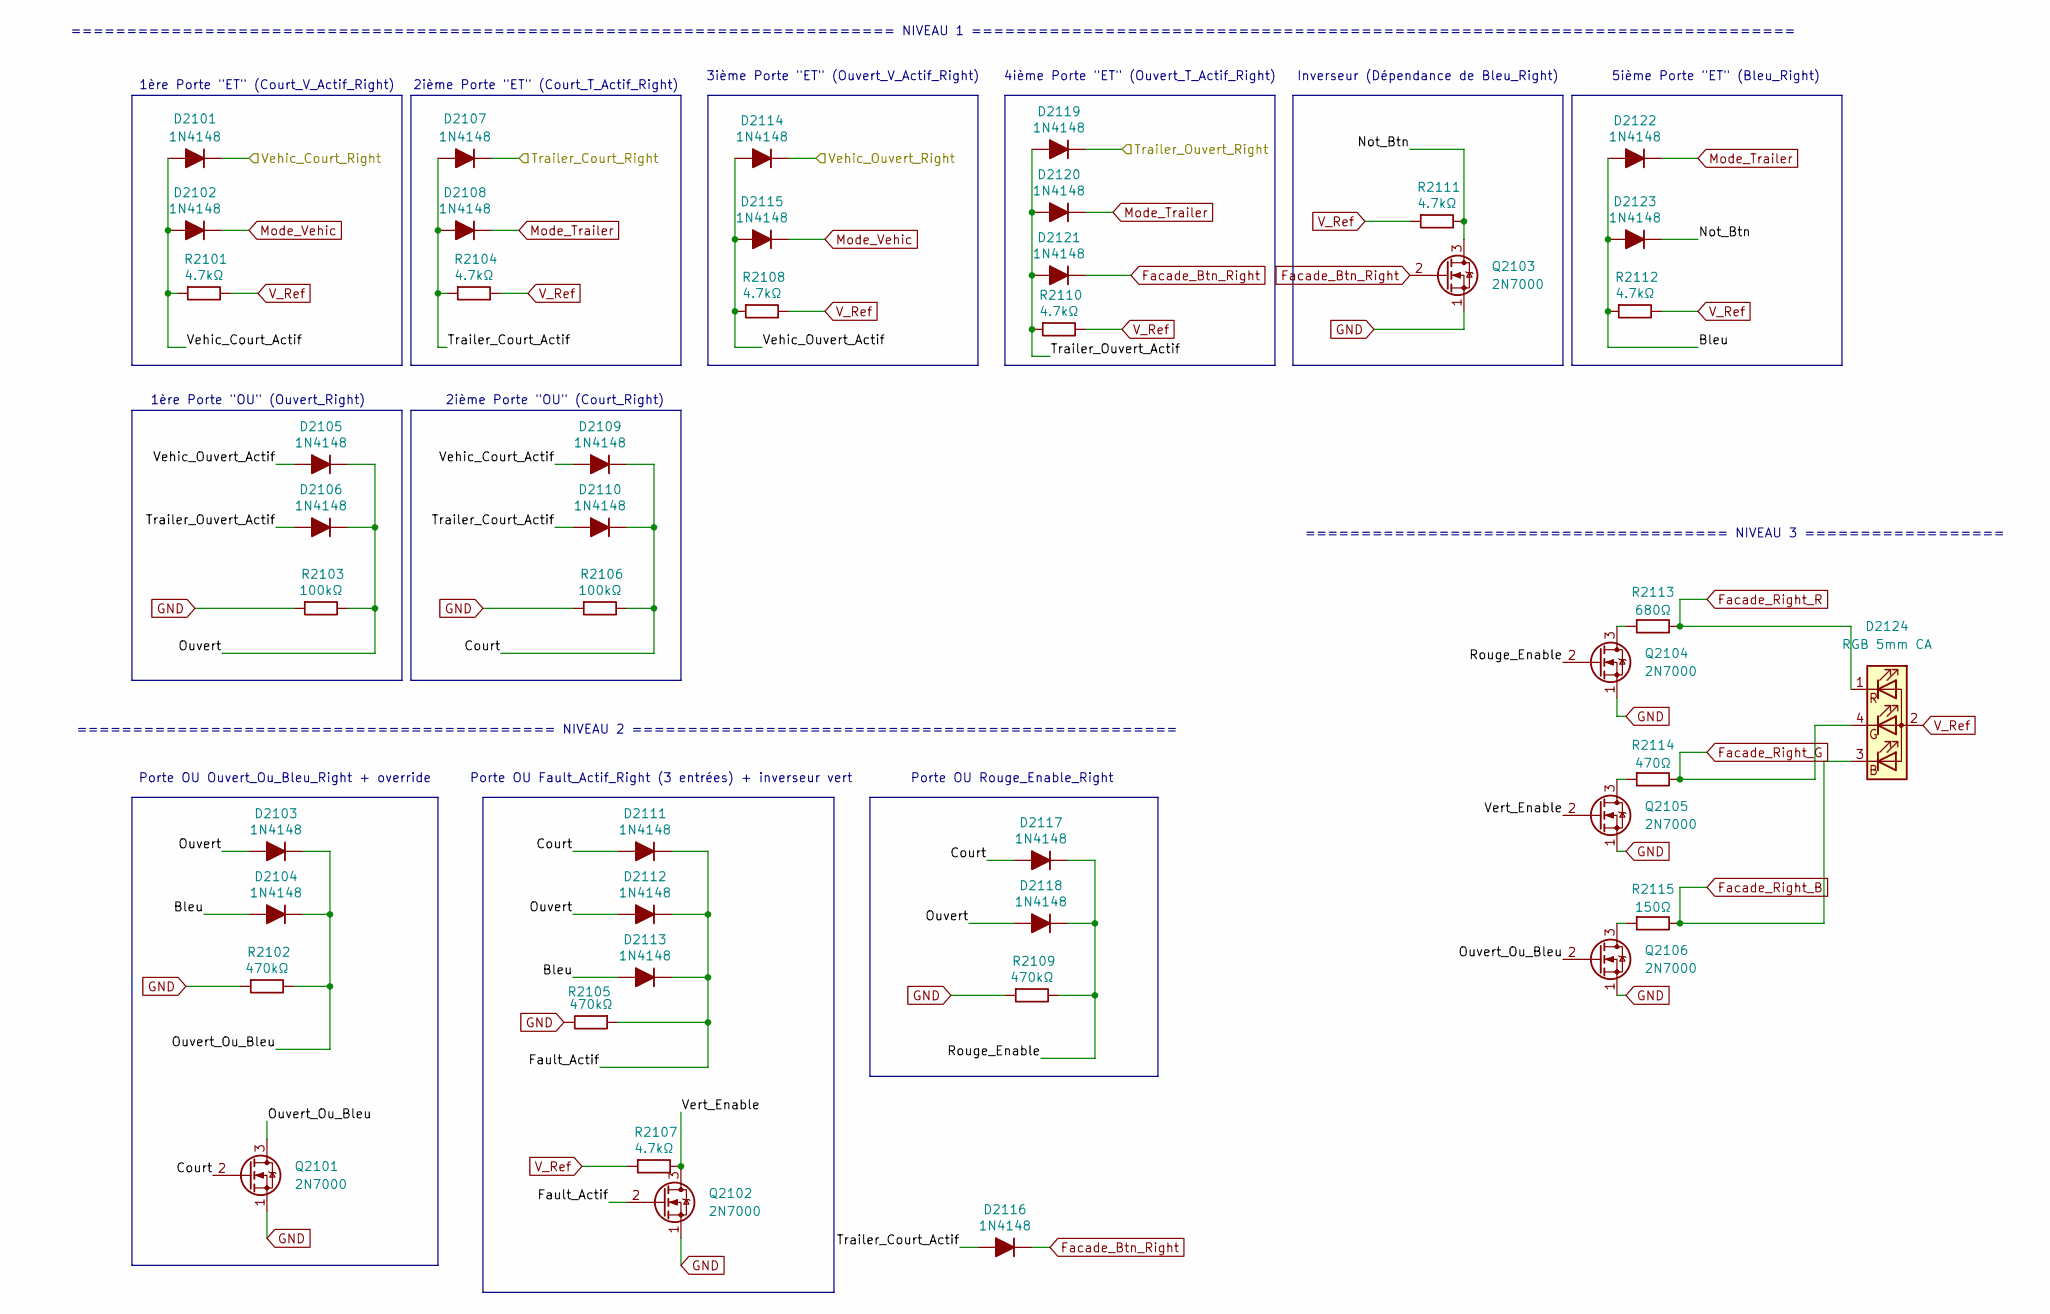
[picture p26: schematic Bloc_Test_Right.kicad_sch]

Parts:
D2101, D2102, D2103, D2104, D2105, D2106, D2107, D2108, D2109, D2110, D2111, D2112, D2113, D2114, D2115, D2116, D2117, D2118, D2119, D2120, D2121, D2122, D2123: 1N4148; D_DO-35_SOD27_P7.62mm_Horizontal
D2124: RGB 5mm CA; LED_D5.0mm-4_RGB_Staggered_Pins; MPN WP154A4SEJ3VBDZGW/CA
Q2101, Q2102, Q2103, Q2104, Q2105, Q2106: 2N7000; TO-92_Inline_Wide_SGD
R2101, R2104, R2107, R2108, R2110, R2111, R2112: 4.7kΩ; R_Axial_DIN0207_L6.3mm_D2.5mm_P10.16mm_Horizontal
R2102, R2105, R2109: 470kΩ; R_Axial_DIN0207_L6.3mm_D2.5mm_P10.16mm_Horizontal
R2103, R2106: 100kΩ; R_Axial_DIN0207_L6.3mm_D2.5mm_P10.16mm_Horizontal
R2113: 680Ω; R_Axial_DIN0207_L6.3mm_D2.5mm_P10.16mm_Horizontal
R2114: 470Ω; R_Axial_DIN0207_L6.3mm_D2.5mm_P10.16mm_Horizontal
R2115: 150Ω; R_Axial_DIN0207_L6.3mm_D2.5mm_P10.16mm_Horizontal

Connections:
/Canal_Right/Bloc_Test_Right/Bleu: D2104.2 (A), D2113.2 (A), D2122.2 (A), D2123.2 (A), R2112.1
/Canal_Right/Bloc_Test_Right/Court: D2109.1 (K), D2110.1 (K), D2111.2 (A), D2117.2 (A), Q2101.2 (G), R2106.2
/Canal_Right/Bloc_Test_Right/Fault_Actif: D2111.1 (K), D2112.1 (K), D2113.1 (K), Q2102.2 (G), R2105.1
/Canal_Right/Bloc_Test_Right/Not_Btn: D2123.1 (K), Q2103.3 (D), R2111.2
/Canal_Right/Bloc_Test_Right/Ouvert: D2103.2 (A), D2105.1 (K), D2106.1 (K), D2112.2 (A), D2118.2 (A), R2103.2
/Canal_Right/Bloc_Test_Right/Ouvert_Ou_Bleu: D2103.1 (K), D2104.1 (K), Q2101.3 (D), Q2106.2 (G), R2102.2
/Canal_Right/Bloc_Test_Right/Rouge_Enable: D2117.1 (K), D2118.1 (K), Q2104.2 (G), R2109.2
/Canal_Right/Bloc_Test_Right/Trailer_Court_Actif: D2107.2 (A), D2108.2 (A), D2110.2 (A), D2116.2 (A), R2104.1
/Canal_Right/Bloc_Test_Right/Trailer_Court_Right: D2107.1 (K); also elsewhere on the board
/Canal_Right/Bloc_Test_Right/Trailer_Ouvert_Actif: D2106.2 (A), D2119.2 (A), D2120.2 (A), D2121.2 (A), R2110.1
/Canal_Right/Bloc_Test_Right/Trailer_Ouvert_Right: D2119.1 (K); also elsewhere on the board
/Canal_Right/Bloc_Test_Right/Vehic_Court_Actif: D2101.2 (A), D2102.2 (A), D2109.2 (A), R2101.1
/Canal_Right/Bloc_Test_Right/Vehic_Court_Right: D2101.1 (K); also elsewhere on the board
/Canal_Right/Bloc_Test_Right/Vehic_Ouvert_Actif: D2105.2 (A), D2114.2 (A), D2115.2 (A), R2108.1
/Canal_Right/Bloc_Test_Right/Vehic_Ouvert_Right: D2114.1 (K); also elsewhere on the board
/Canal_Right/Bloc_Test_Right/Vert_Enable: Q2102.3 (D), Q2105.2 (G), R2107.2
Facade_Btn_Right: D2116.1 (K), D2121.1 (K), Q2103.2 (G); also elsewhere on the board
Facade_Right_B: D2124.3 (BK), R2115.2; also elsewhere on the board
Facade_Right_G: D2124.4 (GK), R2114.2; also elsewhere on the board
Facade_Right_R: D2124.1 (RK), R2113.2; also elsewhere on the board
GND: Q2101.1 (S), Q2102.1 (S), Q2103.1 (S), Q2104.1 (S), Q2105.1 (S), Q2106.1 (S), R2102.1, R2103.1, R2105.2, R2106.1, R2109.1; also elsewhere on the board
Mode_Trailer: D2108.1 (K), D2120.1 (K), D2122.1 (K); also elsewhere on the board
Mode_Vehic: D2102.1 (K), D2115.1 (K); also elsewhere on the board
unnamed: Q2104.3 (D), R2113.1
unnamed: Q2105.3 (D), R2114.1
unnamed: Q2106.3 (D), R2115.1
V_Ref: D2124.2 (A), R2101.2, R2104.2, R2107.1, R2108.2, R2110.2, R2111.1, R2112.2; also elsewhere on the board

Notes on the sheet:
========================================================================== NIVEAU 1 ==========================================================================
Porte OU Fault_Actif_Right (3 entrées) + inverseur vert
3ième Porte "ET" (Ouvert_V_Actif_Right)
=========================================== NIVEAU 2 =================================================
1ère Porte "OU" (Ouvert_Right)
2ième Porte "OU" (Court_Right)
1ère Porte "ET" (Court_V_Actif_Right)
Porte OU Rouge_Enable_Right
4ième Porte "ET" (Ouvert_T_Actif_Right)
Inverseur (Dépendance de Bleu_Right)
2ième Porte "ET" (Court_T_Actif_Right)
5ième Porte "ET" (Bleu_Right)
====================================== NIVEAU 3 ==================
Porte OU Ouvert_Ou_Bleu_Right + override

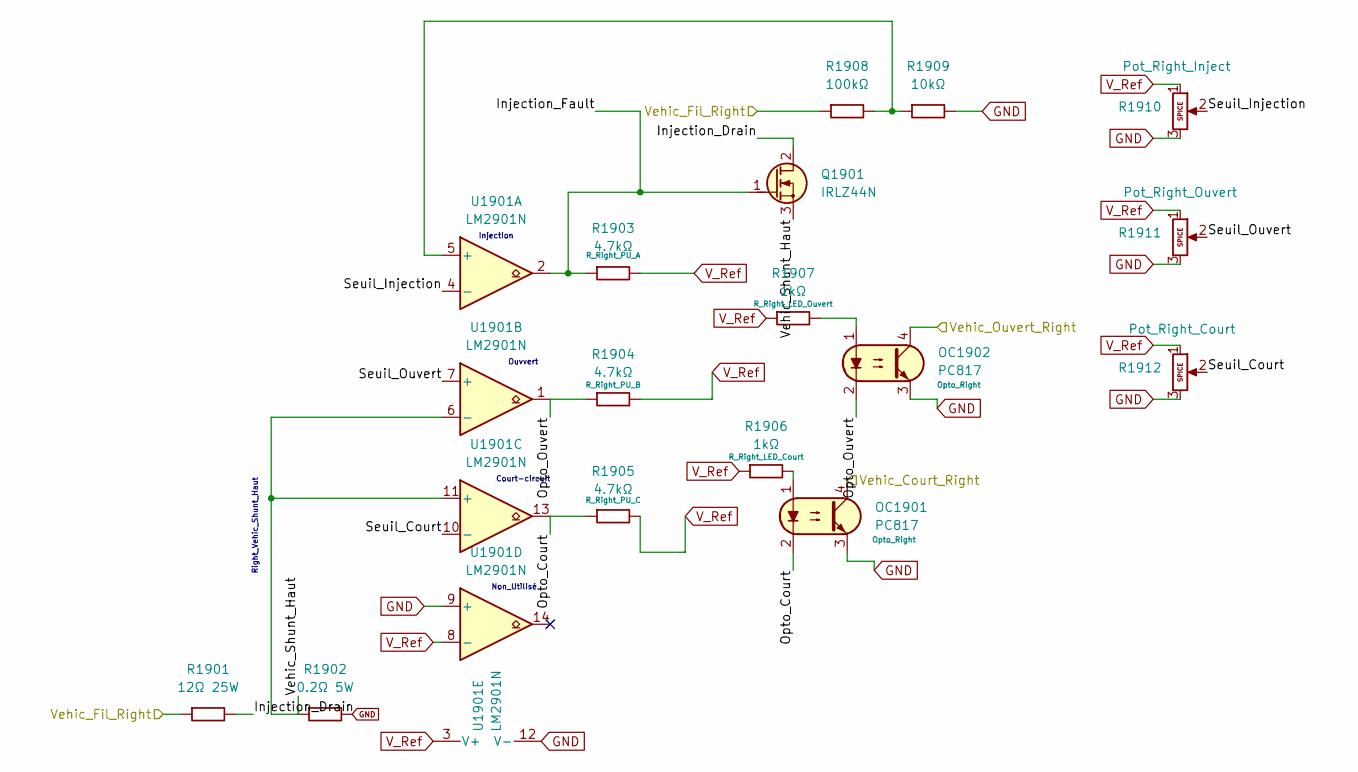
[picture p27: schematic Vehicule_Right.kicad_sch]

Parts:
OC1901, OC1902: PC817; DIP-4_W7.62mm_LongPads
Q1901: IRLZ44N; TO-220-3_Vertical_GDS
R1901: 12Ω 25W; TerminalBlock_Phoenix_PT-1,5-2-3.5-H_1x02_P3.50mm_Horizontal; MPN HSA2512RJ
R1902: 0.2Ω 5W; R_Axial_Power_L25.0mm_W9.0mm_P27.94mm; MPN SQP500JB-0R2
R1903, R1904, R1905: 4.7kΩ; R_Axial_DIN0207_L6.3mm_D2.5mm_P10.16mm_Horizontal
R1906, R1907: 1kΩ; R_Axial_DIN0207_L6.3mm_D2.5mm_P10.16mm_Horizontal
R1908: 100kΩ; R_Axial_DIN0207_L6.3mm_D2.5mm_P10.16mm_Horizontal
R1909: 10kΩ; R_Axial_DIN0207_L6.3mm_D2.5mm_P10.16mm_Horizontal
R1910, R1911, R1912: 10kΩ; TRIM_3296W1103LF; MPN 3296W-1-103LF
U1901: LM2901N; DIP-14_W7.62mm_Socket

Connections:
/Canal_Right/Bloc_Test_Right/Vehic_Court_Right: OC1901.4; also elsewhere on the board
/Canal_Right/Bloc_Test_Right/Vehic_Ouvert_Right: OC1902.4; also elsewhere on the board
/Canal_Right/Vehicule_Right/Injection_Drain: Q1901.2 (D), R1901.2
/Canal_Right/Vehicule_Right/Injection_Fault: Q1901.1 (G), R1903.1, U1901.2
/Canal_Right/Vehicule_Right/Opto_Court: OC1901.2, R1905.1, U1901.13
/Canal_Right/Vehicule_Right/Opto_Ouvert: OC1902.2, R1904.1, U1901.1
/Canal_Right/Vehicule_Right/Seuil_Court: R1912.2, U1901.10 (-)
/Canal_Right/Vehicule_Right/Seuil_Injection: R1910.2, U1901.4 (-)
/Canal_Right/Vehicule_Right/Seuil_Ouvert: R1911.2, U1901.7 (+)
/Canal_Right/Vehicule_Right/Vehic_Shunt_Haut: Q1901.3 (S), R1902.1, U1901.6 (-), U1901.11 (+)
/Vehic_Fil_Right: R1901.1, R1908.1; also elsewhere on the board
GND: OC1901.3, OC1902.3, R1902.2, R1909.2, R1910.3, R1911.3, R1912.3, U1901.9 (+), U1901.12 (V-); also elsewhere on the board
unnamed: OC1901.1, R1906.2
unnamed: OC1902.1, R1907.2
unnamed: R1908.2, R1909.1, U1901.5 (+)
V_Ref: R1903.2, R1904.2, R1905.2, R1906.1, R1907.1, R1910.1, R1911.1, R1912.1, U1901.3 (V+), U1901.8 (-); also elsewhere on the board

Notes on the sheet:
Non_Utilisé
Court-circuit
Ouvvert
Right_Vehic_Shunt_Haut
Injection

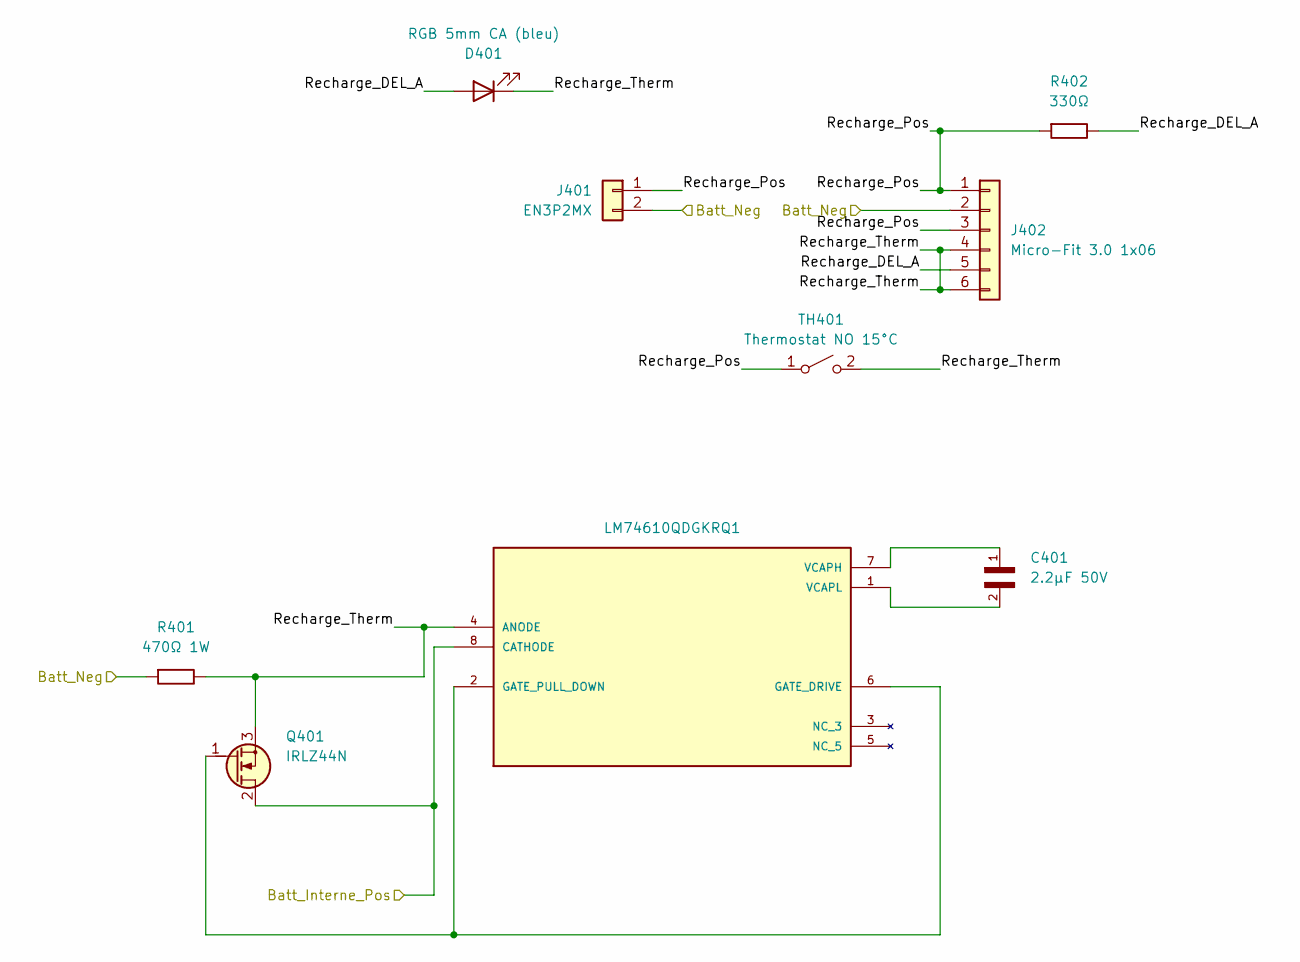
[picture p28: schematic Recharge_Pack.kicad_sch]

Parts:
C401: 2.2µF 50V; CAPRB500W50L450T300H550; MPN FG24X7R1H225KRT06
D401: RGB 5mm CA (bleu); MPN WP154A4SEJ3VBDZGW/CA
J401: EN3P2MX
J402: Micro-Fit 3.0 1x06; Molex_Micro-Fit_3.0_43650-0615_1x06_P3.00mm_Vertical
Q401: IRLZ44N; TO-220-3_Vertical_GDS
R401: 470Ω 1W; R_Axial_DIN0309_L9.0mm_D3.2mm_P12.70mm_Horizontal; MPN PR01000104700JR500
R402: 330Ω; R_Axial_DIN0207_L6.3mm_D2.5mm_P10.16mm_Horizontal
TH401: Thermostat NO 15°C; MPN CS701515Y
U401: LM74610QDGKRQ1; SOP65P490X110-8N; PARTREV B

Connections:
/Alimentation/Batt_Interne_Pos: Q401.2 (D), U401.8 (CATHODE); also elsewhere on the board
/Alimentation/Batt_Neg: J401.2, J402.2, R401.1; also elsewhere on the board
/Alimentation/Recharge_Pack/Recharge_DEL_A: D401.2 (A), J402.5, R402.2
/Alimentation/Recharge_Pack/Recharge_Pos: J401.1, J402.1, J402.3, R402.1, TH401.1 (A)
/Alimentation/Recharge_Pack/Recharge_Therm: D401.1 (K), J402.4, J402.6, Q401.3 (S), R401.2, TH401.2 (B), U401.4 (ANODE)
unnamed: Q401.1 (G), U401.2 (GATE_PULL_DOWN), U401.6 (GATE_DRIVE)
unnamed: C401.1, U401.7 (VCAPH)
unnamed: C401.2, U401.1 (VCAPL)
