patricecouillard-code/TrailerDiagnosticSystem/TrailerDiagnosticSystem.kicad_pcb

## KiCad design TrailerDiagnosticSystem.kicad_pcb (continued)

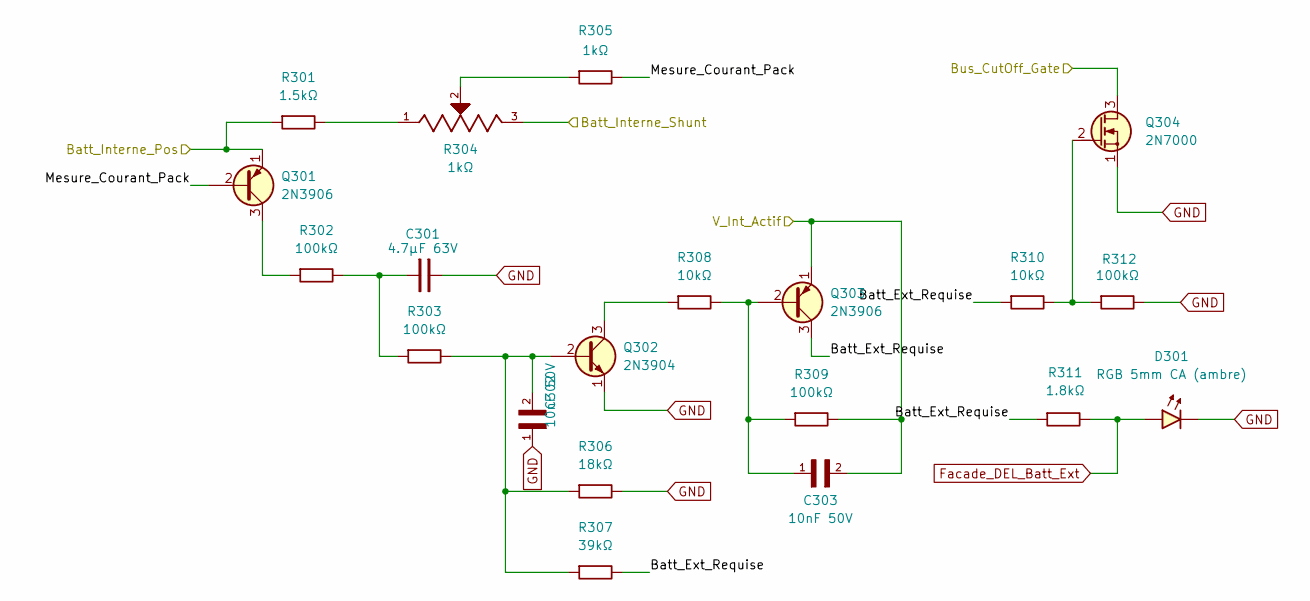
[picture p29: schematic Limite_Pack_Int.kicad_sch]

Parts:
C301: 4.7µF 63V; C_Rect_L19.0mm_W7.0mm_P15.00mm_MKS4; MPN MKS4C044704D00KSSD 10%
C302, C303: 10nF 50V; CAPRR254W50L508T317H508; MPN C315C103K5R5TA
D301: RGB 5mm CA (ambre); LED_D5.0mm-4_RGB_Staggered_Pins; MPN WP154A4SEJ3VBDZGW/CA
Q301, Q303: 2N3906; TO-92_Inline_Wide_EBC
Q302: 2N3904; TO-92_Inline_Wide_EBC
Q304: 2N7000; TO-92_Inline_Wide_SGD
R301: 1.5kΩ; R_Axial_DIN0207_L6.3mm_D2.5mm_P10.16mm_Horizontal
R302, R303, R309, R312: 100kΩ; R_Axial_DIN0207_L6.3mm_D2.5mm_P10.16mm_Horizontal
R304: 1kΩ; TRIM_3296W-1-102LF; MPN 3296W-1-102LF
R305: 1kΩ; R_Axial_DIN0207_L6.3mm_D2.5mm_P10.16mm_Horizontal
R306: 18kΩ; R_Axial_DIN0207_L6.3mm_D2.5mm_P10.16mm_Horizontal
R307: 39kΩ; R_Axial_DIN0207_L6.3mm_D2.5mm_P10.16mm_Horizontal
R308, R310: 10kΩ; R_Axial_DIN0207_L6.3mm_D2.5mm_P10.16mm_Horizontal
R311: 1.8kΩ; R_Axial_DIN0207_L6.3mm_D2.5mm_P10.16mm_Horizontal

Connections:
/Alimentation/Batt_Interne_Pos: Q301.1 (E), R301.1; also elsewhere on the board
/Alimentation/Batt_Interne_Shunt: R304.3; also elsewhere on the board
/Alimentation/Bus_CutOff_Gate: Q304.3 (D); also elsewhere on the board
/Alimentation/Limite_Pack_Int/Batt_Ext_Requise: Q303.3 (C), R307.2, R310.1, R311.1
/Alimentation/Limite_Pack_Int/Mesure_Courant_Pack: Q301.2 (B), R305.2
/Alimentation/V_Int_Actif: C303.2, Q303.1 (E), R309.2; also elsewhere on the board
Facade_DEL_Batt_Ext: D301.2 (A), R311.2; also elsewhere on the board
GND: C301.2, C302.1, D301.1 (K), Q302.1 (E), Q304.1 (S), R306.2, R312.2; also elsewhere on the board
unnamed: C301.1, R302.2, R303.1
unnamed: Q301.3 (C), R302.1
unnamed: C302.2, Q302.2 (B), R303.2, R306.1, R307.1
unnamed: Q302.3 (C), R308.1
unnamed: C303.1, Q303.2 (B), R308.2, R309.1
unnamed: Q304.2 (G), R310.2, R312.1
unnamed: R301.2, R304.1
unnamed: R304.2, R305.1

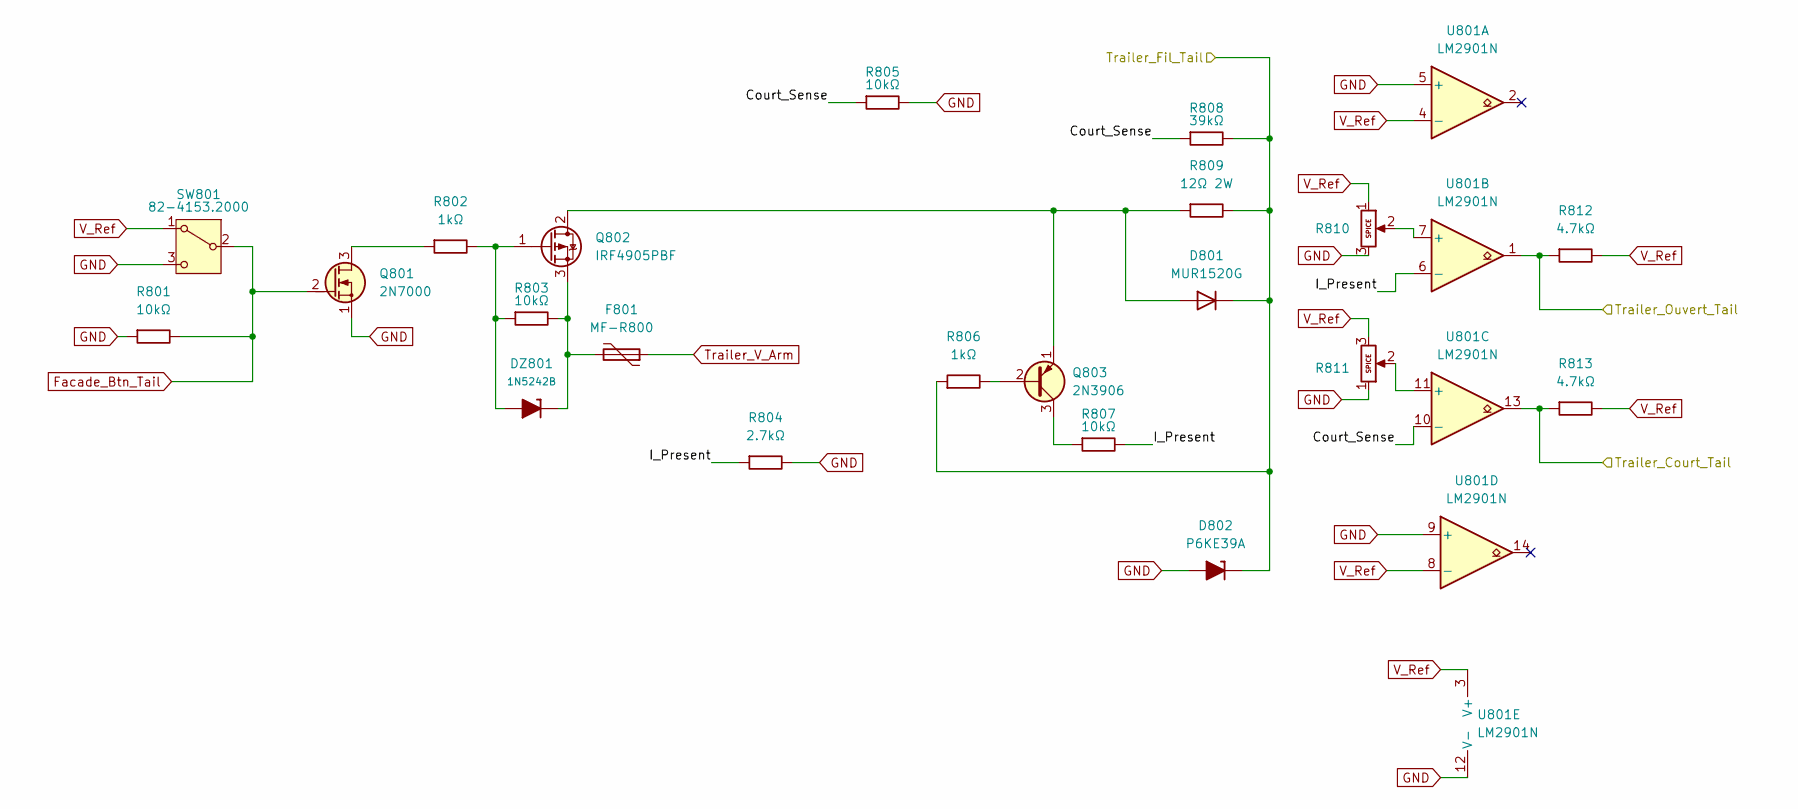
[picture p30: schematic Trailer_Tail.kicad_sch]

Parts:
D801: MUR1520G; TO-220-2_Vertical
D802: P6KE39A; D_DO-15_P10.16mm_Horizontal_Zener
DZ801: 1N5242B; D_DO-35_SOD27_P7.62mm_Horizontal_Zener
F801: MF-R800; PTC_Bourns_MF-R_P10.20mm_W24.2mm
Q801: 2N7000; TO-92_Inline_Wide_SGD
Q802: IRF4905PBF; TO-220-3_Vertical
Q803: 2N3906; TO-92_Inline_Wide_EBC
R801, R803, R805, R807: 10kΩ; R_Axial_DIN0207_L6.3mm_D2.5mm_P10.16mm_Horizontal
R802, R806: 1kΩ; R_Axial_DIN0207_L6.3mm_D2.5mm_P10.16mm_Horizontal
R804: 2.7kΩ; R_Axial_DIN0207_L6.3mm_D2.5mm_P10.16mm_Horizontal
R808: 39kΩ; R_Axial_DIN0207_L6.3mm_D2.5mm_P10.16mm_Horizontal
R809: 12Ω 2W; R_Axial_DIN0414_L11.9mm_D4.5mm_P15.24mm_Horizontal; MPN PR02000201209JR500
R810, R811: 10kΩ; TRIM_3296W1103LF; MPN 3296W-1-103LF
R812, R813: 4.7kΩ; R_Axial_DIN0207_L6.3mm_D2.5mm_P10.16mm_Horizontal
SW801: 82-4153.2000
U801: LM2901N; DIP-14_W7.62mm_Socket

Connections:
/Canal_Tail/Bloc_Test_Tail/Trailer_Court_Tail: R813.1, U801.13; also elsewhere on the board
/Canal_Tail/Bloc_Test_Tail/Trailer_Ouvert_Tail: R812.1, U801.1; also elsewhere on the board
/Canal_Tail/Trailer_Tail/Court_Sense: R805.1, R808.1, U801.10 (-)
/Canal_Tail/Trailer_Tail/I_Present: R804.1, R807.2, U801.6 (-)
/Trailer_Fil_Tail: D801.1 (K), D802.1 (K), R806.1, R808.2, R809.2; also elsewhere on the board
Facade_Btn_Tail: Q801.2 (G), R801.2, SW801.2 (B); also elsewhere on the board
GND: D802.2 (A), Q801.1 (S), R801.1, R804.2, R805.2, R810.3, R811.1, SW801.3 (C), U801.5 (+), U801.9 (+), U801.12 (V-); also elsewhere on the board
unnamed: D801.2 (A), Q802.2 (D), Q803.1 (E), R809.1
unnamed: DZ801.2 (A), Q802.1 (G), R802.2, R803.1
unnamed: DZ801.1 (K), F801.2, Q802.3 (S), R803.2
unnamed: Q801.3 (D), R802.1
unnamed: Q803.2 (B), R806.2
unnamed: Q803.3 (C), R807.1
unnamed: R810.2, U801.7 (+)
unnamed: R811.2, U801.11 (+)
Trailer_V_Arm: F801.1; also elsewhere on the board
V_Ref: R810.1, R811.3, R812.2, R813.2, SW801.1 (A), U801.3 (V+), U801.4 (-), U801.8 (-); also elsewhere on the board

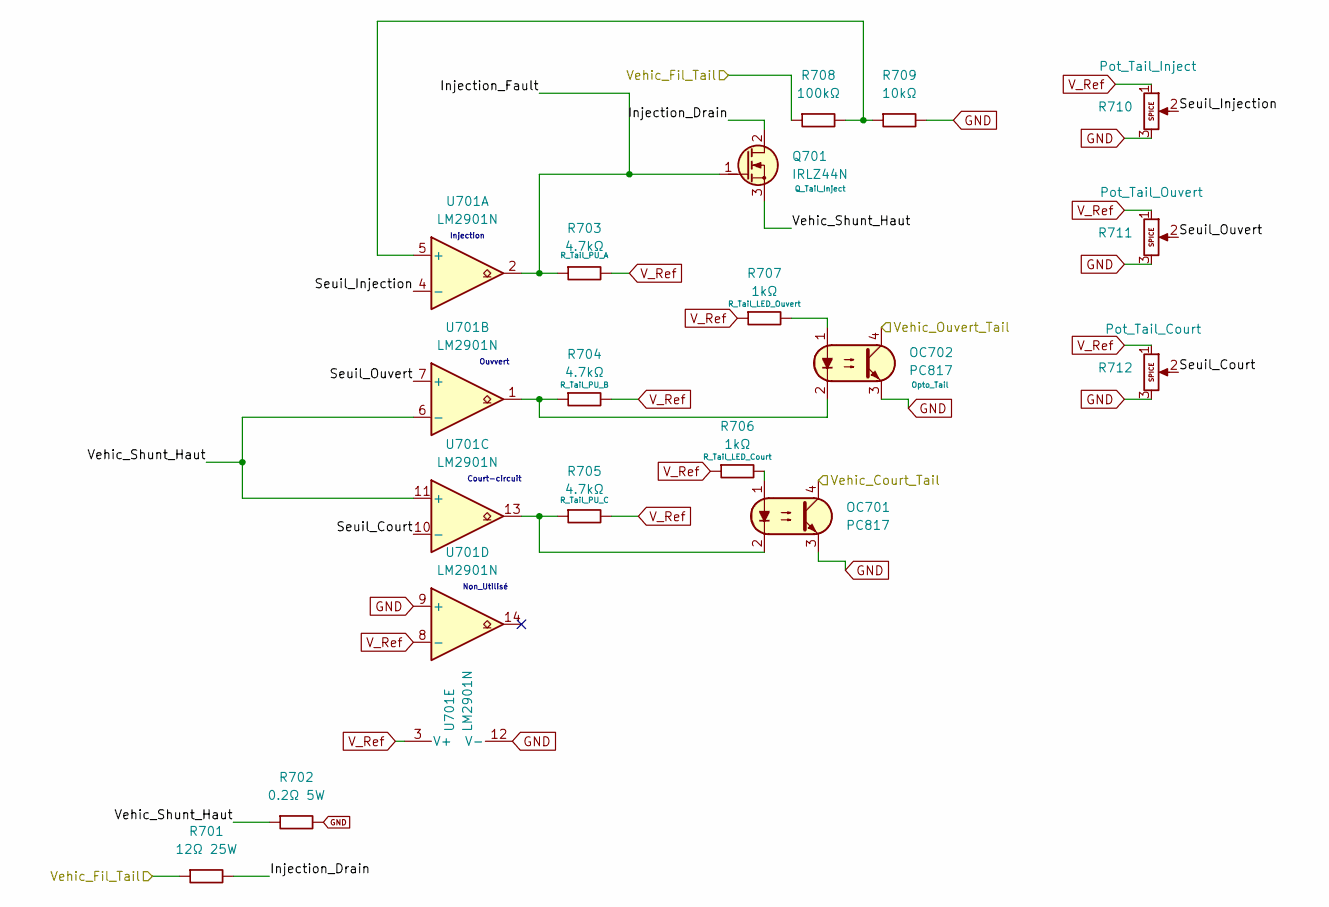
[picture p31: schematic Vehicule_Tail.kicad_sch]

Parts:
OC701, OC702: PC817; DIP-4_W7.62mm_LongPads
Q701: IRLZ44N; TO-220-3_Vertical_GDS
R701: 12Ω 25W; TerminalBlock_Phoenix_PT-1,5-2-3.5-H_1x02_P3.50mm_Horizontal; MPN HSA2512RJ
R702: 0.2Ω 5W; R_Axial_Power_L25.0mm_W9.0mm_P27.94mm; MPN SQP500JB-0R2
R703, R704, R705: 4.7kΩ; R_Axial_DIN0207_L6.3mm_D2.5mm_P10.16mm_Horizontal
R706, R707: 1kΩ; R_Axial_DIN0207_L6.3mm_D2.5mm_P10.16mm_Horizontal
R708: 100kΩ; R_Axial_DIN0207_L6.3mm_D2.5mm_P10.16mm_Horizontal
R709: 10kΩ; R_Axial_DIN0207_L6.3mm_D2.5mm_P10.16mm_Horizontal
R710, R711, R712: 10kΩ; TRIM_3296W1103LF; MPN 3296W-1-103LF
U701: LM2901N; DIP-14_W7.62mm_Socket

Connections:
/Canal_Tail/Bloc_Test_Tail/Vehic_Court_Tail: OC701.4; also elsewhere on the board
/Canal_Tail/Bloc_Test_Tail/Vehic_Ouvert_Tail: OC702.4; also elsewhere on the board
/Canal_Tail/Vehicule_Tail/Injection_Drain: Q701.2 (D), R701.2
/Canal_Tail/Vehicule_Tail/Injection_Fault: Q701.1 (G), R703.1, U701.2
/Canal_Tail/Vehicule_Tail/Seuil_Court: R712.2, U701.10 (-)
/Canal_Tail/Vehicule_Tail/Seuil_Injection: R710.2, U701.4 (-)
/Canal_Tail/Vehicule_Tail/Seuil_Ouvert: R711.2, U701.7 (+)
/Canal_Tail/Vehicule_Tail/Vehic_Shunt_Haut: Q701.3 (S), R702.1, U701.6 (-), U701.11 (+)
/Vehic_Fil_Tail: R701.1, R708.1; also elsewhere on the board
GND: OC701.3, OC702.3, R702.2, R709.2, R710.3, R711.3, R712.3, U701.9 (+), U701.12 (V-); also elsewhere on the board
unnamed: OC701.1, R706.2
unnamed: OC701.2, R705.1, U701.13
unnamed: OC702.1, R707.2
unnamed: OC702.2, R704.1, U701.1
unnamed: R708.2, R709.1, U701.5 (+)
V_Ref: R703.2, R704.2, R705.2, R706.1, R707.1, R710.1, R711.1, R712.1, U701.3 (V+), U701.8 (-); also elsewhere on the board

Notes on the sheet:
Injection
Ouvvert
Court-circuit
Non_Utilisé

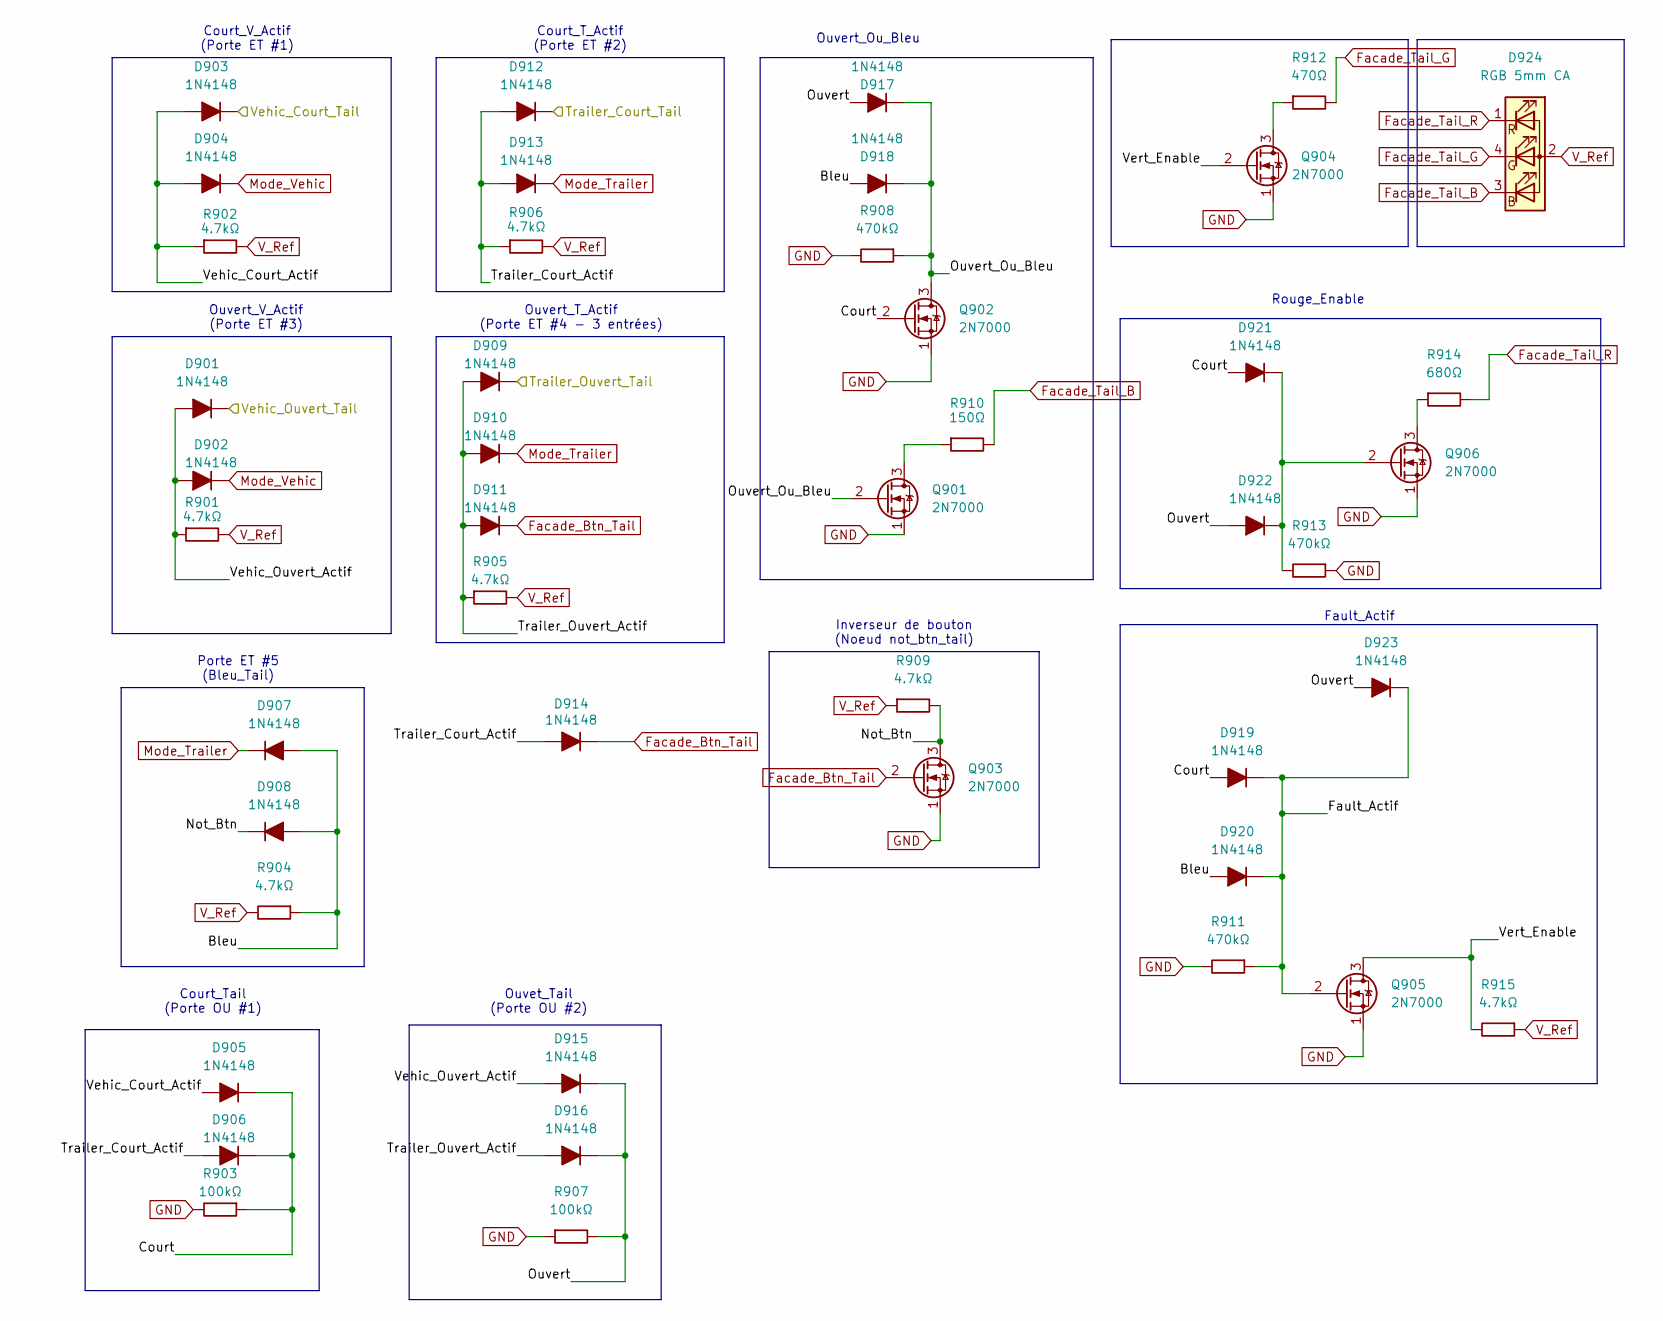
[picture p32: schematic Bloc_Test_Tail.kicad_sch]

Parts:
D901, D902, D903, D904, D905, D906, D907, D908, D909, D910, D911, D912, D913, D914, D915, D916, D917, D918, D919, D920, D921, D922, D923: 1N4148; D_DO-35_SOD27_P7.62mm_Horizontal
D924: RGB 5mm CA; LED_D5.0mm-4_RGB_Staggered_Pins; MPN WP154A4SEJ3VBDZGW/CA
Q901, Q902, Q903, Q904, Q905, Q906: 2N7000; TO-92_Inline_Wide_SGD
R901, R902, R904, R905, R906, R909, R915: 4.7kΩ; R_Axial_DIN0207_L6.3mm_D2.5mm_P10.16mm_Horizontal
R903, R907: 100kΩ; R_Axial_DIN0207_L6.3mm_D2.5mm_P10.16mm_Horizontal
R908, R911, R913: 470kΩ; R_Axial_DIN0207_L6.3mm_D2.5mm_P10.16mm_Horizontal
R910: 150Ω; R_Axial_DIN0207_L6.3mm_D2.5mm_P10.16mm_Horizontal
R912: 470Ω; R_Axial_DIN0207_L6.3mm_D2.5mm_P10.16mm_Horizontal
R914: 680Ω; R_Axial_DIN0207_L6.3mm_D2.5mm_P10.16mm_Horizontal

Connections:
/Canal_Tail/Bloc_Test_Tail/Bleu: D907.2 (A), D908.2 (A), D918.2 (A), D920.2 (A), R904.1
/Canal_Tail/Bloc_Test_Tail/Court: D905.1 (K), D906.1 (K), D919.2 (A), D921.2 (A), Q902.2 (G), R903.1
/Canal_Tail/Bloc_Test_Tail/Fault_Actif: D919.1 (K), D920.1 (K), D923.1 (K), Q905.2 (G), R911.1
/Canal_Tail/Bloc_Test_Tail/Not_Btn: D908.1 (K), Q903.3 (D), R909.2
/Canal_Tail/Bloc_Test_Tail/Ouvert: D915.1 (K), D916.1 (K), D917.2 (A), D922.2 (A), D923.2 (A), R907.2
/Canal_Tail/Bloc_Test_Tail/Ouvert_Ou_Bleu: D917.1 (K), D918.1 (K), Q901.2 (G), Q902.3 (D), R908.1
/Canal_Tail/Bloc_Test_Tail/Trailer_Court_Actif: D906.2 (A), D912.2 (A), D913.2 (A), D914.2 (A), R906.1
/Canal_Tail/Bloc_Test_Tail/Trailer_Court_Tail: D912.1 (K); also elsewhere on the board
/Canal_Tail/Bloc_Test_Tail/Trailer_Ouvert_Actif: D909.2 (A), D910.2 (A), D911.2 (A), D916.2 (A), R905.1
/Canal_Tail/Bloc_Test_Tail/Trailer_Ouvert_Tail: D909.1 (K); also elsewhere on the board
/Canal_Tail/Bloc_Test_Tail/Vehic_Court_Actif: D903.2 (A), D904.2 (A), D905.2 (A), R902.1
/Canal_Tail/Bloc_Test_Tail/Vehic_Court_Tail: D903.1 (K); also elsewhere on the board
/Canal_Tail/Bloc_Test_Tail/Vehic_Ouvert_Actif: D901.2 (A), D902.2 (A), D915.2 (A), R901.1
/Canal_Tail/Bloc_Test_Tail/Vehic_Ouvert_Tail: D901.1 (K); also elsewhere on the board
/Canal_Tail/Bloc_Test_Tail/Vert_Enable: Q904.2 (G), Q905.3 (D), R915.2
Facade_Btn_Tail: D911.1 (K), D914.1 (K), Q903.2 (G); also elsewhere on the board
Facade_Tail_B: D924.3 (BK), R910.2; also elsewhere on the board
Facade_Tail_G: D924.4 (GK), R912.2; also elsewhere on the board
Facade_Tail_R: D924.1 (RK), R914.2; also elsewhere on the board
GND: Q901.1 (S), Q902.1 (S), Q903.1 (S), Q904.1 (S), Q905.1 (S), Q906.1 (S), R903.2, R907.1, R908.2, R911.2, R913.1; also elsewhere on the board
Mode_Trailer: D907.1 (K), D910.1 (K), D913.1 (K); also elsewhere on the board
Mode_Vehic: D902.1 (K), D904.1 (K); also elsewhere on the board
unnamed: D921.1 (K), D922.1 (K), Q906.2 (G), R913.2
unnamed: Q901.3 (D), R910.1
unnamed: Q904.3 (D), R912.1
unnamed: Q906.3 (D), R914.1
V_Ref: D924.2 (A), R901.2, R902.2, R904.2, R905.2, R906.2, R909.1, R915.1; also elsewhere on the board

Notes on the sheet:
Ouvert_V_Actif (Porte ET #3)
Ouvert_Ou_Bleu
Court_T_Actif (Porte ET #2)
Ouvet_Tail (Porte OU #2)
Ouvert_T_Actif (Porte ET #4 - 3 entrées)
Court_Tail (Porte OU #1)
Rouge_Enable
Court_V_Actif (Porte ET #1)
Porte ET #5 (Bleu_Tail)
Inverseur de bouton (Noeud not_btn_tail)
Fault_Actif

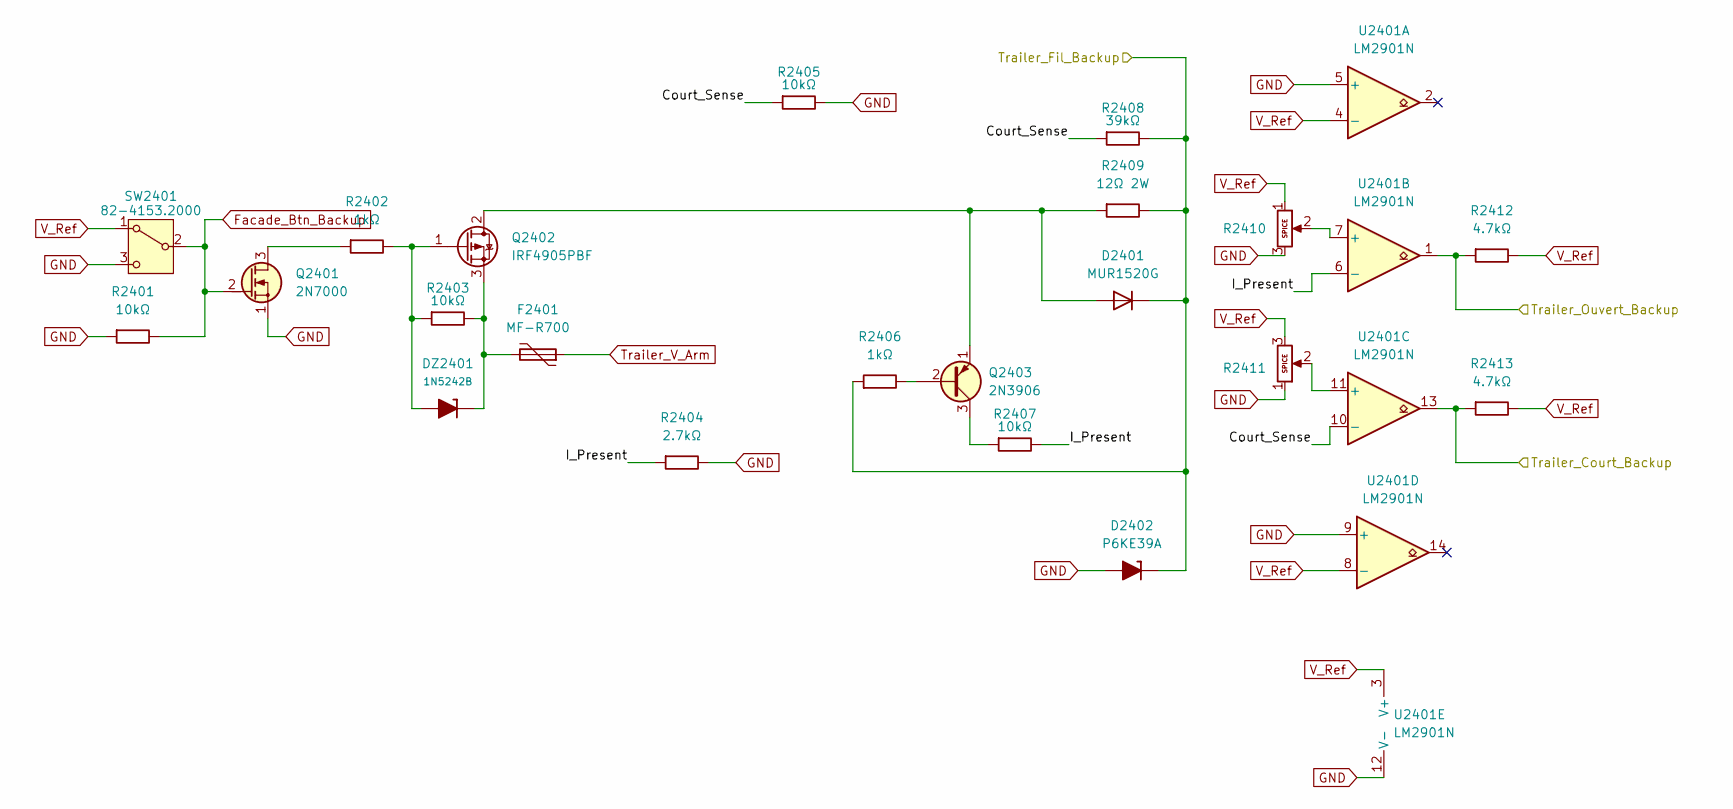
[picture p33: schematic Trailer_Backup.kicad_sch]

Parts:
D2401: MUR1520G; TO-220-2_Vertical
D2402: P6KE39A; D_DO-15_P10.16mm_Horizontal_Zener
DZ2401: 1N5242B; D_DO-35_SOD27_P7.62mm_Horizontal_Zener
F2401: MF-R700; PTC_Bourns_MF-R_P10.20mm_W24.2mm
Q2401: 2N7000; TO-92_Inline_Wide_SGD
Q2402: IRF4905PBF; TO-220-3_Vertical
Q2403: 2N3906; TO-92_Inline_Wide_EBC
R2401, R2403, R2405, R2407: 10kΩ; R_Axial_DIN0207_L6.3mm_D2.5mm_P10.16mm_Horizontal
R2402, R2406: 1kΩ; R_Axial_DIN0207_L6.3mm_D2.5mm_P10.16mm_Horizontal
R2404: 2.7kΩ; R_Axial_DIN0207_L6.3mm_D2.5mm_P10.16mm_Horizontal
R2408: 39kΩ; R_Axial_DIN0207_L6.3mm_D2.5mm_P10.16mm_Horizontal
R2409: 12Ω 2W; R_Axial_DIN0414_L11.9mm_D4.5mm_P15.24mm_Horizontal; MPN PR02000201209JR500
R2410, R2411: 10kΩ; TRIM_3296W1103LF; MPN 3296W-1-103LF
R2412, R2413: 4.7kΩ; R_Axial_DIN0207_L6.3mm_D2.5mm_P10.16mm_Horizontal
SW2401: 82-4153.2000
U2401: LM2901N; DIP-14_W7.62mm_Socket

Connections:
/Canal_Backup/Bloc_Test_Backup/Trailer_Court_Backup: R2413.1, U2401.13; also elsewhere on the board
/Canal_Backup/Bloc_Test_Backup/Trailer_Ouvert_Backup: R2412.1, U2401.1; also elsewhere on the board
/Canal_Backup/Trailer_Backup/Court_Sense: R2405.1, R2408.1, U2401.10 (-)
/Canal_Backup/Trailer_Backup/I_Present: R2404.1, R2407.2, U2401.6 (-)
/Trailer_Fil_Backup: D2401.1 (K), D2402.1 (K), R2406.1, R2408.2, R2409.2; also elsewhere on the board
Facade_Btn_Backup: Q2401.2 (G), R2401.2, SW2401.2 (B); also elsewhere on the board
GND: D2402.2 (A), Q2401.1 (S), R2401.1, R2404.2, R2405.2, R2410.3, R2411.1, SW2401.3 (C), U2401.5 (+), U2401.9 (+), U2401.12 (V-); also elsewhere on the board
unnamed: D2401.2 (A), Q2402.2 (D), Q2403.1 (E), R2409.1
unnamed: DZ2401.2 (A), Q2402.1 (G), R2402.2, R2403.1
unnamed: DZ2401.1 (K), F2401.2, Q2402.3 (S), R2403.2
unnamed: Q2401.3 (D), R2402.1
unnamed: Q2403.2 (B), R2406.2
unnamed: Q2403.3 (C), R2407.1
unnamed: R2410.2, U2401.7 (+)
unnamed: R2411.2, U2401.11 (+)
Trailer_V_Arm: F2401.1; also elsewhere on the board
V_Ref: R2410.1, R2411.3, R2412.2, R2413.2, SW2401.1 (A), U2401.3 (V+), U2401.4 (-), U2401.8 (-); also elsewhere on the board

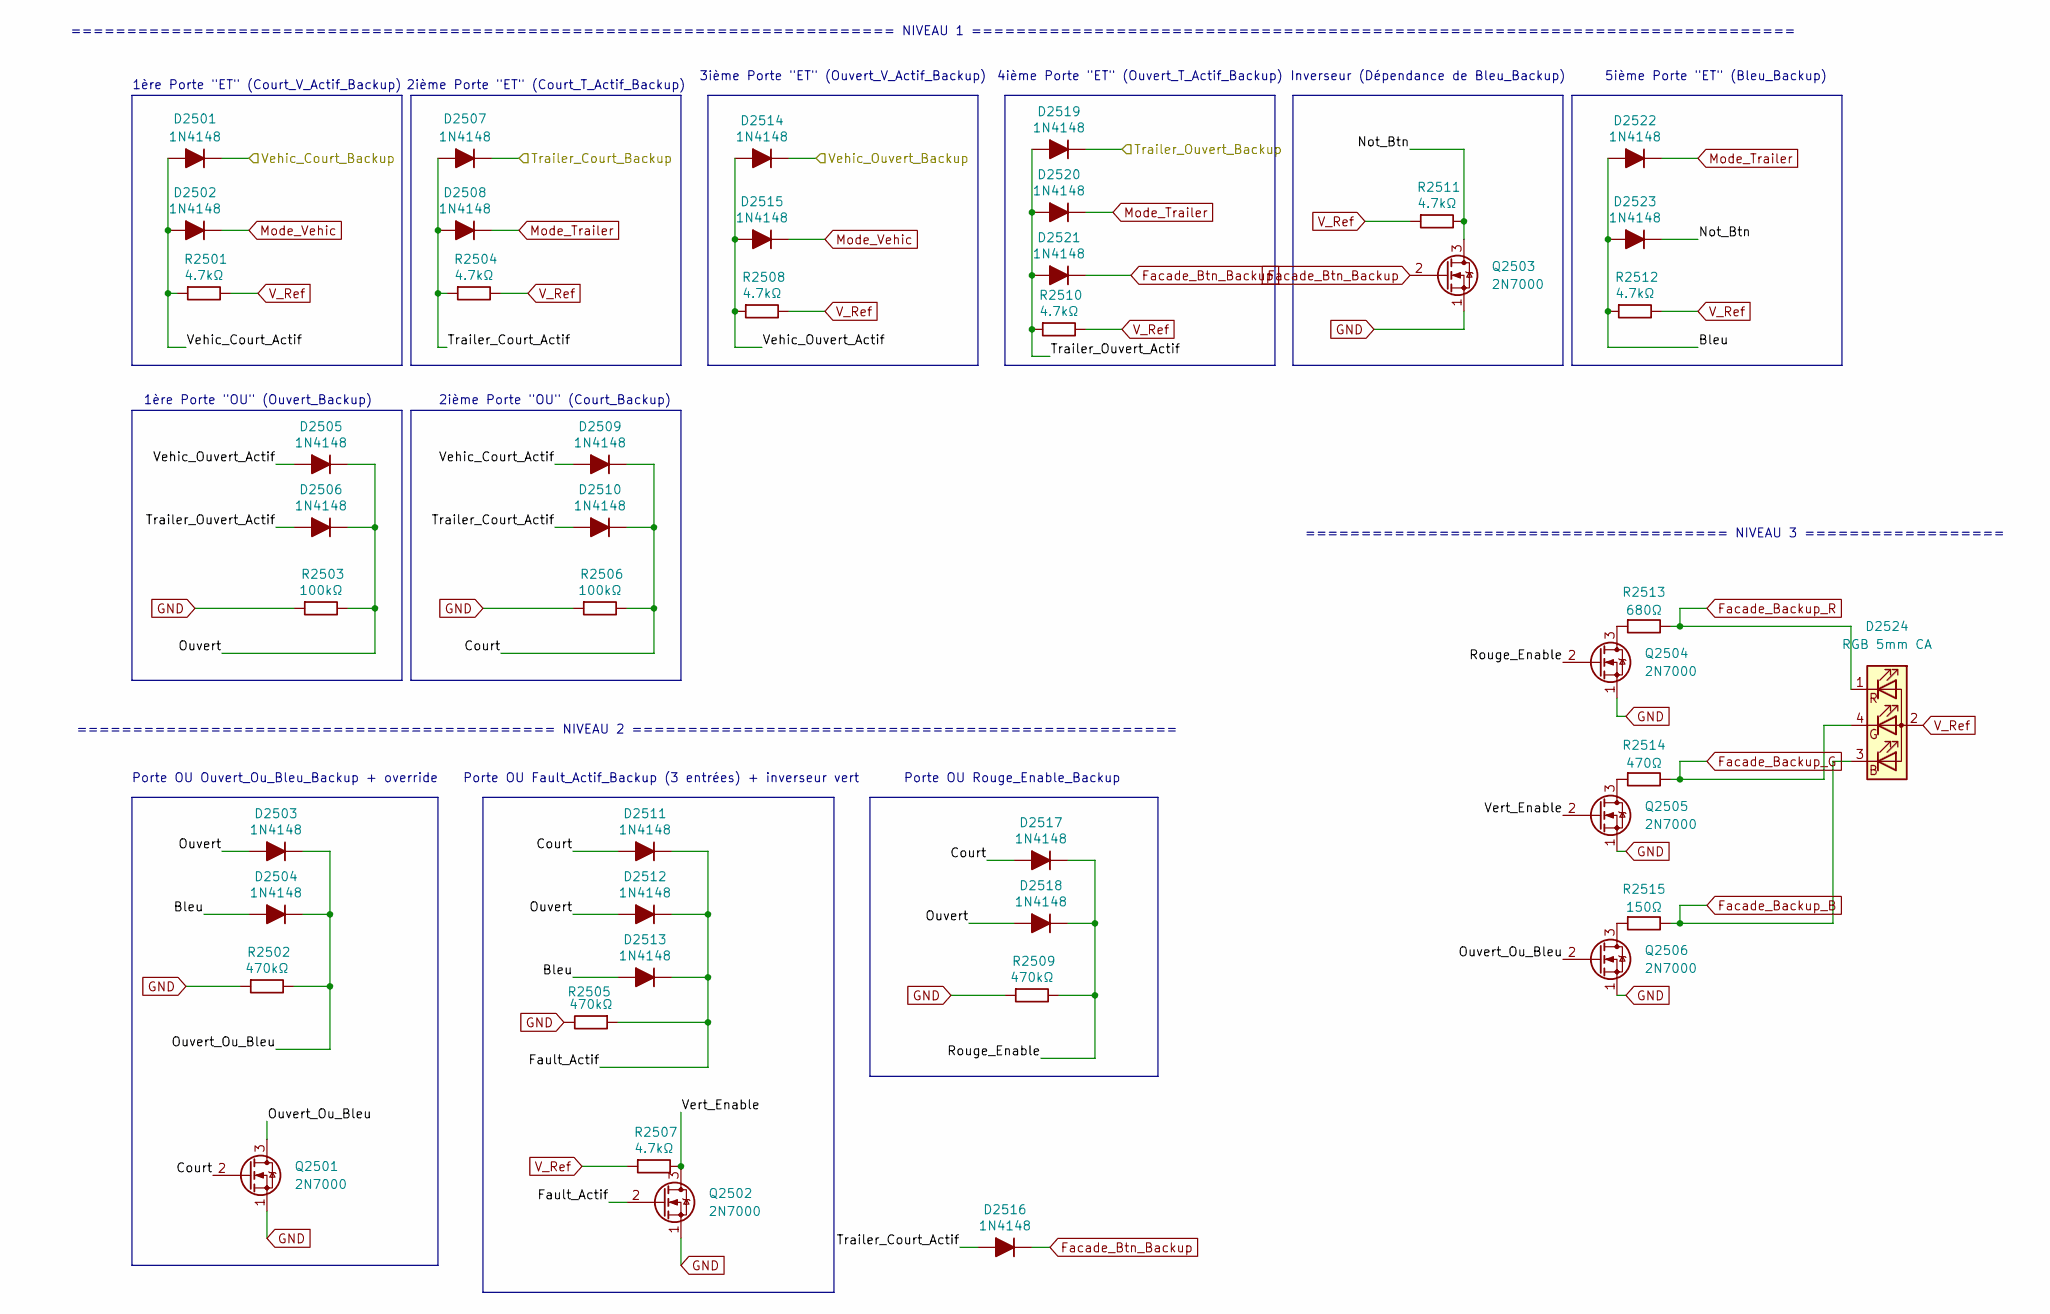
[picture p34: schematic Bloc_Test_Backup.kicad_sch]

Parts:
D2501, D2502, D2503, D2504, D2505, D2506, D2507, D2508, D2509, D2510, D2511, D2512, D2513, D2514, D2515, D2516, D2517, D2518, D2519, D2520, D2521, D2522, D2523: 1N4148; D_DO-35_SOD27_P7.62mm_Horizontal
D2524: RGB 5mm CA; LED_D5.0mm-4_RGB_Staggered_Pins; MPN WP154A4SEJ3VBDZGW/CA
Q2501, Q2502, Q2503, Q2504, Q2505, Q2506: 2N7000; TO-92_Inline_Wide_SGD
R2501, R2504, R2507, R2508, R2510, R2511, R2512: 4.7kΩ; R_Axial_DIN0207_L6.3mm_D2.5mm_P10.16mm_Horizontal
R2502, R2505, R2509: 470kΩ; R_Axial_DIN0207_L6.3mm_D2.5mm_P10.16mm_Horizontal
R2503, R2506: 100kΩ; R_Axial_DIN0207_L6.3mm_D2.5mm_P10.16mm_Horizontal
R2513: 680Ω; R_Axial_DIN0207_L6.3mm_D2.5mm_P10.16mm_Horizontal
R2514: 470Ω; R_Axial_DIN0207_L6.3mm_D2.5mm_P10.16mm_Horizontal
R2515: 150Ω; R_Axial_DIN0207_L6.3mm_D2.5mm_P10.16mm_Horizontal

Connections:
/Canal_Backup/Bloc_Test_Backup/Bleu: D2504.2 (A), D2513.2 (A), D2522.2 (A), D2523.2 (A), R2512.1
/Canal_Backup/Bloc_Test_Backup/Court: D2509.1 (K), D2510.1 (K), D2511.2 (A), D2517.2 (A), Q2501.2 (G), R2506.2
/Canal_Backup/Bloc_Test_Backup/Fault_Actif: D2511.1 (K), D2512.1 (K), D2513.1 (K), Q2502.2 (G), R2505.1
/Canal_Backup/Bloc_Test_Backup/Not_Btn: D2523.1 (K), Q2503.3 (D), R2511.2
/Canal_Backup/Bloc_Test_Backup/Ouvert: D2503.2 (A), D2505.1 (K), D2506.1 (K), D2512.2 (A), D2518.2 (A), R2503.2
/Canal_Backup/Bloc_Test_Backup/Ouvert_Ou_Bleu: D2503.1 (K), D2504.1 (K), Q2501.3 (D), Q2506.2 (G), R2502.2
/Canal_Backup/Bloc_Test_Backup/Rouge_Enable: D2517.1 (K), D2518.1 (K), Q2504.2 (G), R2509.2
/Canal_Backup/Bloc_Test_Backup/Trailer_Court_Actif: D2507.2 (A), D2508.2 (A), D2510.2 (A), D2516.2 (A), R2504.1
/Canal_Backup/Bloc_Test_Backup/Trailer_Court_Backup: D2507.1 (K); also elsewhere on the board
/Canal_Backup/Bloc_Test_Backup/Trailer_Ouvert_Actif: D2506.2 (A), D2519.2 (A), D2520.2 (A), D2521.2 (A), R2510.1
/Canal_Backup/Bloc_Test_Backup/Trailer_Ouvert_Backup: D2519.1 (K); also elsewhere on the board
/Canal_Backup/Bloc_Test_Backup/Vehic_Court_Actif: D2501.2 (A), D2502.2 (A), D2509.2 (A), R2501.1
/Canal_Backup/Bloc_Test_Backup/Vehic_Court_Backup: D2501.1 (K); also elsewhere on the board
/Canal_Backup/Bloc_Test_Backup/Vehic_Ouvert_Actif: D2505.2 (A), D2514.2 (A), D2515.2 (A), R2508.1
/Canal_Backup/Bloc_Test_Backup/Vehic_Ouvert_Backup: D2514.1 (K); also elsewhere on the board
/Canal_Backup/Bloc_Test_Backup/Vert_Enable: Q2502.3 (D), Q2505.2 (G), R2507.2
Facade_Backup_B: D2524.3 (BK), R2515.2; also elsewhere on the board
Facade_Backup_G: D2524.4 (GK), R2514.2; also elsewhere on the board
Facade_Backup_R: D2524.1 (RK), R2513.2; also elsewhere on the board
Facade_Btn_Backup: D2516.1 (K), D2521.1 (K), Q2503.2 (G); also elsewhere on the board
GND: Q2501.1 (S), Q2502.1 (S), Q2503.1 (S), Q2504.1 (S), Q2505.1 (S), Q2506.1 (S), R2502.1, R2503.1, R2505.2, R2506.1, R2509.1; also elsewhere on the board
Mode_Trailer: D2508.1 (K), D2520.1 (K), D2522.1 (K); also elsewhere on the board
Mode_Vehic: D2502.1 (K), D2515.1 (K); also elsewhere on the board
unnamed: Q2504.3 (D), R2513.1
unnamed: Q2505.3 (D), R2514.1
unnamed: Q2506.3 (D), R2515.1
V_Ref: D2524.2 (A), R2501.2, R2504.2, R2507.1, R2508.2, R2510.2, R2511.1, R2512.2; also elsewhere on the board

Notes on the sheet:
========================================================================== NIVEAU 1 ==========================================================================
Inverseur (Dépendance de Bleu_Backup)
====================================== NIVEAU 3 ==================
2ième Porte "OU" (Court_Backup)
Porte OU Ouvert_Ou_Bleu_Backup + override
Porte OU Fault_Actif_Backup (3 entrées) + inverseur vert
1ère Porte "ET" (Court_V_Actif_Backup)
Porte OU Rouge_Enable_Backup
3ième Porte "ET" (Ouvert_V_Actif_Backup)
4ième Porte "ET" (Ouvert_T_Actif_Backup)
5ième Porte "ET" (Bleu_Backup)
1ère Porte "OU" (Ouvert_Backup)
=========================================== NIVEAU 2 =================================================
2ième Porte "ET" (Court_T_Actif_Backup)

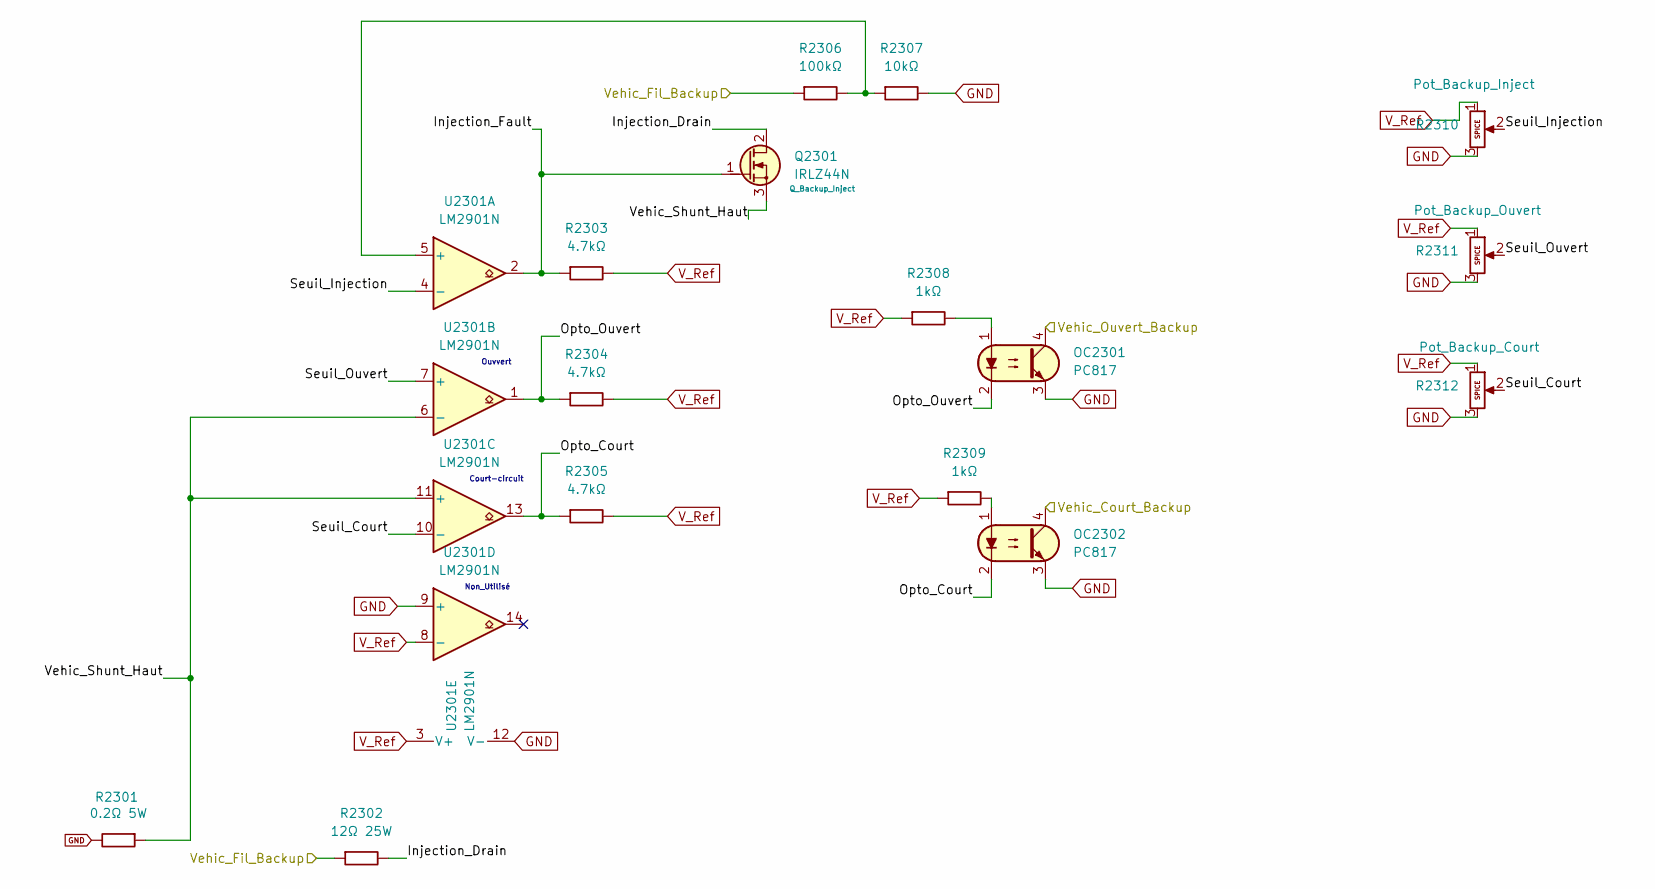
[picture p35: schematic Vehicule_Backup.kicad_sch]

Parts:
OC2301, OC2302: PC817; DIP-4_W7.62mm_LongPads
Q2301: IRLZ44N; TO-220-3_Vertical_GDS
R2301: 0.2Ω 5W; R_Axial_Power_L25.0mm_W9.0mm_P27.94mm; MPN SQP500JB-0R2
R2302: 12Ω 25W; TerminalBlock_Phoenix_PT-1,5-2-3.5-H_1x02_P3.50mm_Horizontal; MPN HSA2512RJ
R2303, R2304, R2305: 4.7kΩ; R_Axial_DIN0207_L6.3mm_D2.5mm_P10.16mm_Horizontal
R2306: 100kΩ; R_Axial_DIN0207_L6.3mm_D2.5mm_P10.16mm_Horizontal
R2307: 10kΩ; R_Axial_DIN0207_L6.3mm_D2.5mm_P10.16mm_Horizontal
R2308, R2309: 1kΩ; R_Axial_DIN0207_L6.3mm_D2.5mm_P10.16mm_Horizontal
R2310, R2311, R2312: 10kΩ; TRIM_3296W1103LF; MPN 3296W-1-103LF
U2301: LM2901N; DIP-14_W7.62mm_Socket

Connections:
/Canal_Backup/Bloc_Test_Backup/Vehic_Court_Backup: OC2302.4; also elsewhere on the board
/Canal_Backup/Bloc_Test_Backup/Vehic_Ouvert_Backup: OC2301.4; also elsewhere on the board
/Canal_Backup/Vehicule_Backup/Injection_Drain: Q2301.2 (D), R2302.2
/Canal_Backup/Vehicule_Backup/Injection_Fault: Q2301.1 (G), R2303.1, U2301.2
/Canal_Backup/Vehicule_Backup/Opto_Court: OC2302.2, R2305.1, U2301.13
/Canal_Backup/Vehicule_Backup/Opto_Ouvert: OC2301.2, R2304.1, U2301.1
/Canal_Backup/Vehicule_Backup/Seuil_Court: R2312.2, U2301.10 (-)
/Canal_Backup/Vehicule_Backup/Seuil_Injection: R2310.2, U2301.4 (-)
/Canal_Backup/Vehicule_Backup/Seuil_Ouvert: R2311.2, U2301.7 (+)
/Canal_Backup/Vehicule_Backup/Vehic_Shunt_Haut: Q2301.3 (S), R2301.1, U2301.6 (-), U2301.11 (+)
/Vehic_Fil_Backup: R2302.1, R2306.1; also elsewhere on the board
GND: OC2301.3, OC2302.3, R2301.2, R2307.2, R2310.3, R2311.3, R2312.3, U2301.9 (+), U2301.12 (V-); also elsewhere on the board
unnamed: OC2301.1, R2308.2
unnamed: OC2302.1, R2309.2
unnamed: R2306.2, R2307.1, U2301.5 (+)
V_Ref: R2303.2, R2304.2, R2305.2, R2308.1, R2309.1, R2310.1, R2311.1, R2312.1, U2301.3 (V+), U2301.8 (-); also elsewhere on the board

Notes on the sheet:
Non_Utilisé
Ouvvert
Court-circuit
