patricecouillard-code/TrailerDiagnosticSystem/TrailerDiagnosticSystem.kicad_pcb

## KiCad design TrailerDiagnosticSystem.kicad_pcb (continued)

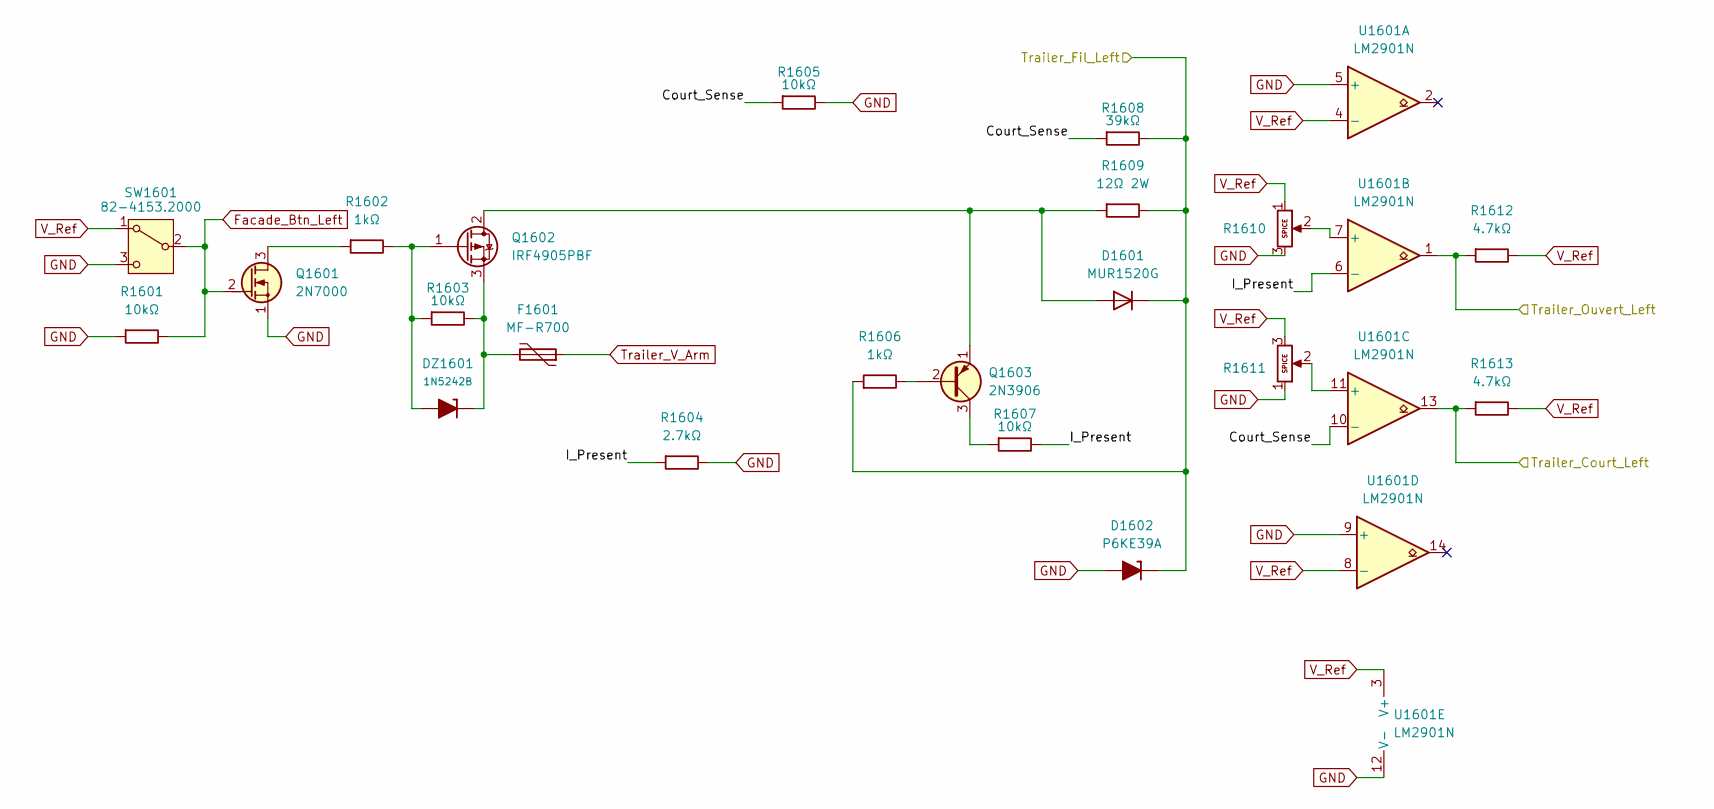
[picture p36: schematic Trailer_Left.kicad_sch]

Parts:
D1601: MUR1520G; TO-220-2_Vertical
D1602: P6KE39A; D_DO-15_P10.16mm_Horizontal_Zener
DZ1601: 1N5242B; D_DO-35_SOD27_P7.62mm_Horizontal_Zener
F1601: MF-R700; PTC_Bourns_MF-R_P10.20mm_W24.2mm
Q1601: 2N7000; TO-92_Inline_Wide_SGD
Q1602: IRF4905PBF; TO-220-3_Vertical
Q1603: 2N3906; TO-92_Inline_Wide_EBC
R1601, R1603, R1605, R1607: 10kΩ; R_Axial_DIN0207_L6.3mm_D2.5mm_P10.16mm_Horizontal
R1602, R1606: 1kΩ; R_Axial_DIN0207_L6.3mm_D2.5mm_P10.16mm_Horizontal
R1604: 2.7kΩ; R_Axial_DIN0207_L6.3mm_D2.5mm_P10.16mm_Horizontal
R1608: 39kΩ; R_Axial_DIN0207_L6.3mm_D2.5mm_P10.16mm_Horizontal
R1609: 12Ω 2W; R_Axial_DIN0414_L11.9mm_D4.5mm_P15.24mm_Horizontal; MPN PR02000201209JR500
R1610, R1611: 10kΩ; TRIM_3296W1103LF; MPN 3296W-1-103LF
R1612, R1613: 4.7kΩ; R_Axial_DIN0207_L6.3mm_D2.5mm_P10.16mm_Horizontal
SW1601: 82-4153.2000
U1601: LM2901N; DIP-14_W7.62mm_Socket

Connections:
/Canal_Left/Bloc_Test_Left/Trailer_Court_Left: R1613.1, U1601.13; also elsewhere on the board
/Canal_Left/Bloc_Test_Left/Trailer_Ouvert_Left: R1612.1, U1601.1; also elsewhere on the board
/Canal_Left/Trailer_Left/Court_Sense: R1605.1, R1608.1, U1601.10 (-)
/Canal_Left/Trailer_Left/I_Present: R1604.1, R1607.2, U1601.6 (-)
/Trailer_Fil_Left: D1601.1 (K), D1602.1 (K), R1606.1, R1608.2, R1609.2; also elsewhere on the board
Facade_Btn_Left: Q1601.2 (G), R1601.2, SW1601.2 (B); also elsewhere on the board
GND: D1602.2 (A), Q1601.1 (S), R1601.1, R1604.2, R1605.2, R1610.3, R1611.1, SW1601.3 (C), U1601.5 (+), U1601.9 (+), U1601.12 (V-); also elsewhere on the board
unnamed: D1601.2 (A), Q1602.2 (D), Q1603.1 (E), R1609.1
unnamed: DZ1601.2 (A), Q1602.1 (G), R1602.2, R1603.1
unnamed: DZ1601.1 (K), F1601.2, Q1602.3 (S), R1603.2
unnamed: Q1601.3 (D), R1602.1
unnamed: Q1603.2 (B), R1606.2
unnamed: Q1603.3 (C), R1607.1
unnamed: R1610.2, U1601.7 (+)
unnamed: R1611.2, U1601.11 (+)
Trailer_V_Arm: F1601.1; also elsewhere on the board
V_Ref: R1610.1, R1611.3, R1612.2, R1613.2, SW1601.1 (A), U1601.3 (V+), U1601.4 (-), U1601.8 (-); also elsewhere on the board

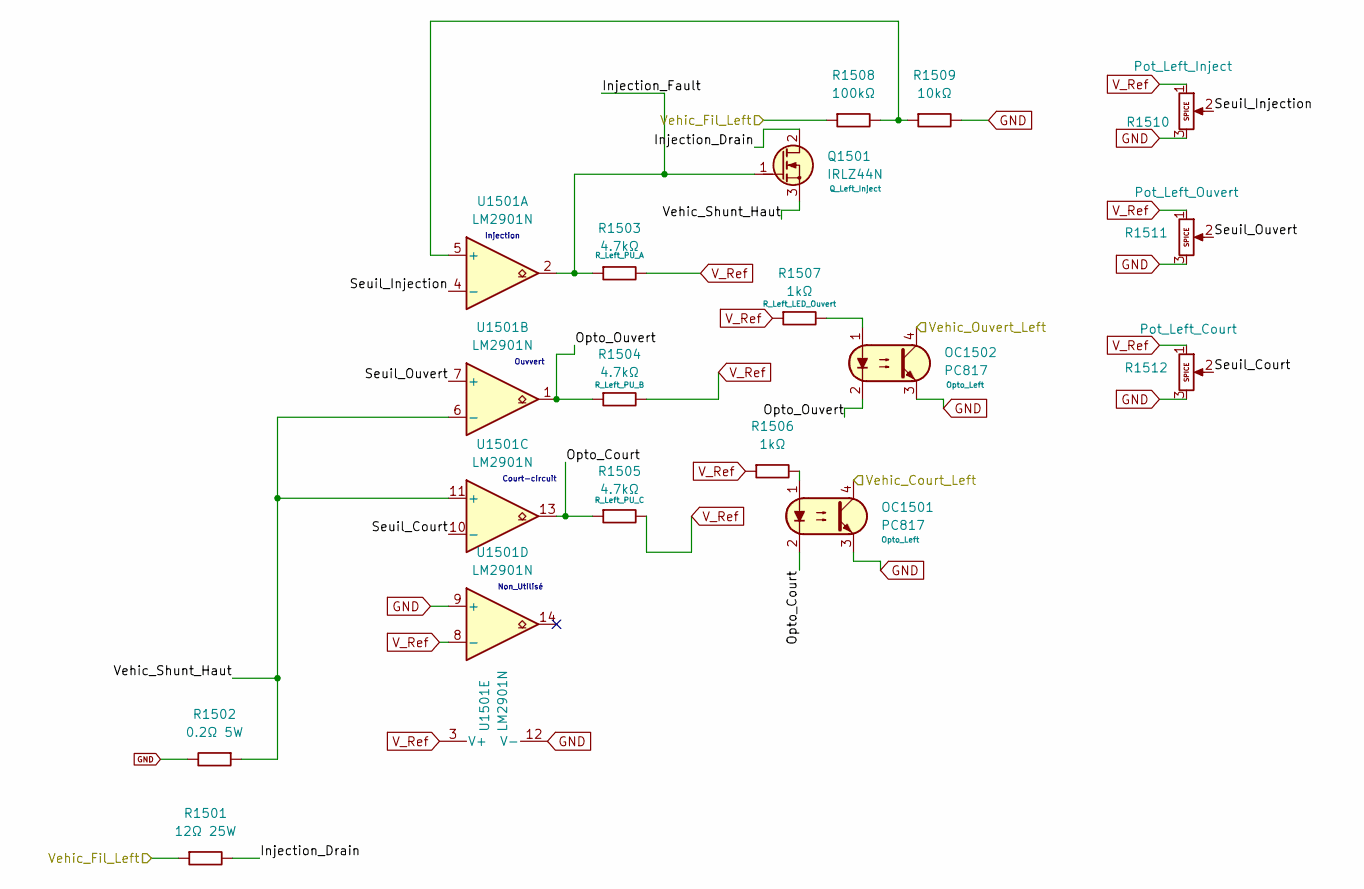
[picture p37: schematic Vehicule_Left.kicad_sch]

Parts:
OC1501, OC1502: PC817; DIP-4_W7.62mm_LongPads
Q1501: IRLZ44N; TO-220-3_Vertical_GDS
R1501: 12Ω 25W; TerminalBlock_Phoenix_PT-1,5-2-3.5-H_1x02_P3.50mm_Horizontal; MPN HSA2512RJ
R1502: 0.2Ω 5W; R_Axial_Power_L25.0mm_W9.0mm_P27.94mm; MPN SQP500JB-0R2
R1503, R1504, R1505: 4.7kΩ; R_Axial_DIN0207_L6.3mm_D2.5mm_P10.16mm_Horizontal
R1506, R1507: 1kΩ; R_Axial_DIN0207_L6.3mm_D2.5mm_P10.16mm_Horizontal
R1508: 100kΩ; R_Axial_DIN0207_L6.3mm_D2.5mm_P10.16mm_Horizontal
R1509: 10kΩ; R_Axial_DIN0207_L6.3mm_D2.5mm_P10.16mm_Horizontal
R1510, R1511, R1512: 10kΩ; TRIM_3296W1103LF; MPN 3296W-1-103LF
U1501: LM2901N; DIP-14_W7.62mm_Socket

Connections:
/Canal_Left/Bloc_Test_Left/Vehic_Court_Left: OC1501.4; also elsewhere on the board
/Canal_Left/Bloc_Test_Left/Vehic_Ouvert_Left: OC1502.4; also elsewhere on the board
/Canal_Left/Vehicule_Left/Injection_Drain: Q1501.2 (D), R1501.2
/Canal_Left/Vehicule_Left/Injection_Fault: Q1501.1 (G), R1503.1, U1501.2
/Canal_Left/Vehicule_Left/Opto_Court: OC1501.2, R1505.1, U1501.13
/Canal_Left/Vehicule_Left/Opto_Ouvert: OC1502.2, R1504.1, U1501.1
/Canal_Left/Vehicule_Left/Seuil_Court: R1512.2, U1501.10 (-)
/Canal_Left/Vehicule_Left/Seuil_Injection: R1510.2, U1501.4 (-)
/Canal_Left/Vehicule_Left/Seuil_Ouvert: R1511.2, U1501.7 (+)
/Canal_Left/Vehicule_Left/Vehic_Shunt_Haut: Q1501.3 (S), R1502.1, U1501.6 (-), U1501.11 (+)
/Vehic_Fil_Left: R1501.1, R1508.1; also elsewhere on the board
GND: OC1501.3, OC1502.3, R1502.2, R1509.2, R1510.3, R1511.3, R1512.3, U1501.9 (+), U1501.12 (V-); also elsewhere on the board
unnamed: OC1501.1, R1506.2
unnamed: OC1502.1, R1507.2
unnamed: R1508.2, R1509.1, U1501.5 (+)
V_Ref: R1503.2, R1504.2, R1505.2, R1506.1, R1507.1, R1510.1, R1511.1, R1512.1, U1501.3 (V+), U1501.8 (-); also elsewhere on the board

Notes on the sheet:
Injection
Ouvvert
Non_Utilisé
Court-circuit

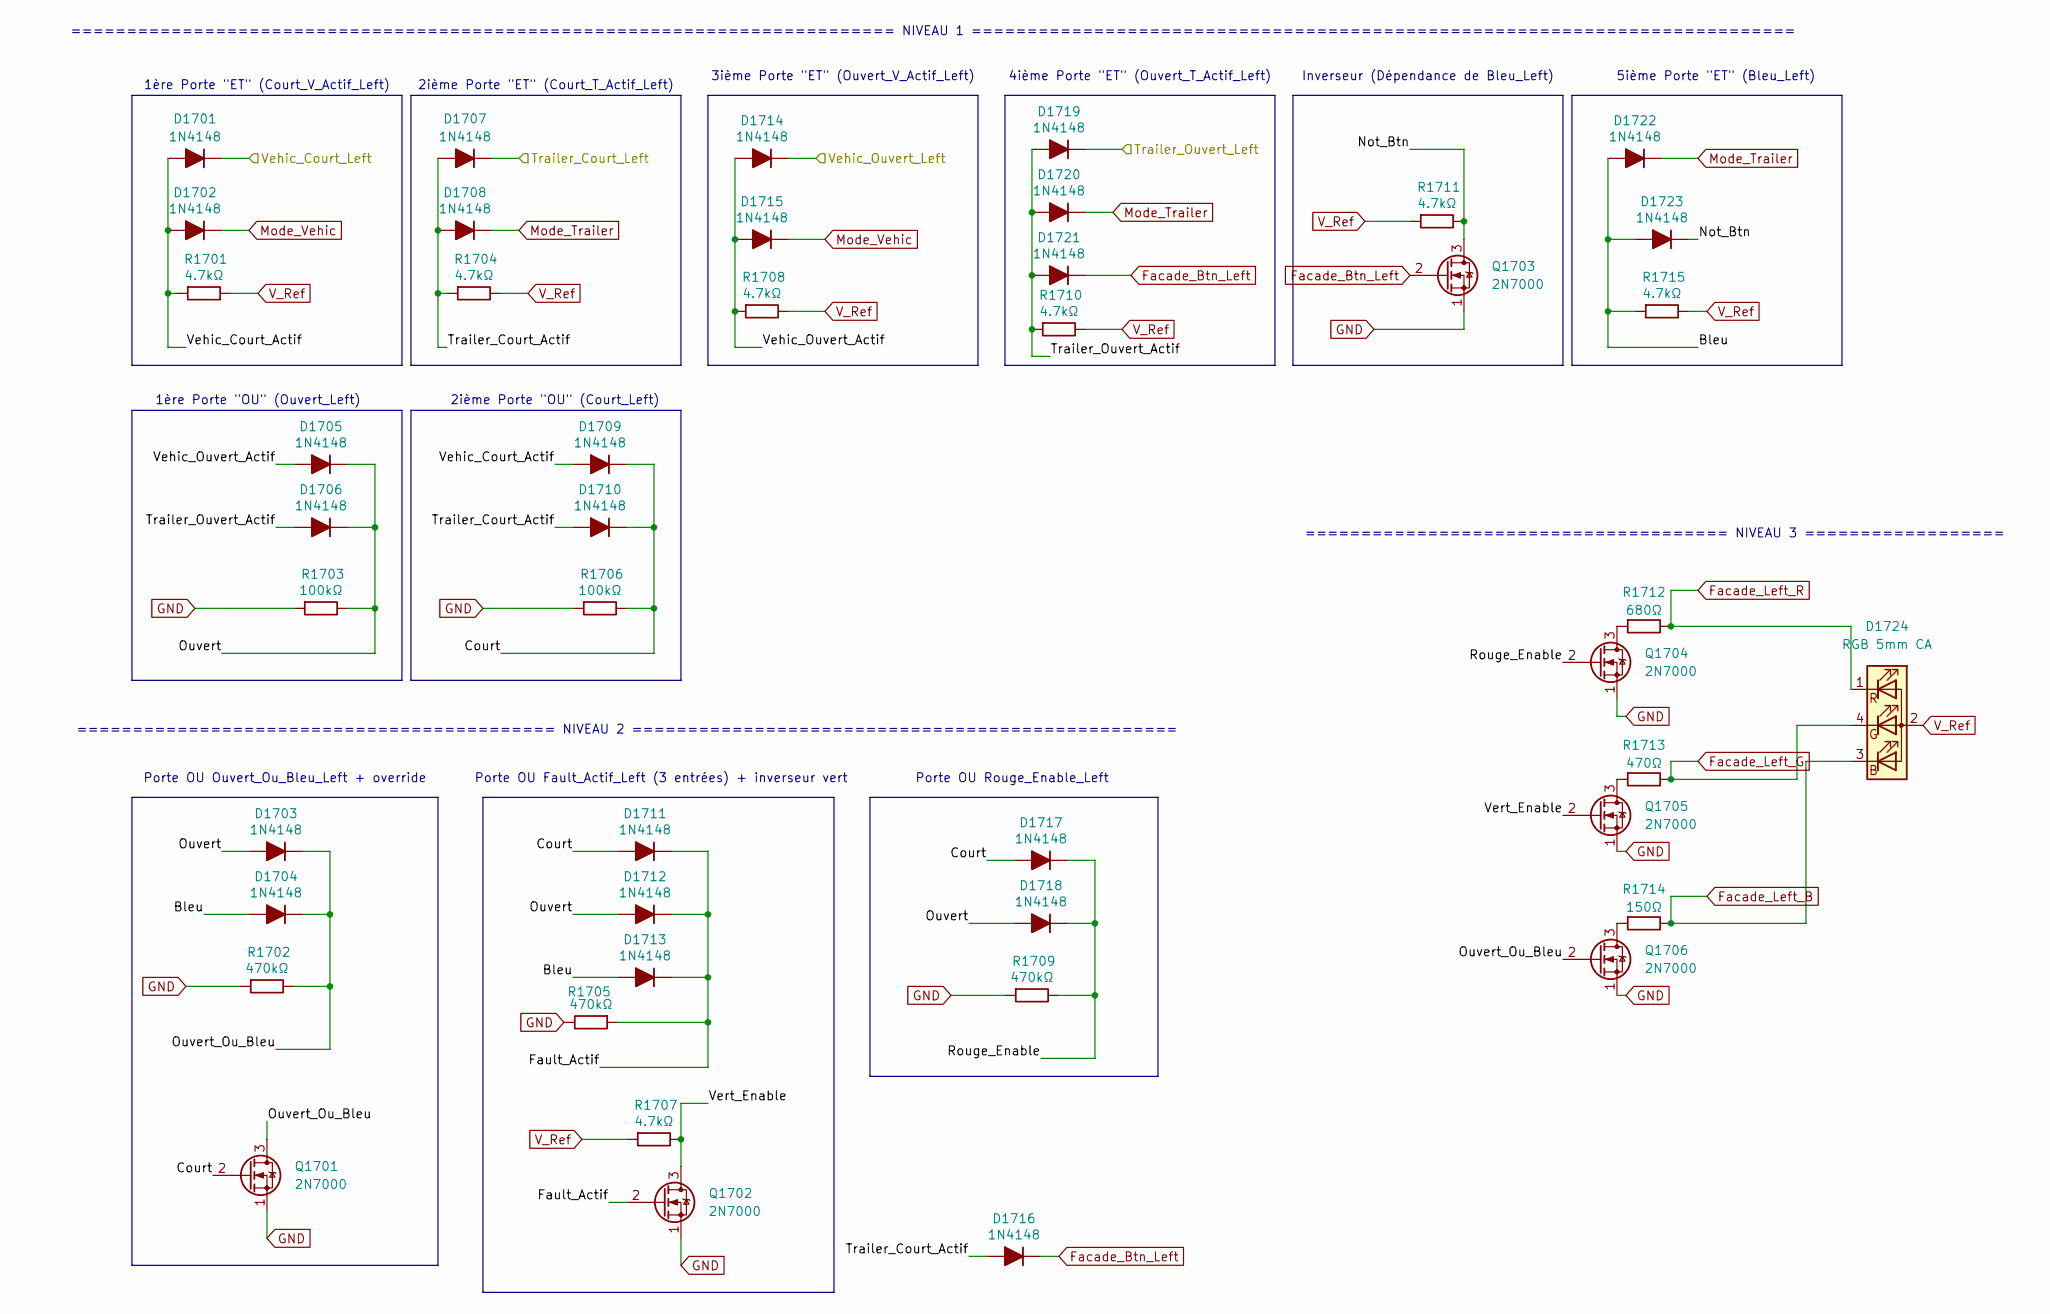
[picture p38: schematic Bloc_Test_Left.kicad_sch]

Parts:
D1701, D1702, D1703, D1704, D1705, D1706, D1707, D1708, D1709, D1710, D1711, D1712, D1713, D1714, D1715, D1716, D1717, D1718, D1719, D1720, D1721, D1722, D1723: 1N4148; D_DO-35_SOD27_P7.62mm_Horizontal
D1724: RGB 5mm CA; LED_D5.0mm-4_RGB_Staggered_Pins; MPN WP154A4SEJ3VBDZGW/CA
Q1701, Q1702, Q1703, Q1704, Q1705, Q1706: 2N7000; TO-92_Inline_Wide_SGD
R1701, R1704, R1707, R1708, R1710, R1711, R1715: 4.7kΩ; R_Axial_DIN0207_L6.3mm_D2.5mm_P10.16mm_Horizontal
R1702, R1705, R1709: 470kΩ; R_Axial_DIN0207_L6.3mm_D2.5mm_P10.16mm_Horizontal
R1703, R1706: 100kΩ; R_Axial_DIN0207_L6.3mm_D2.5mm_P10.16mm_Horizontal
R1712: 680Ω; R_Axial_DIN0207_L6.3mm_D2.5mm_P10.16mm_Horizontal
R1713: 470Ω; R_Axial_DIN0207_L6.3mm_D2.5mm_P10.16mm_Horizontal
R1714: 150Ω; R_Axial_DIN0207_L6.3mm_D2.5mm_P10.16mm_Horizontal

Connections:
/Canal_Left/Bloc_Test_Left/Bleu: D1704.2 (A), D1713.2 (A), D1722.2 (A), D1723.2 (A), R1715.1
/Canal_Left/Bloc_Test_Left/Court: D1709.1 (K), D1710.1 (K), D1711.2 (A), D1717.2 (A), Q1701.2 (G), R1706.2
/Canal_Left/Bloc_Test_Left/Fault_Actif: D1711.1 (K), D1712.1 (K), D1713.1 (K), Q1702.2 (G), R1705.1
/Canal_Left/Bloc_Test_Left/Not_Btn: D1723.1 (K), Q1703.3 (D), R1711.2
/Canal_Left/Bloc_Test_Left/Ouvert: D1703.2 (A), D1705.1 (K), D1706.1 (K), D1712.2 (A), D1718.2 (A), R1703.2
/Canal_Left/Bloc_Test_Left/Ouvert_Ou_Bleu: D1703.1 (K), D1704.1 (K), Q1701.3 (D), Q1706.2 (G), R1702.2
/Canal_Left/Bloc_Test_Left/Rouge_Enable: D1717.1 (K), D1718.1 (K), Q1704.2 (G), R1709.2
/Canal_Left/Bloc_Test_Left/Trailer_Court_Actif: D1707.2 (A), D1708.2 (A), D1710.2 (A), D1716.2 (A), R1704.1
/Canal_Left/Bloc_Test_Left/Trailer_Court_Left: D1707.1 (K); also elsewhere on the board
/Canal_Left/Bloc_Test_Left/Trailer_Ouvert_Actif: D1706.2 (A), D1719.2 (A), D1720.2 (A), D1721.2 (A), R1710.1
/Canal_Left/Bloc_Test_Left/Trailer_Ouvert_Left: D1719.1 (K); also elsewhere on the board
/Canal_Left/Bloc_Test_Left/Vehic_Court_Actif: D1701.2 (A), D1702.2 (A), D1709.2 (A), R1701.1
/Canal_Left/Bloc_Test_Left/Vehic_Court_Left: D1701.1 (K); also elsewhere on the board
/Canal_Left/Bloc_Test_Left/Vehic_Ouvert_Actif: D1705.2 (A), D1714.2 (A), D1715.2 (A), R1708.1
/Canal_Left/Bloc_Test_Left/Vehic_Ouvert_Left: D1714.1 (K); also elsewhere on the board
/Canal_Left/Bloc_Test_Left/Vert_Enable: Q1702.3 (D), Q1705.2 (G), R1707.2
Facade_Btn_Left: D1716.1 (K), D1721.1 (K), Q1703.2 (G); also elsewhere on the board
Facade_Left_B: D1724.3 (BK), R1714.2; also elsewhere on the board
Facade_Left_G: D1724.4 (GK), R1713.2; also elsewhere on the board
Facade_Left_R: D1724.1 (RK), R1712.2; also elsewhere on the board
GND: Q1701.1 (S), Q1702.1 (S), Q1703.1 (S), Q1704.1 (S), Q1705.1 (S), Q1706.1 (S), R1702.1, R1703.1, R1705.2, R1706.1, R1709.1; also elsewhere on the board
Mode_Trailer: D1708.1 (K), D1720.1 (K), D1722.1 (K); also elsewhere on the board
Mode_Vehic: D1702.1 (K), D1715.1 (K); also elsewhere on the board
unnamed: Q1704.3 (D), R1712.1
unnamed: Q1705.3 (D), R1713.1
unnamed: Q1706.3 (D), R1714.1
V_Ref: D1724.2 (A), R1701.2, R1704.2, R1707.1, R1708.2, R1710.2, R1711.1, R1715.2; also elsewhere on the board

Notes on the sheet:
====================================== NIVEAU 3 ==================
3ième Porte "ET" (Ouvert_V_Actif_Left)
Porte OU Fault_Actif_Left (3 entrées) + inverseur vert
5ième Porte "ET" (Bleu_Left)
Porte OU Rouge_Enable_Left
Porte OU Ouvert_Ou_Bleu_Left + override
2ième Porte "ET" (Court_T_Actif_Left)
========================================================================== NIVEAU 1 ==========================================================================
Inverseur (Dépendance de Bleu_Left)
=========================================== NIVEAU 2 =================================================
1ère Porte "ET" (Court_V_Actif_Left)
2ième Porte "OU" (Court_Left)
4ième Porte "ET" (Ouvert_T_Actif_Left)
1ère Porte "OU" (Ouvert_Left)

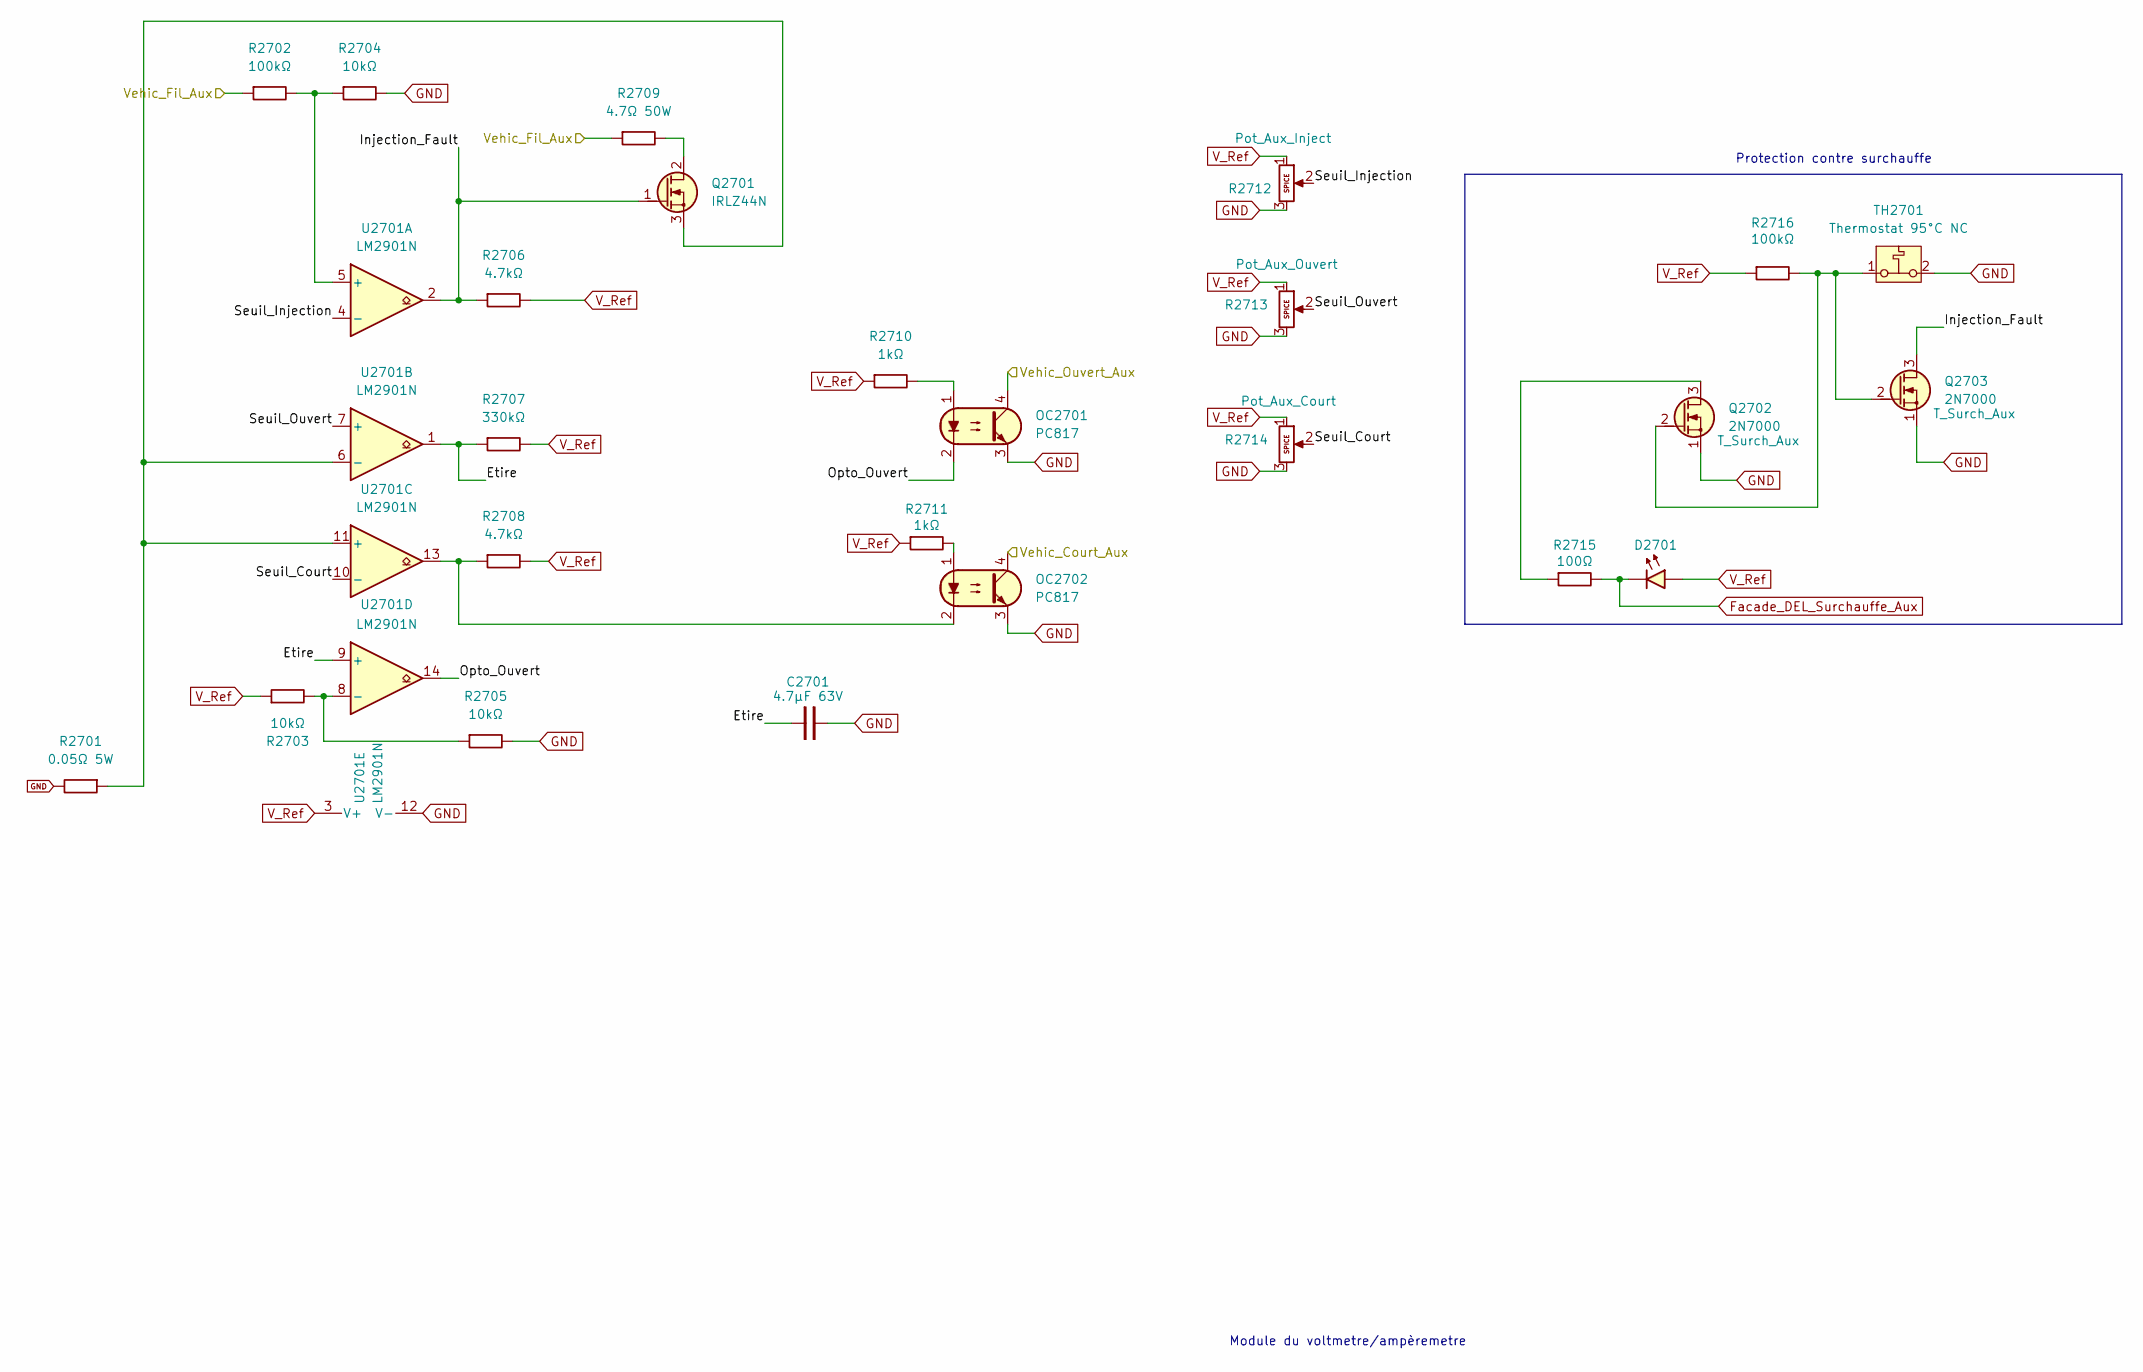
[picture p39: schematic Vehicule_Aux.kicad_sch]

Parts:
C2701: 4.7µF 63V; C_Rect_L19.0mm_W7.0mm_P15.00mm_MKS4; MPN MKS4C044704D00KSSD 10%
D2701: RGB 5mm CA (ambre); LED_D5.0mm-4_RGB_Staggered_Pins; MPN WP154A4SEJ3VBDZGW/CA
OC2701, OC2702: PC817; DIP-4_W7.62mm_LongPads
Q2701: IRLZ44N; TO-220-3_Vertical_GDS
Q2702, Q2703: 2N7000; TO-92_Inline_Wide_SGD
R2701: 0.05Ω 5W; R_Axial_Power_L25.0mm_W9.0mm_P27.94mm; MPN 15FR050E
R2702, R2716: 100kΩ; R_Axial_DIN0207_L6.3mm_D2.5mm_P10.16mm_Horizontal
R2703, R2704, R2705: 10kΩ; R_Axial_DIN0207_L6.3mm_D2.5mm_P10.16mm_Horizontal
R2706, R2708: 4.7kΩ; R_Axial_DIN0207_L6.3mm_D2.5mm_P10.16mm_Horizontal
R2707: 330kΩ; R_Axial_DIN0207_L6.3mm_D2.5mm_P10.16mm_Horizontal
R2709: 4.7Ω 50W; TerminalBlock_Phoenix_PT-1,5-2-3.5-H_1x02_P3.50mm_Horizontal; MPN HSA504R7J
R2710, R2711: 1kΩ; R_Axial_DIN0207_L6.3mm_D2.5mm_P10.16mm_Horizontal
R2712, R2713, R2714: 10kΩ; TRIM_3296W1103LF; MPN 3296W-1-103LF
R2715: 100Ω; R_Axial_DIN0207_L6.3mm_D2.5mm_P10.16mm_Horizontal
TH2701: Thermostat 95°C NC; TerminalBlock_Phoenix_PT-1,5-2-3.5-H_1x02_P3.50mm_Horizontal; MPN CS709525Y
U2701: LM2901N; DIP-14_W7.62mm_Socket

Connections:
/Canal_Aux/Bloc_Test_Aux/Vehic_Court_Aux: OC2702.4; also elsewhere on the board
/Canal_Aux/Bloc_Test_Aux/Vehic_Ouvert_Aux: OC2701.4; also elsewhere on the board
/Canal_Aux/Vehicule_Aux/Etire: C2701.1, R2707.1, U2701.1, U2701.9 (+)
/Canal_Aux/Vehicule_Aux/Injection_Fault: Q2701.1 (G), Q2703.3 (D), R2706.1, U2701.2
/Canal_Aux/Vehicule_Aux/Opto_Ouvert: OC2701.2, U2701.14
/Canal_Aux/Vehicule_Aux/Seuil_Court: R2714.2, U2701.10 (-)
/Canal_Aux/Vehicule_Aux/Seuil_Injection: R2712.2, U2701.4 (-)
/Canal_Aux/Vehicule_Aux/Seuil_Ouvert: R2713.2, U2701.7 (+)
/Vehic_Fil_Aux: R2702.1, R2709.1; also elsewhere on the board
Facade_DEL_Surchauffe_Aux: D2701.1 (K), R2715.2; also elsewhere on the board
GND: C2701.2, OC2701.3, OC2702.3, Q2702.1 (S), Q2703.1 (S), R2701.2, R2704.2, R2705.2, R2712.3, R2713.3, R2714.3, TH2701.2, U2701.12 (V-); also elsewhere on the board
unnamed: OC2701.1, R2710.2
unnamed: OC2702.1, R2711.2
unnamed: OC2702.2, R2708.1, U2701.13
unnamed: Q2701.2 (D), R2709.2
unnamed: Q2701.3 (S), R2701.1, U2701.6 (-), U2701.11 (+)
unnamed: Q2702.3 (D), R2715.1
unnamed: Q2702.2 (G), Q2703.2 (G), R2716.2, TH2701.1
unnamed: R2702.2, R2704.1, U2701.5 (+)
unnamed: R2703.2, R2705.1, U2701.8 (-)
V_Ref: D2701.2 (A), R2703.1, R2706.2, R2707.2, R2708.2, R2710.1, R2711.1, R2712.1, R2713.1, R2714.1, R2716.1, U2701.3 (V+); also elsewhere on the board

Notes on the sheet:
Protection contre surchauffe
Module du voltmetre/ampèremetre

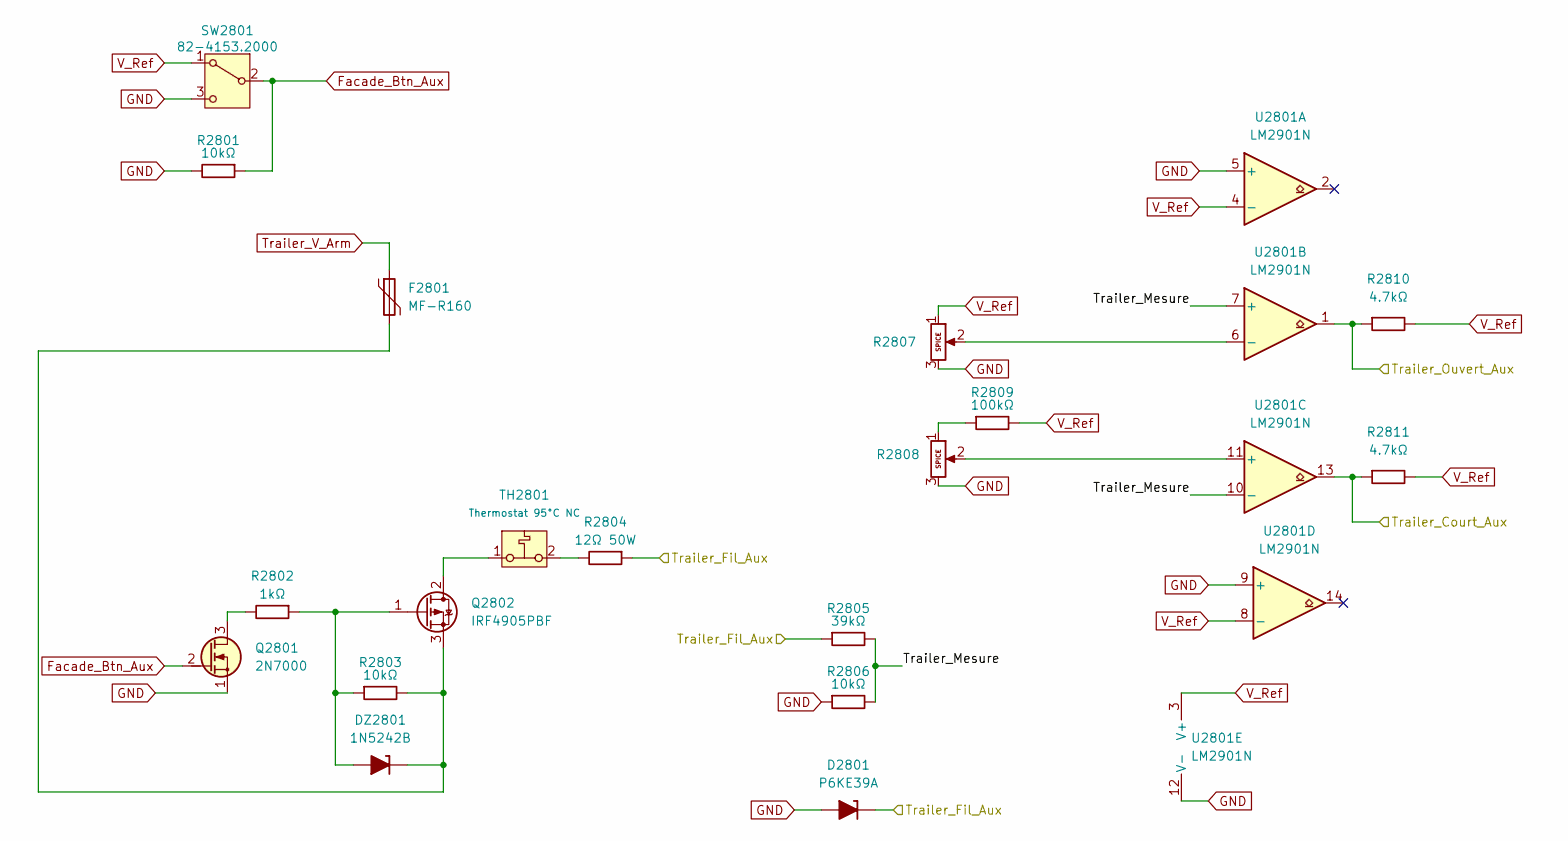
[picture p40: schematic Trailer_Aux.kicad_sch]

Parts:
D2801: P6KE39A; D_DO-15_P10.16mm_Horizontal_Zener
DZ2801: 1N5242B; D_DO-35_SOD27_P7.62mm_Horizontal_Zener
F2801: MF-R160; PTC_Bourns_MF-R_P5.10mm_W12.0mm
Q2801: 2N7000; TO-92_Inline_Wide_SGD
Q2802: IRF4905PBF; TO-220-3_Vertical
R2801, R2803, R2806: 10kΩ; R_Axial_DIN0207_L6.3mm_D2.5mm_P10.16mm_Horizontal
R2802: 1kΩ; R_Axial_DIN0207_L6.3mm_D2.5mm_P10.16mm_Horizontal
R2804: 12Ω 50W; TerminalBlock_Phoenix_PT-1,5-2-3.5-H_1x02_P3.50mm_Horizontal; MPN HSA5012RJ
R2805: 39kΩ; R_Axial_DIN0207_L6.3mm_D2.5mm_P10.16mm_Horizontal
R2807, R2808: 10kΩ; TRIM_3296W1103LF; MPN 3296W-1-103LF
R2809: 100kΩ; R_Axial_DIN0207_L6.3mm_D2.5mm_P10.16mm_Horizontal
R2810, R2811: 4.7kΩ; R_Axial_DIN0207_L6.3mm_D2.5mm_P10.16mm_Horizontal
SW2801: 82-4153.2000
TH2801: Thermostat 95°C NC; TerminalBlock_Phoenix_PT-1,5-2-3.5-H_1x02_P3.50mm_Horizontal; MPN CS709525Y
U2801: LM2901N; DIP-14_W7.62mm_Socket

Connections:
/Canal_Aux/Bloc_Test_Aux/Trailer_Court_Aux: R2811.1, U2801.13; also elsewhere on the board
/Canal_Aux/Bloc_Test_Aux/Trailer_Ouvert_Aux: R2810.1, U2801.1; also elsewhere on the board
/Canal_Aux/Trailer_Aux/Trailer_Mesure: R2805.2, R2806.2, U2801.7 (+), U2801.10 (-)
/Trailer_Fil_Aux: D2801.1 (K), R2804.1, R2805.1; also elsewhere on the board
Facade_Btn_Aux: Q2801.2 (G), R2801.1, SW2801.2 (B); also elsewhere on the board
GND: D2801.2 (A), Q2801.1 (S), R2801.2, R2806.1, R2807.3, R2808.3, SW2801.3 (C), U2801.5 (+), U2801.9 (+), U2801.12 (V-); also elsewhere on the board
unnamed: DZ2801.2 (A), Q2802.1 (G), R2802.1, R2803.1
unnamed: DZ2801.1 (K), F2801.2, Q2802.3 (S), R2803.2
unnamed: Q2801.3 (D), R2802.2
unnamed: Q2802.2 (D), TH2801.1
unnamed: R2804.2, TH2801.2
unnamed: R2808.1, R2809.1
unnamed: R2807.2, U2801.6 (-)
unnamed: R2808.2, U2801.11 (+)
Trailer_V_Arm: F2801.1; also elsewhere on the board
V_Ref: R2807.1, R2809.2, R2810.2, R2811.2, SW2801.1 (A), U2801.3 (V+), U2801.4 (-), U2801.8 (-); also elsewhere on the board

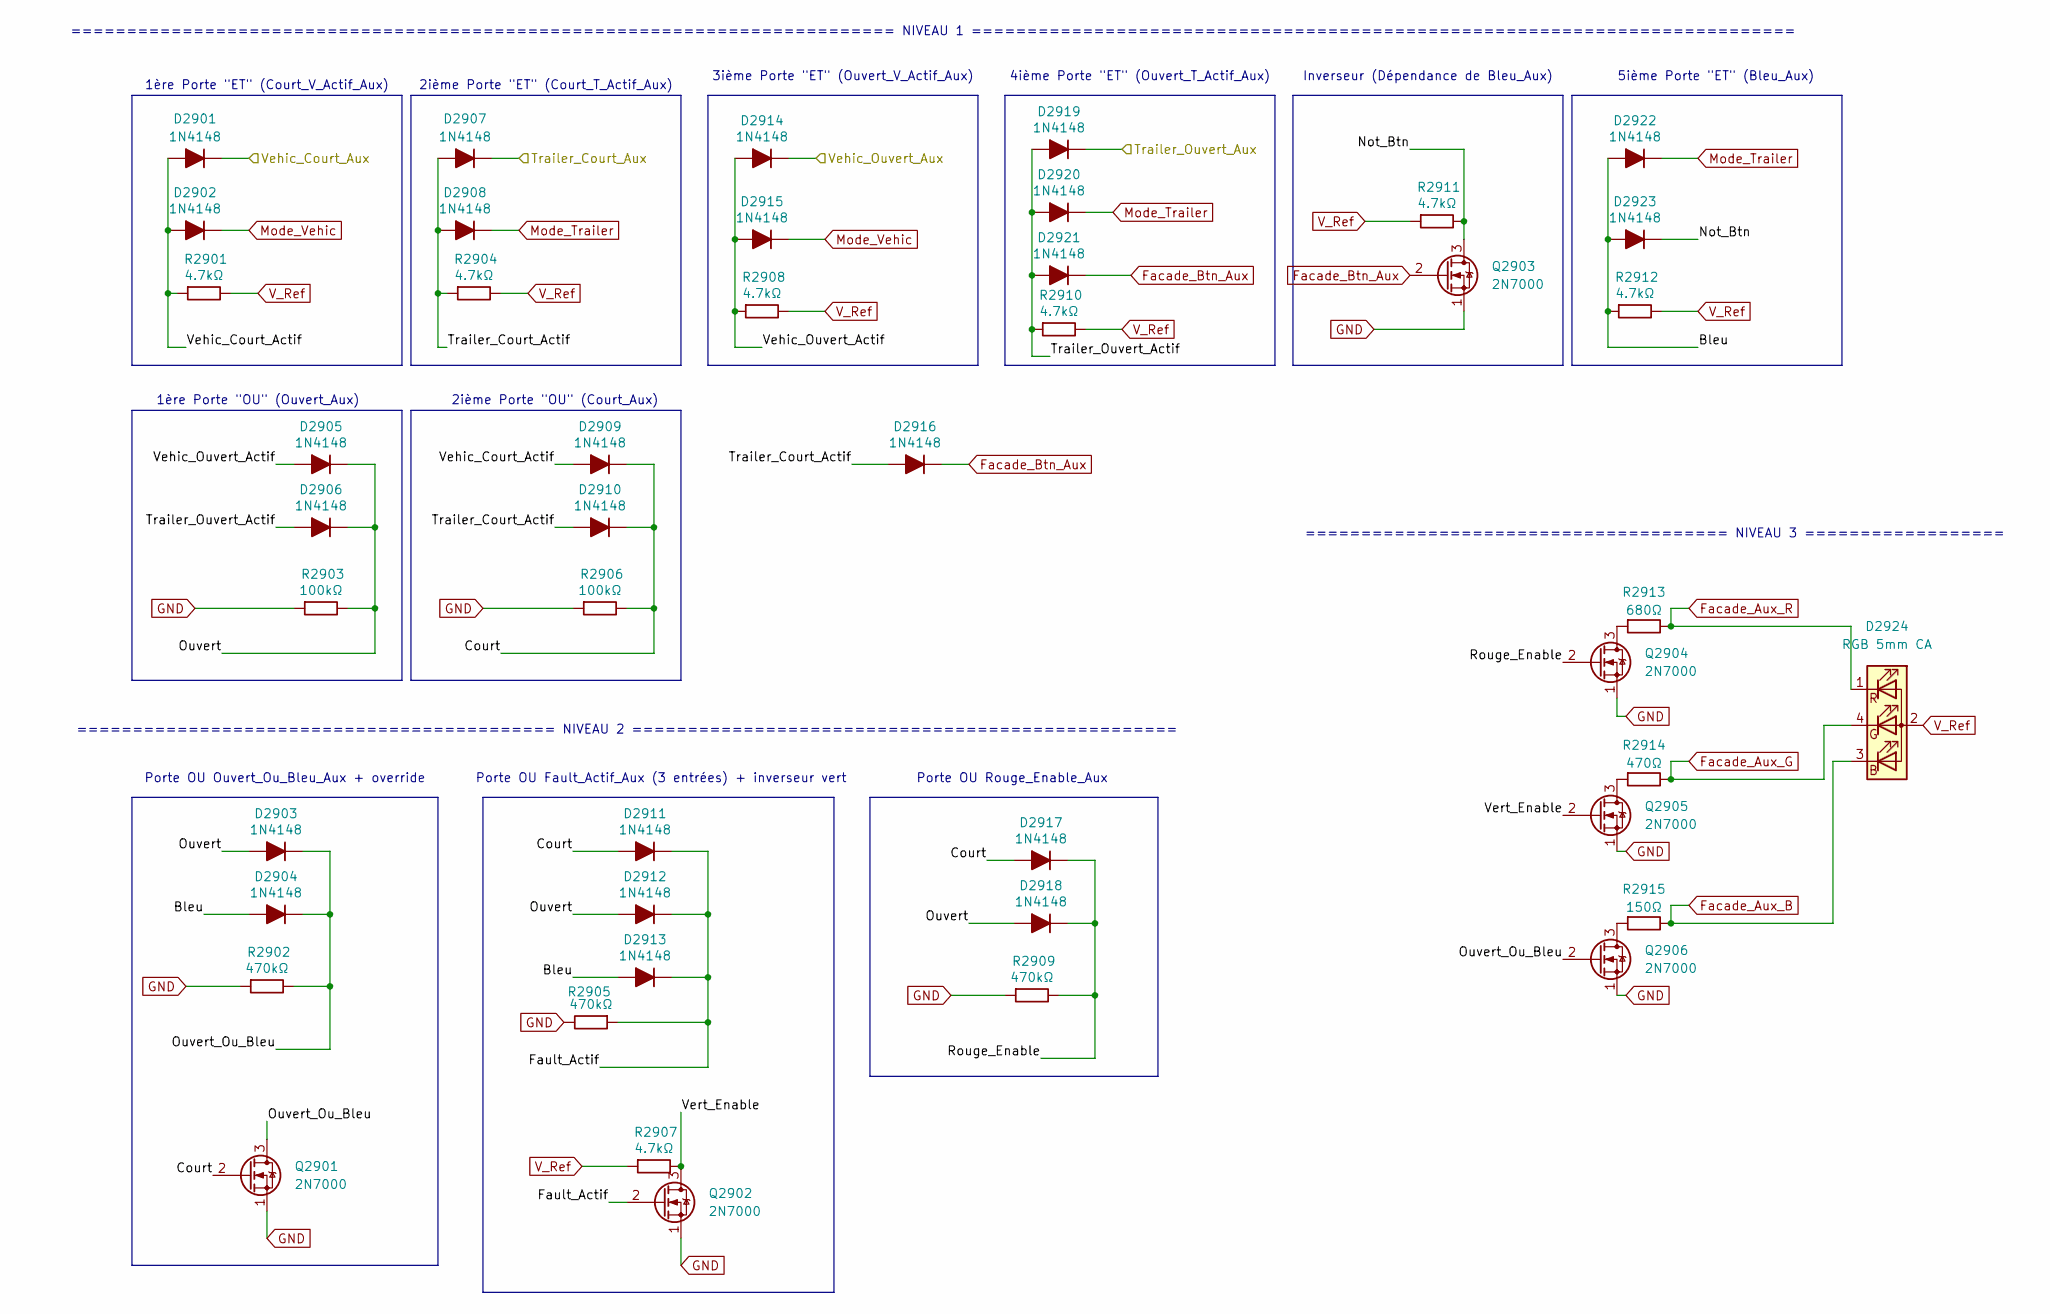
[picture p41: schematic Bloc_Test_Aux.kicad_sch]

Parts:
D2901, D2902, D2903, D2904, D2905, D2906, D2907, D2908, D2909, D2910, D2911, D2912, D2913, D2914, D2915, D2916, D2917, D2918, D2919, D2920, D2921, D2922, D2923: 1N4148; D_DO-35_SOD27_P7.62mm_Horizontal
D2924: RGB 5mm CA; LED_D5.0mm-4_RGB_Staggered_Pins; MPN WP154A4SEJ3VBDZGW/CA
Q2901, Q2902, Q2903, Q2904, Q2905, Q2906: 2N7000; TO-92_Inline_Wide_SGD
R2901, R2904, R2907, R2908, R2910, R2911, R2912: 4.7kΩ; R_Axial_DIN0207_L6.3mm_D2.5mm_P10.16mm_Horizontal
R2902, R2905, R2909: 470kΩ; R_Axial_DIN0207_L6.3mm_D2.5mm_P10.16mm_Horizontal
R2903, R2906: 100kΩ; R_Axial_DIN0207_L6.3mm_D2.5mm_P10.16mm_Horizontal
R2913: 680Ω; R_Axial_DIN0207_L6.3mm_D2.5mm_P10.16mm_Horizontal
R2914: 470Ω; R_Axial_DIN0207_L6.3mm_D2.5mm_P10.16mm_Horizontal
R2915: 150Ω; R_Axial_DIN0207_L6.3mm_D2.5mm_P10.16mm_Horizontal

Connections:
/Canal_Aux/Bloc_Test_Aux/Bleu: D2904.2 (A), D2913.2 (A), D2922.2 (A), D2923.2 (A), R2912.1
/Canal_Aux/Bloc_Test_Aux/Court: D2909.1 (K), D2910.1 (K), D2911.2 (A), D2917.2 (A), Q2901.2 (G), R2906.2
/Canal_Aux/Bloc_Test_Aux/Fault_Actif: D2911.1 (K), D2912.1 (K), D2913.1 (K), Q2902.2 (G), R2905.1
/Canal_Aux/Bloc_Test_Aux/Not_Btn: D2923.1 (K), Q2903.3 (D), R2911.2
/Canal_Aux/Bloc_Test_Aux/Ouvert: D2903.2 (A), D2905.1 (K), D2906.1 (K), D2912.2 (A), D2918.2 (A), R2903.2
/Canal_Aux/Bloc_Test_Aux/Ouvert_Ou_Bleu: D2903.1 (K), D2904.1 (K), Q2901.3 (D), Q2906.2 (G), R2902.2
/Canal_Aux/Bloc_Test_Aux/Rouge_Enable: D2917.1 (K), D2918.1 (K), Q2904.2 (G), R2909.2
/Canal_Aux/Bloc_Test_Aux/Trailer_Court_Actif: D2907.2 (A), D2908.2 (A), D2910.2 (A), D2916.2 (A), R2904.1
/Canal_Aux/Bloc_Test_Aux/Trailer_Court_Aux: D2907.1 (K); also elsewhere on the board
/Canal_Aux/Bloc_Test_Aux/Trailer_Ouvert_Actif: D2906.2 (A), D2919.2 (A), D2920.2 (A), D2921.2 (A), R2910.1
/Canal_Aux/Bloc_Test_Aux/Trailer_Ouvert_Aux: D2919.1 (K); also elsewhere on the board
/Canal_Aux/Bloc_Test_Aux/Vehic_Court_Actif: D2901.2 (A), D2902.2 (A), D2909.2 (A), R2901.1
/Canal_Aux/Bloc_Test_Aux/Vehic_Court_Aux: D2901.1 (K); also elsewhere on the board
/Canal_Aux/Bloc_Test_Aux/Vehic_Ouvert_Actif: D2905.2 (A), D2914.2 (A), D2915.2 (A), R2908.1
/Canal_Aux/Bloc_Test_Aux/Vehic_Ouvert_Aux: D2914.1 (K); also elsewhere on the board
/Canal_Aux/Bloc_Test_Aux/Vert_Enable: Q2902.3 (D), Q2905.2 (G), R2907.2
Facade_Aux_B: D2924.3 (BK), R2915.2; also elsewhere on the board
Facade_Aux_G: D2924.4 (GK), R2914.2; also elsewhere on the board
Facade_Aux_R: D2924.1 (RK), R2913.2; also elsewhere on the board
Facade_Btn_Aux: D2916.1 (K), D2921.1 (K), Q2903.2 (G); also elsewhere on the board
GND: Q2901.1 (S), Q2902.1 (S), Q2903.1 (S), Q2904.1 (S), Q2905.1 (S), Q2906.1 (S), R2902.1, R2903.1, R2905.2, R2906.1, R2909.1; also elsewhere on the board
Mode_Trailer: D2908.1 (K), D2920.1 (K), D2922.1 (K); also elsewhere on the board
Mode_Vehic: D2902.1 (K), D2915.1 (K); also elsewhere on the board
unnamed: Q2904.3 (D), R2913.1
unnamed: Q2905.3 (D), R2914.1
unnamed: Q2906.3 (D), R2915.1
V_Ref: D2924.2 (A), R2901.2, R2904.2, R2907.1, R2908.2, R2910.2, R2911.1, R2912.2; also elsewhere on the board

Notes on the sheet:
1ère Porte "ET" (Court_V_Actif_Aux)
========================================================================== NIVEAU 1 ==========================================================================
Porte OU Rouge_Enable_Aux
Inverseur (Dépendance de Bleu_Aux)
4ième Porte "ET" (Ouvert_T_Actif_Aux)
====================================== NIVEAU 3 ==================
1ère Porte "OU" (Ouvert_Aux)
Porte OU Ouvert_Ou_Bleu_Aux + override
5ième Porte "ET" (Bleu_Aux)
2ième Porte "OU" (Court_Aux)
3ième Porte "ET" (Ouvert_V_Actif_Aux)
Porte OU Fault_Actif_Aux (3 entrées) + inverseur vert
2ième Porte "ET" (Court_T_Actif_Aux)
=========================================== NIVEAU 2 =================================================
