patricecouillard-code/TrailerDiagnosticSystem/TrailerDiagnosticSystem.kicad_pcb

## KiCad design TrailerDiagnosticSystem.kicad_pcb (continued)

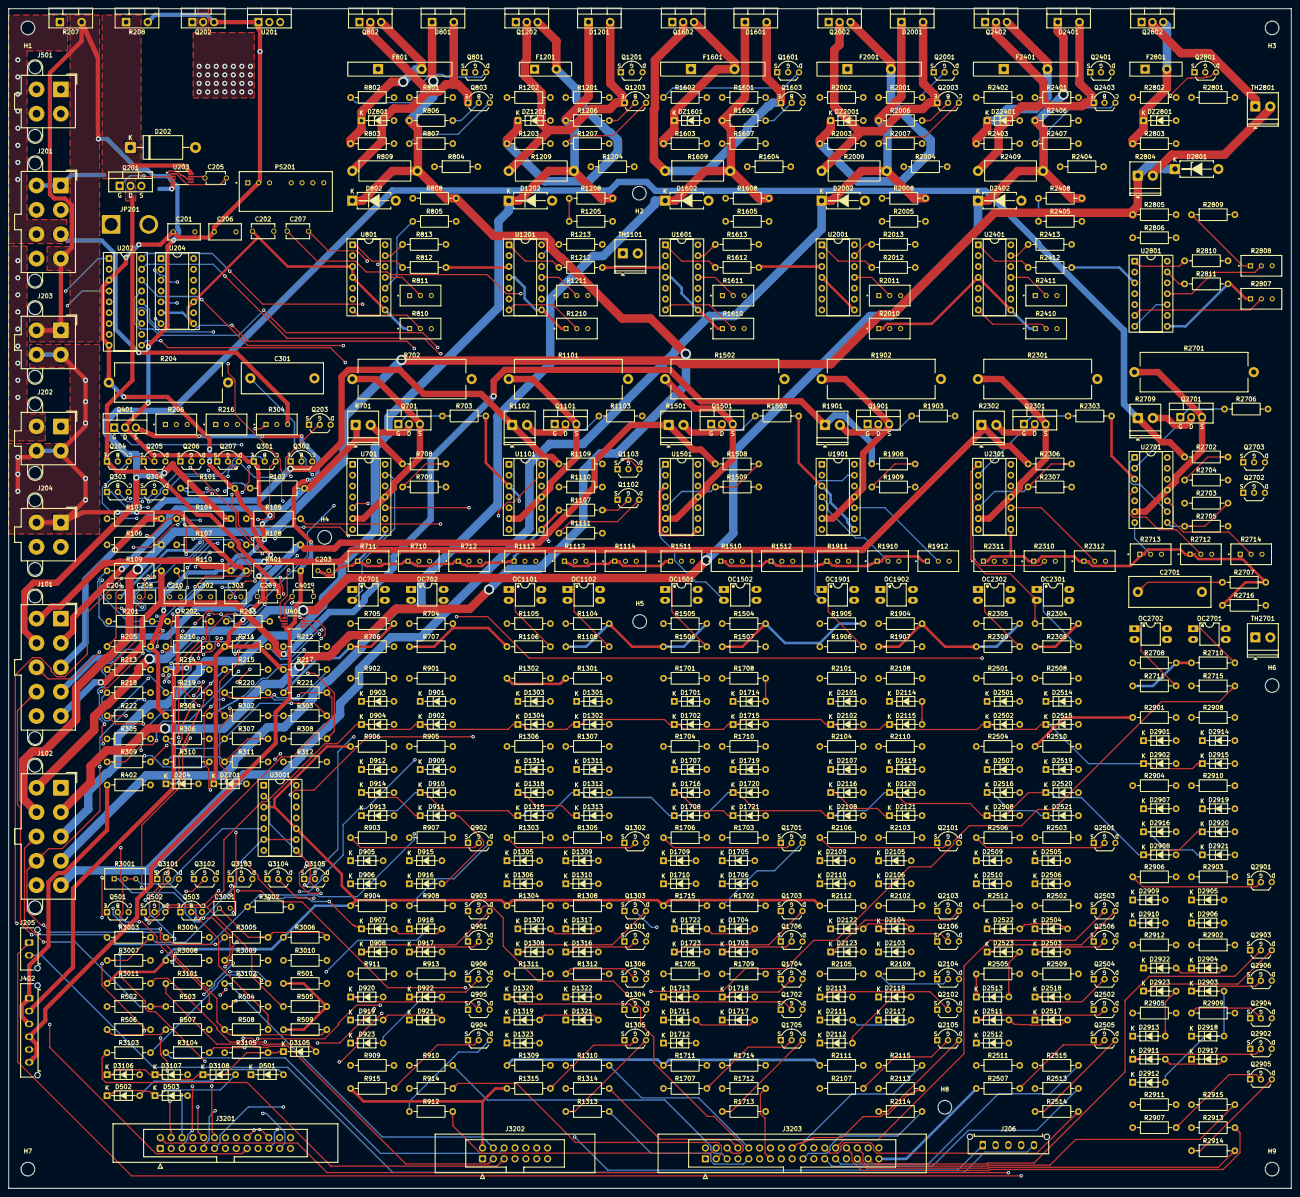
[picture p42: board TrailerDiagnosticSystem.kicad_pcb from above]

Board: 4 copper layers, 300.3 x 276.2 mm, 641 parts (0 on the bottom side), 383 nets.

Other parts of the board:
H1, H2, H3, H4, H5, H6, H7, H8, H9: M3; MountingHole_3.2mm_M3
