patricecouillard-code/TrailerDiagnosticSystem/Facade/Facade.kicad_pcb

## KiCad design Facade/Facade.kicad_pcb (2026-11-07)

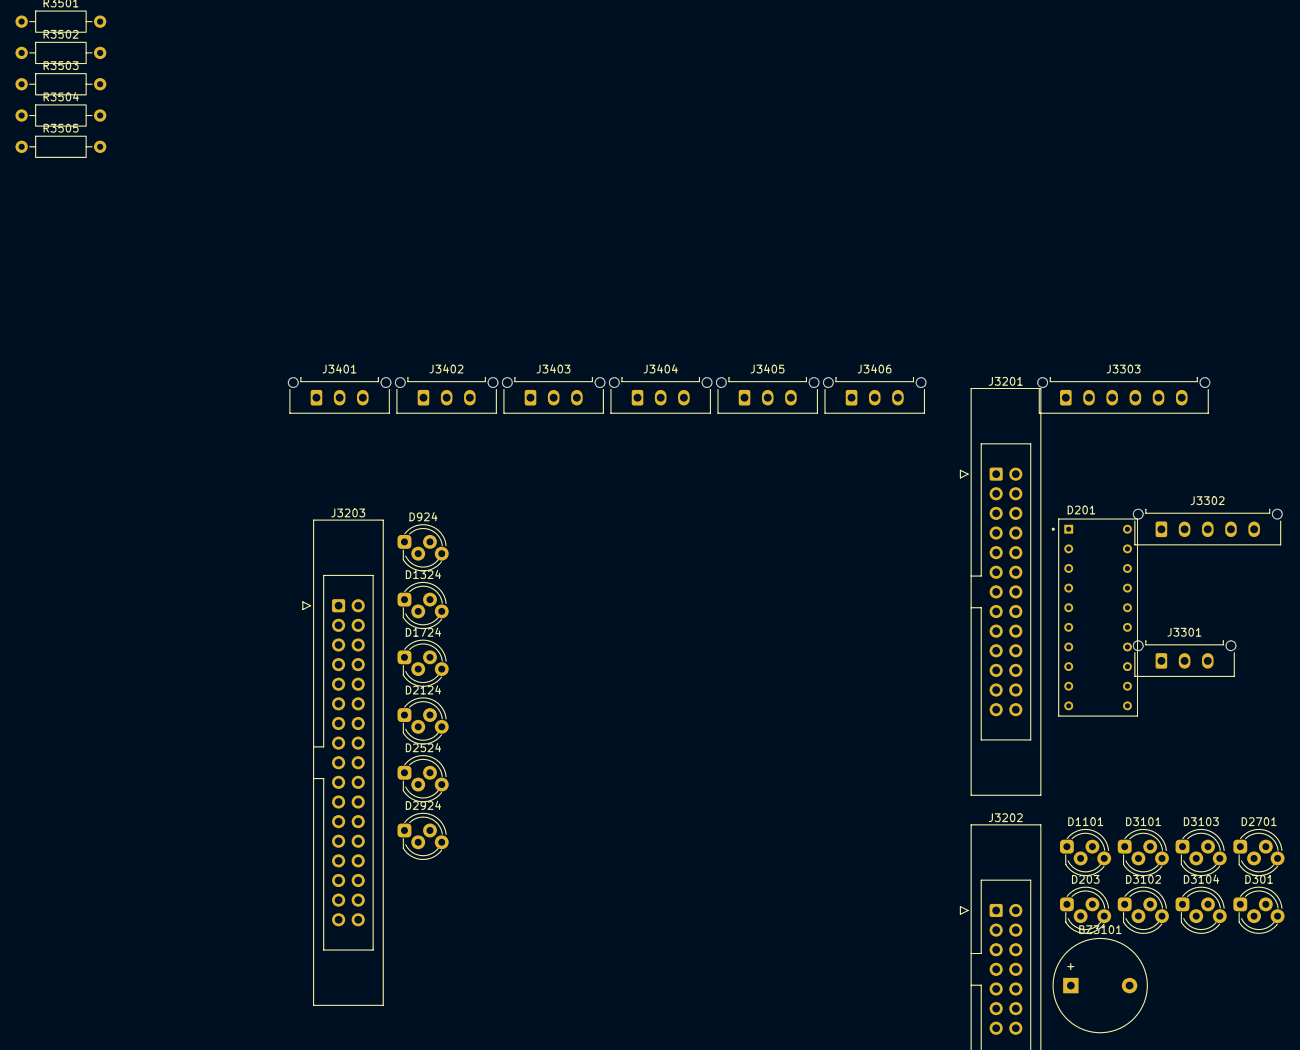
[picture p43: board Facade.kicad_pcb from above]

Board: 2 copper layers, 33 parts (0 on the bottom side), 65 nets, no tracks yet.

Parts:
BZ3101: Buzzer 5V; Buzzer_12x9.5RM7.6
D201: OSX10201-GYR1; DIP760W45P254L2550H815Q20B
D203, D3101, D3102, D3103, D3104: RGB 5mm CA (rouge); LED_D5.0mm-4_RGB_Staggered_Pins
D301, D1101, D2701: RGB 5mm CA (ambre); LED_D5.0mm-4_RGB_Staggered_Pins
D924, D1324, D1724, D2124, D2524, D2924: RGB 5mm CA; LED_D5.0mm-4_RGB_Staggered_Pins
J3201: IDC 2x13; IDC-Header_2x13_P2.54mm_Latch_Vertical
J3202: IDC 2x07; IDC-Header_2x07_P2.54mm_Latch_Vertical
J3203: IDC 2x17; IDC-Header_2x17_P2.54mm_Latch_Vertical
J3301, J3401, J3402, J3403, J3404, J3405, J3406: Micro-Fit 3.0 1x03; Molex_Micro-Fit_3.0_43650-0315_1x03_P3.00mm_Vertical
J3302: Micro-Fit 3.0 1x05; Molex_Micro-Fit_3.0_43650-0515_1x05_P3.00mm_Vertical
J3303: Micro-Fit 3.0 1x06; Molex_Micro-Fit_3.0_43650-0615_1x06_P3.00mm_Vertical
R3501, R3503: 820Ω; R_Axial_DIN0207_L6.3mm_D2.5mm_P10.16mm_Horizontal
R3502, R3504: 1.2kΩ; R_Axial_DIN0207_L6.3mm_D2.5mm_P10.16mm_Horizontal
R3505: 270Ω; R_Axial_DIN0207_L6.3mm_D2.5mm_P10.16mm_Horizontal

Connections:
/Bottom_Zone/Batt_Ext_Rouge: D301.1 (RK), R3505.1
/Bottom_Zone/Facade_Buzzer: BZ3101.2 (-), J3202.9
/Bottom_Zone/Facade_DEL_Batt_Ext: D301.2 (A), J3202.13
/Bottom_Zone/Facade_DEL_Court_Bus: D3102.1 (RK), J3202.4
/Bottom_Zone/Facade_DEL_Incoherence: D3103.1 (RK), J3202.5
/Bottom_Zone/Facade_DEL_Inversion: D203.1 (RK), J3202.7
/Bottom_Zone/Facade_DEL_Masse: D3104.1 (RK), J3202.6
/Bottom_Zone/Facade_DEL_Surchauffe_Aux: J3202.12, R3503.2, R3504.2
/Bottom_Zone/Facade_DEL_Surchauffe_Brake: J3202.11, R3501.2, R3502.2
/Bottom_Zone/Facade_DEL_Surtension: D3101.1 (RK), J3202.3
/Bottom_Zone/Surchauffe_Aux_Rouge: D2701.1 (RK), R3503.1
/Bottom_Zone/Surchauffe_Aux_Vert: D2701.4 (GK), R3504.1
/Bottom_Zone/Surchauffe_Brake_Rouge: D1101.1 (RK), R3501.1
/Bottom_Zone/Surchauffe_Brake_Vert: D1101.4 (GK), R3502.1
/Bottom_Zone/V_Ref: BZ3101.1 (+), D1101.2 (A), D2701.2 (A), D3101.2 (A), D3102.2 (A), D3103.2 (A), D3104.2 (A), J3202.2
/Center_Zone/Facade_Aux_B: D2924.3 (BK), J3203.30
/Center_Zone/Facade_Aux_G: D2924.4 (GK), J3203.29
/Center_Zone/Facade_Aux_R: D2924.1 (RK), J3203.28
/Center_Zone/Facade_Backup_B: D2524.3 (BK), J3203.25
/Center_Zone/Facade_Backup_G: D2524.4 (GK), J3203.24
/Center_Zone/Facade_Backup_R: D2524.1 (RK), J3203.23
/Center_Zone/Facade_Brake_B: D1324.3 (BK), J3203.10
/Center_Zone/Facade_Brake_G: D1324.4 (GK), J3203.9
/Center_Zone/Facade_Brake_R: D1324.1 (RK), J3203.8
/Center_Zone/Facade_Btn_Aux: J3203.31, J3406.2
/Center_Zone/Facade_Btn_Backup: J3203.26, J3405.2
/Center_Zone/Facade_Btn_Brake: J3203.11, J3402.2
/Center_Zone/Facade_Btn_Left: J3203.16, J3403.2
/Center_Zone/Facade_Btn_Right: J3203.21, J3404.2
/Center_Zone/Facade_Btn_Tail: J3203.6, J3401.2
/Center_Zone/Facade_Left_B: D1724.3 (BK), J3203.15
/Center_Zone/Facade_Left_G: D1724.4 (GK), J3203.14
/Center_Zone/Facade_Left_R: D1724.1 (RK), J3203.13
/Center_Zone/Facade_Right_B: D2124.3 (BK), J3203.20
/Center_Zone/Facade_Right_G: D2124.4 (GK), J3203.19
/Center_Zone/Facade_Right_R: D2124.1 (RK), J3203.18
/Center_Zone/Facade_Tail_B: D924.3 (BK), J3203.5
/Center_Zone/Facade_Tail_G: D924.4 (GK), J3203.4
/Center_Zone/Facade_Tail_R: D924.1 (RK), J3203.3
/Center_Zone/V_Ref: D924.2 (A), D1324.2 (A), D1724.2 (A), D2124.2 (A), D2524.2 (A), D2924.2 (A), J3203.2, J3203.33, J3401.1, J3402.1, J3403.1, J3404.1, J3405.1, J3406.1
/Top_Zone/Facade_Jauge_1: D201.11, J3201.17
/Top_Zone/Facade_Jauge_2: D201.12, J3201.18
/Top_Zone/Facade_Jauge_3: D201.13, J3201.19
/Top_Zone/Facade_Jauge_4: D201.14, J3201.20
/Top_Zone/Facade_Jauge_5: D201.15, J3201.21
/Top_Zone/Facade_Jauge_6: D201.16, J3201.22
/Top_Zone/Facade_Jauge_7: D201.17, J3201.23
/Top_Zone/Facade_Jauge_8: D201.18, J3201.24
/Top_Zone/Facade_Jauge_9: D201.19, J3201.25
/Top_Zone/Facade_Jauge_10: D201.20, J3201.26
/Top_Zone/Facade_VLed_Jauge: D201.1, D201.2, D201.3, D201.4, D201.5, D201.6, D201.7, D201.8, D201.9, D201.10, J3201.16
/Top_Zone/Facade_VM_Mesure: J3201.2, J3302.5
/Top_Zone/Facade_VM_Sel_Batt: J3201.4, J3303.1
/Top_Zone/Facade_VM_Sel_Trailer_Aux: J3201.12, J3302.3
/Top_Zone/Facade_VM_Sel_Trailer_Pince: J3201.13, J3302.4
/Top_Zone/Facade_VM_Sel_Vehic_Aux: J3201.10, J3302.1
/Top_Zone/Facade_VM_Sel_Vehic_Backup: J3201.9, J3303.6
/Top_Zone/Facade_VM_Sel_Vehic_Brake: J3201.6, J3303.3
/Top_Zone/Facade_VM_Sel_Vehic_Left: J3201.7, J3303.4
/Top_Zone/Facade_VM_Sel_Vehic_Pince: J3201.11, J3302.2
/Top_Zone/Facade_VM_Sel_Vehic_Right: J3201.8, J3303.5
/Top_Zone/Facade_VM_Sel_Vehic_Tail: J3201.5, J3303.2
/Top_Zone/Mode_Trailer: J3201.14, J3301.2
/Top_Zone/V_Ref: J3201.15, J3301.3
GND: D203.2 (A), D301.4 (GK), J3201.1, J3201.3, J3202.1, J3202.8, J3202.10, J3202.14, J3203.1, J3203.7, J3203.12, J3203.17, J3203.22, J3203.27, J3203.32, J3203.34, J3301.1, J3401.3, J3402.3, J3403.3, J3404.3, J3405.3, J3406.3, R3505.2
